vortexcodes/deadmau5-helmet/docs/why-songs-stop-review.md

# Why songs stop: the code review of 31 Oct 2026

Three read-only reviewers. Their skeptics were stopped before finishing, so nothing here is independently confirmed, and some items are already fixed (see HANDOFF.md). Line numbers are from that morning.

## [high] Weak home Wi-Fi: the socket hangs or dies mid-song and the page does not notice

- **Where:** Line numbers as of 12:58 PDT; ui.js and mau5offline.py are being edited by other sessions, so function names are given too.
remote/offline/wire.js:536-579 (_openSocket), 614-622 (reopen), 915-931 (busy), 935-938 (send)
remote/offline/ui.js:185-203 (watchLink), 224-232 (step)
(scratch)/wled1601/udp.cpp:441-455, 485
(scratch)/wled1601/FX_fcn.cpp:1695-1701
(scratch)/wled1601/network.cpp:440-448
(scratch)/wled1601/wled.cpp:510, 700, 713-714, 947-951
(scratch)/fwbuild/WLED/.pio/libdeps/esp32_eth/AsyncTCP/src/AsyncTCP.cpp:1086-1096
(scratch)/fwbuild/WLED/.pio/libdeps/esp32_eth/ESPAsyncWebServerWLED/src/AsyncWebSocket.cpp:510-513
Evidence: (scratch)/uptime.log
- **Trigger:** The controller is on a different access point from every earlier reading. Today it is on BSSID E0:63:DA:71:F4:EF, channel 6, at -84 to -95 dBm. From Oct 27 to Oct 30 it was on E0:63:DA:84:03:1E, channels 1 and 11, at -52 to -66 dBm. In uptime.log up to 12:58, 43 of 115 GETs got no answer in 4 s (37%), up to 5 in a row (about 95 s), while uptime kept rising, so these are link outages and not restarts. Only the IP path crosses this link; a phone on the helmet's own AP does not, which fits the owner's 'over IP'. The last good reading on the old AP was Fri 18:46 PDT, so this only explains an incident after that time. Ask when it happened.
- **Path:** 1. Frames stop arriving. After realtimeTimeoutMs (2500 ms, cfg if.live.timeout 25), udp.cpp:485 calls exitRealtime, and show() blends the empty frozen segments (FX_fcn.cpp:1695-1701), so the helmet goes dark.
2a. If the link stalls for 5 s, AsyncTCP's default 5 s ack timeout (AsyncTCP.cpp:1086-1096) closes the socket (AsyncWebSocket.cpp:510-513). The browser sees the close when the link returns.
2b. If the STA association drops, network.cpp:447 clears interfacesInited and wled.cpp:947-951 runs initConnection: WiFi.disconnect(true) and WiFi.mode(NULL) (wled.cpp:700, 713), then another attempt every 18 s until it joins. The netif going away aborts the sockets on the controller (lwIP behaviour, not measured), and the RST cannot reach the browser.
3. In the browser ws.readyState stays 1. busy() waits 1 s plus 1.5 s, sends 3 more frames, and repeats forever; it never closes the socket. reopen() only runs when link.ws is null (wire.js:938). watchLink says nothing while readyState is 1 (ui.js:186-193). I simulated this against a copy of wire.js: after 20 s it was the same socket, 1 open, 0 relayouts, 24 frames and about 100 kB queued.
4. In case 2b the page learns only at the next TCP retransmit, which draws an RST. Retransmit gaps double, so after a long outage the wait can be about as long again (general TCP behaviour, not measured). A reload opens a fresh connection and works at once.
- **Symptom:** LIGHTS go dark about 2.5 s after the last frame. The page shows no warning, and its preview and clock crawl at 3 frames per 2.5 s. MUSIC keeps playing: the song is a blob from IndexedDB with no network dependency. The lights come back without a reload once the link and socket recover, but a reload is the quick cure in case 2b. A reload is also what stops the song, so 'it stopped, I had to reload' fits this path. That last link is an inference.
- **Fix:** Today: ask whether the helmet moved. While idle, GET /json/net to list each AP's BSSID and RSSI. It starts a scan that takes the radio off channel, so never do it during a stream. WLED only picks the strongest AP at join time (wled.cpp:510) and never roams, so power-cycle it near the strong AP or pin nw.ins[0].bssid. If the show location is weak, use the helmet's own AP instead.
Code, wire.js: record `this._heard = performance.now()` in onopen, in onmessage and in begin(). At the top of the open-socket branch of busy(): `if (now - this._heard > 4000) { const d = this.ws; this.ws = null; this.unacked = []; this.owed = 0; this.dirty(); try { d.close(); } catch (e) {} return this.inflight >= this.maxInflight; }`. The existing reopen, _relayout and the 'lost the helmet' message then take over. Keyframes every 1 s guarantee a pong, so 4 s of silence is real. Also raise openSocket(1500) in reopen to about 3000, because a handshake on this link can exceed 1.5 s.

## [medium] A tab from before Friday 20:48: any 2.5 s gap or stray 'off' left the helmet dark until reload

- **Where:** remote/offline/wire.js:753-765, 767-784
(scratch)/wled1601/wled.cpp:109-116
(scratch)/wled1601/led.cpp:239-246
Session log: ~/.claude/projects/-Users-jones-deadmau5-app/208332e7-8c9f-4c25-bc21-e9a9df98fa1f.jsonl, 2026-10-31T02:42 and 03:48 UTC
- **Trigger:** A page loaded before the fix was deployed (Fri 20:48 PDT, 03:48 UTC), then either a 2.5 s frame gap more than a minute into a stream, or anything sending 'off'. One real instance: the main session's own hardware test sent 'off' over the owner's stream around 19:40 Friday, and said so at the time.
- **Path:** The old page re-armed the nightlight during binary streaming. WLED's loop skips handleNightlight in realtime (wled.cpp:109-116), so the timer sits overdue. The first gap ends realtime, the nightlight fires, and bri goes to 0 (led.cpp:239-246). Frames then keep arriving at a dark helmet while the old page shows a healthy frame rate, with nothing to turn it back on.
- **Symptom:** LIGHTS only, dark until stop and start or a reload. MUSIC keeps playing. This is the one path I found where a reload was truly required, and the owner's 'not sure if we fixed the crashing, I just had to reload' matches it.
- **Fix:** Already fixed: the current page keeps the nightlight off on the binary path and checks on/bri every 5 s (_keepOn). Settle it by comparing the incident time with Fri 20:48. After the final deploy, reload every open tab on every device.

## [medium] A phone on the helmet's own Wi-Fi cuts a page running on home Wi-Fi

- **Where:** (scratch)/wled1601/network.cpp:422-425
(scratch)/wled1601/wled.cpp:700, 713, 896-904, 915-924, 947-951
firmware/wled-16.0.1-keep-access-point.patch
- **Trigger:** Any device on WLED-AP while the page runs over IP. The owner's phone was on it Friday. Case (a) needs no weak signal.
- **Path:** (a) The last AP client leaves, or the softAP idle timer drops it (IDF default about 5 min; general knowledge, not read here). network.cpp:424 sets forceReconnect even though the home connection is healthy. wled.cpp:896-904 then runs initConnection, which does WiFi.disconnect(true) and mode NULL (700, 713). Home Wi-Fi and every socket on it are gone until it rejoins, then the half-open path above applies.
(b) Home Wi-Fi drops while a client is on the AP. initConnection tears the AP down. When the client rejoins, the count change reaches wled.cpp:919-920, where WiFi.disconnect() stops the search, and the next retry is 300 s later (947).
- **Symptom:** (a) LIGHTS dark for roughly 10-20 s at good signal (estimated from the code, not measured), at what looks like a random moment, or about 5 min after the phone went idle. MUSIC continues and no reload is needed.
(b) The helmet is unreachable from the laptop for up to 5 min. LIGHTS stay dark. A reload in that window fails outright and loses the page, and with it the MUSIC.
- **Fix:** For today: forget WLED-AP on the phone, or turn off its auto-join, whenever the show runs over IP. Firmware: add `&& !Network.isConnected()` to network.cpp:424. The existing keep-ap patch does not cover (a), because it keeps WiFi.disconnect(true) at line 700. It also makes (b) last for as long as a phone stays on the AP, since the search only resumes when the last client leaves. Settle it by asking whether the phone was on WLED-AP, and by the router's client log if it keeps one.

## [medium] Controller restarts: two boots today, with no stream and the LEDs off

- **Where:** (scratch)/fwbuild/WLED/wled00/util.cpp:1025-1067
(scratch)/wled1601/json.cpp:655, 840-844
remote/offline/wire.js:631-641, 767-784
(scratch)/uptime.log
Session log: ~/.claude/projects/-Users-jones-deadmau5-app/208332e7-8c9f-4c25-bc21-e9a9df98fa1f.jsonl, 2026-10-31T19:20:57 UTC
data/cal/psu/ramp.json
- **Trigger:** Power interruption or a crash. Boots at about 12:20:40 and 12:24:23 PDT, with ws=0, live=false and the helmet off (state on:false, pwr 120 before the second one). So no stream, no LED load and no client caused them.
- **Path:** A crash or brownout boot sets a one-shot code, 90 or 91 (util.cpp:1041, 1062), which the first /json/state read returns (json.cpp:655). The first state read after 12:20:40, at about 18 s, has no error key, so that boot was a power-on or a software restart, unless another device read the state first. No session log shows a restart command at that time, so the likeliest cause is power: switch, plug, connector or battery. That is an inference. The cause of 12:24:23 is unknown: the only later state read (12:51) lost its reply, and the code may already be consumed. During a stream the socket then dies as in the first finding; the page's _relayout and _keepOn restore the lights without a tap.
- **Symptom:** LIGHTS dark for roughly 10-60 s (boot plus reconnect; estimated, not measured), then back by themselves. MUSIC continues. A mid-song repeat would look like 'crashing'.
- **Fix:** Ask whether the owner cycled power at 12:20 or 12:24, and check the connector or battery. Have the uptime watcher read /json/state immediately when uptime drops and log `error`; resetReason0/1 are compiled only under WLED_DEBUG (json.cpp:840-844), so this is the only cause indicator in this build. Have hello() and _keepOn pageWarn on error 90 or 91. If the show runs on a battery, test LED load on it: the ramp test reached 33.9 W on Oct 27, and the repo does not record which supply that was.

## [low] On this link start() gives up after one failed request: the song plays and the lights never start

- **Where:** remote/offline/wire.js:644-645 (hello), 691 (begin's POST)
remote/offline/ui.js:499-508 (connect), 649 and 677-679 (start), and playTrack's unawaited `if (!state.running) start()`
- **Trigger:** One timed-out GET or POST during start, on a link where 37% of GETs currently fail. hello() needs 2 GETs and begin() needs 1 POST, which gives a rough estimate of 1 in 4 first tries succeeding at today's signal (0.63 cubed; the POST rate is assumed equal).
- **Path:** A throw in hello() makes connect() return false and start() quits. A throw from begin's POST goes to start()'s catch, which calls link.release() and quits. Nothing retries; comeBack only runs after a hide. The song is already playing because playTrack starts it first.
- **Symptom:** MUSIC plays. LIGHTS never start for that song, and the page says 'no controller at...' or 'could not start'. The owner has to tap start. Not a stop halfway through, but it will happen today if the link stays like this.
- **Fix:** In start(), when connect or begin fails while a song is playing, retry every 3 s until it succeeds or stop is pressed, reusing comeBack's timer.

## [low] A page left open on another device can knock out, or fight, the stream

- **Where:** remote/offline/ui.js:1782 (visibilitychange handler), 1813 (comeBack)
remote/offline/wire.js:832-872 (release), 767-784 (_keepOn)
- **Trigger:** A second device with the page open and previously started, such as the phone on home Wi-Fi, locking or waking while the laptop streams. /json/info showed ws 2 throughout Friday evening's stream.
- **Path:** On hide, stop() calls release(), which posts {on:false, live:false, nl off, segments deleted} over the other device's stream. On wake, comeBack() starts that page's stream without a tap, so two pages interleave DDP frames. Another session is currently changing this hide handling (hiddenStops), so recheck it.
- **Symptom:** LIGHTS blink out for up to about 5 s until _keepOn revives them, longer on a weak link where its GET fails; or the helmet flickers between two shows. MUSIC on the laptop is unaffected. No reload needed.
- **Fix:** Close the page on other devices during a show. Code: in comeBack(), skip the automatic start if /json/info says live is true, meaning somebody else is streaming.

## [low] Deploying over this link can truncate the page on the controller

- **Where:** (scratch)/wled1601/wled_server.cpp:196-226 (207, 212), 233
(scratch)/fwbuild/WLED/.pio/libdeps/esp32_eth/ESPAsyncWebServerWLED/src/WebServer.cpp:184
(scratch)/fwbuild/WLED/.pio/libdeps/esp32_eth/ESPAsyncWebServerWLED/src/WebRequest.cpp:123-124
mau5offline.py:484-511 (_upload), 543 (deploy), 829-854 (deploy_drives), 386 (songs)
- **Trigger:** Running `deploy` today at -87 dBm, with a 138 kB page and 564 kB of analyses (both still growing), or running it while somebody streams.
- **Path:** handleUpload opens the target with "w" at the first byte (207), which truncates it at once. An idle gap of 3 s (WebServer.cpp:184) closes the request and the partial file stays (WebRequest.cpp:123). _upload then tries /edit, which is GET-only on 16 (233), and exits. The page is left truncated. Write errors are also ignored (212), so an upload past the end of the filesystem still answers 'File Uploaded!'. deploy_drives has no free-space check and no read-back; deploy() has both, but only for the page. deploy() has no check for live or ws either; the guard exists only in the main session's shell commands. Separately, `songs` exits if its first GET (386) or the pointer upload fails on this link.
- **Symptom:** Unlikely to be what the owner saw, but a high risk for today. The next page load is blank or fails decoding, so neither MUSIC nor LIGHTS can start until a redeploy, on the AP as well. A deploy during a stream also starves frames, so LIGHTS stutter or go dark for the length of the upload.
- **Fix:** Deploy only with strong signal, or from a laptop joined to the helmet's AP with --host 4.3.2.1. In deploy(): refuse if info.live or RSSI is below about -75 unless forced, and retry the upload until the read-back matches. In deploy_drives: check free space and read back each file.

## [low] Tonight on the helmet's own Wi-Fi: official 16.0.1 tears the AP down, and the keep-ap build is not flashed

- **Where:** (scratch)/wled1601/wled.cpp:713-714, 915-924, 947-951
firmware/README.md
firmware/WLED_16.0.1_ESP32_Ethernet_keep-ap.bin
- **Trigger:** A phone on the AP with home Wi-Fi out of range: a retry every 300 s, every 18 s with nobody on the AP. At home, any drop of the weak home link has the same effect. The session logs show the only firmware flash was the official 16.0.1 on Fri 07:13; the keep-ap curl appears only as README text.
- **Path:** wled.cpp:947-951 runs initConnection, and WiFi.mode(NULL) (713) stops the whole radio including the AP. The phone is dropped and its socket dies. stac changes from 1 to 0, which re-inits again (922), and when the phone rejoins the search is stopped (920) until the next 300 s retry.
- **Symptom:** Not the IP report, but it is the owner's Friday phone complaint. Every 5 min the LIGHTS go dark until the phone rejoins and the page reconnects. MUSIC continues. A phone may not rejoin by itself.
- **Fix:** Needs the owner's go-ahead: flash keep-ap with the page stopped, over the AP or at strong signal, never at -87 dBm. Untested option with no flash: blank the home SSID in WLED for the night. isWiFiConfigured then goes false and no retries run, but the home path is gone until it is restored.

## [low] Possible crash race: frames flowing while _relayout rebuilds segments after a restart

- **Where:** remote/offline/wire.js:614-622, 631-641
(scratch)/wled1601/json.cpp:451-466
(scratch)/wled1601/udp.cpp:477-482
(scratch)/wled1601/FX_fcn.cpp:1695-1701
(scratch)/wled1601/FX.h:909-910
- **Trigger:** A reconnect after a controller restart, when one segment becomes ten while the page is already sending binary frames. Read in the source only; not reproduced and no evidence it has happened.
- **Path:** _relayout's live:false ends realtime in the async task (json.cpp:457), and that task then appends segments (emplace_back can reallocate). strip.suspend and waitForIt only guard service(). The main loop's show() at udp.cpp:481, driven by e131NewData, walks _segments with no guard.
- **Symptom:** If it hits: a second restart seconds after the first, LIGHTS dark for longer, MUSIC unaffected.
- **Fix:** One line in the page: hold frames until _relayout settles, by setting a flag before openSocket that busy() honours and clearing it when the layout POST ends.

### Ruled out
- Music from the controller side: no controller or network path reaches the audio element. The song is a blob URL from IndexedDB, and every an.stop() or pause I found comes from a user action, el.onended or el.onerror, pickShow, or the Spotify and playlist code. Only a reload or the page dying stops it. A song that stops by itself belongs to the audio and page review.
- Test suite: test_mau5.py and tests_more/* have no path to the real controller (read, not run). Pixels only targets 127.0.0.1, 0.0.0.0 or a stub socket. find_one, _find, urlopen, fetch and WebSocket are stubbed where they would be reached (relay.py:104-107, calib.py:116-121, tools.py:211-255, ctl.py:193-198, relayout.py:20-31, page.py:139 and 613-614). binary.py and wiretest.js use a stub socket. t_lan_ip only runs ifconfig and route. The 192.168.10.172 strings in tests are fake location values.
- Background sessions: the three worktree sessions' logs have no command that contacts the helmet, only greps for addresses. The `mau5offline.py build` and test run at 12:23:47, 36 s before the 12:24:23 boot, are local. Cloud sessions cannot route to 192.168.x without mau5relay, which is not running; mau5eye only calls lan_ip. The only session that touched the helmet is the main one: deploys, hardware tests, and the Friday 'off' covered in the second finding. Its deploys since Fri 19:25 were gated on live=false by shell commands.
- Tools that scan the subnet when given no --host (mau5offline _find, mau5peek, mau5hue, mau5psu, mau5review, mau5doctor, mau5relay): the scan itself is only GET /json/info. Some of those tools then stream or write, but none is run by the tests or by the worktree sessions.
- Song server: keep_pointing makes a local UDP route lookup every 30 s, sends nothing, and only re-uploads /songs.json if the laptop's address changes. It writes once at start and once per address change, a small file. PID 54684 has run since Fri 19:25:51 and its log has no 'moved' line. Two notes: _delete sends DELETE /edit, which WLED 16 does not route, so the pointer survives Ctrl-C (harmless); and new songs need a restart of `songs`, with the old process stopped first because it holds port 8799.
- Filesystem writes during a stream: the page triggers none. Presets and cfg are only written by setupStandby, which refuses while running. Nothing writes cfg.json during a stream.
- WebSocket client limit: 8 on ESP32. cleanupClients closes the oldest only above that (AsyncWebSocket.h:51, AsyncWebSocket.cpp:916-921). Readings were 0 to 2. A reloaded tab's old socket closes on its FIN, or by the 5 s ack timeout at the next send, so sockets do not pile up. The HTTP queue's limit of 6 answers 503, not a crash.
- JSON lock: the binary path takes none, since 'p' returns before the lock (ws.cpp:40-44) and DDP and the filler never take it. _keepOn's one GET per 5 s can at worst defer. A main-loop sendDataWs waits at most 250 ms and then sends {"error":3}, which the page handles.
- Heap: 79-91 kB during Friday's stream of about 25 fps, 64-93 kB today idling on the weak link, no slide over 34 min. heapDanger needs contiguous heap under about 14 kB for 15 s (wled.cpp:185). ws.closeAll(1013) needs a failed allocation. Neither is near.
- Streaming load: boot Fri 17:36:36 lasted at least until 20:49 (11583 s) through more than an hour of binary streaming at about -60 dBm with no restart. So a stream crashing 16.0.1 is not supported at good signal.
- Watchdogs: the loop watchdog is off (wled.h:63-66), async_tcp is not watched (platformio.ini:267), and the IDF task watchdog is 10 s on idle CPU0 only. I found no multi-second blocking in the stream path.
- Bootloop detection: needs 5 crash resets each under 120 s apart (util.cpp:1043-1045), and power or software resets clear the count. Not reached.
- Brownout from LED current: the ramp test ran to 33.9 W with no reset, WLED's global limiter holds frames near 1.5 A total, and today's boots happened with LEDs off. Not excluded on a battery, which has not been tested.
- Reboot commands: rb, /reset, cfg.json upload and /update are not sent in any normal path. The one `{"rb":true}` in the logs is a scratch test on Fri 04:36.
- Filesystem room: 564 kB of analyses plus the 138 kB page against 983 kB total fits as of 12:58, but watch the total as scenes are added, since uploads past the end report success.
- Which machine: Friday's stream reported lip 192.168.10.163 (hostname macbookpro, private MAC), not this laptop at 192.168.10.225. Confirm which machine the owner means before blaming background CPU load here.

## [high] A pause from outside the page (media key, headset button, phone call, Bluetooth drop) stops the song, freezes the lights and says nothing. This is the only mid-song stop recorded on this Mac.

- **Where:** remote/offline/ui.js:1112-1124 (playTrack sets onended and onerror, no onpause); ui.js:261 (show clock is el.currentTime); ui.js:1455-1465 (showpp button, 700 ms label refresh); ui.js:1807 (the only auto-resume, on visibility return); audio.js:301 (handlers cleared on stop)
- **Trigger:** macOS media key (F8), a headset or speaker button, AirPods, or any now-playing command while the page is the active media session. On phones: a call, Siri, an alarm, another app taking audio focus, or a Bluetooth or headphone route loss.
- **Path:** Measured on this Mac (192.168.10.225), from pmset -g log and Chrome's song store for the page's origin. Chrome PID 1836 started Strobe (Dimension Remix) at 19:00:11 on Oct 30 (store write and Video Wake Lock in the same second, audio from about 19:00:12). At 19:02:11 rcd, the macOS remote-control and media-key daemon, logged com.apple.rcdevent. At 19:02:14 Chrome released 'Playing audio' after 00:02:02, about 2:00 into a 5:09 song. The Video Wake Lock from the page's muted awake video stayed until 19:05:50, so the page was alive and only the audio element had paused. Control case: leavemealone at 18:55:12 ran 00:03:43, its full 222.76 s, with no rcd event. At 19:42:40 an rcd event and a Chrome video wake-lock release land in the same second, which shows the same key pausing Chrome media on this Mac. Code path: OS command -> Chrome media session -> el.pause() with no JS involved -> no pause listener, userPaused stays false -> step() keeps reading the unchanged el.currentTime (ui.js:261) -> the show draws the same moment on every frame -> showPP relabels the button 'play' within 700 ms and nothing else is said. In the Play Music set nothing advances, because ended never fires. Limits of this evidence: the log does not say who or what caused the rcd event. It may have been a deliberate press, since other Chrome audio started at 19:04:39 and the Tiki Tiki file was downloaded at 19:07:37. It is one stop, and the owner said 'sometimes'. His stops may have been on another machine: the helmet logged 192.168.10.163 as its live sender at 19:22-19:42 and 20:07-20:32 on Oct 30, and that device fetched all six songs including Tiki. This Chrome has no Tiki copy and no store write since 19:00:13 Oct 30. The router names .163 macbookpro.localdomain, not a phone, even though this session's summary calls it the phone. To settle it, ask which machine and browser he used, and if .163 is a Mac run there: pmset -g log | grep -E 'rcdevent|Playing audio'
- **Symptom:** MUSIC stops. LIGHTS keep streaming but hold one frozen moment, with a normal fps reading. No reload needed: tapping play in the show box resumes at the same spot, while a reload loses the position (see the reload finding). Desktop Chrome: media keys and headset buttons, confirmed by the Mac's power log. iOS Safari and home-screen app: interruptions and route loss pause the element, and the audio context usually goes 'interrupted' too (see the AudioContext finding). Android Chrome: audio focus loss, or the 'becoming noisy' event when headphones or Bluetooth drop; a transient loss resumes by itself, a permanent one does not. The phone behaviours are from memory, not measured.
- **Fix:** In playTrack, beside onended: el.onpause = () => { if (an.el !== el || userPaused || el.ended) return; pageWarn('the song was paused from outside this page (media key, headphones, a call or another app) -- tap play'); showPP(); }; and add onpause to the handlers cleared at audio.js:301. The el.ended guard covers the pause event that fires at a natural end. On desktop also try if ('mediaSession' in navigator) navigator.mediaSession.setActionHandler('pause', () => {}), which stops the key reaching the element; whether that API exists on this http origin is unverified, so check in the console first. Cheap and worth having tonight: once in _fileEl(), listen for pause, waiting, stalled, error, ended, emptied and abort, plus ctx statechange, and write the last event with its time into #why, so the next stop names its own cause.

## [medium] The audio context can leave 'running' with nothing watching it, silencing an element that still reports playing. A dead context is the one path in the code that truly needs a reload.

- **Where:** remote/offline/audio.js:167 (_ctx resumes only on 'suspended', so it misses Safari's 'interrupted'); audio.js:247 and 271-279 (the sound is routed only through the context); audio.js:257 (unlock); ui.js:1806 (resume on visibility return only); ui.js:1455-1459 (showpp resumes neither the context nor anything else). There is no onstatechange or ctx error handler anywhere.
- **Trigger:** Desktop: output device failure or removal, an audio service restart, or a Bluetooth or HDMI output vanishing. iOS: any interruption, screen lock or app switch. Android: rare.
- **Path:** ctx leaves 'running' while the page is in front -> the element is wired only through createMediaElementSource, so its output goes nowhere audible -> el.paused stays false, so showPP says 'pause' and the page looks healthy. From memory of Chromium, not measured: nothing pulls the element while the context is stopped, so currentTime stalls and the lights freeze at ui.js:261. On Safari the clock may run on silently, so the lights carry on with no sound. Recovery exists only on a visibility flip, or a tap on start, Play Music, next or prev, which call unlock. On iOS the resume from visibilitychange has no gesture behind it and may not take; at that point showgo means stop, and showpp does not resume the context, so stop then start, from 0:00, is the only remedy. If the context is actually dead, an.ctx is kept for the life of the page and the single element can only ever be wired to it, so every later song is silent until a reload. That matches 'I just had to reload'. No evidence for this on this Mac: the built-in speaker session ran unbroken from 19:00:12 to 20:45:34 across the 19:02:11 stop. To settle it, watch the statechange logging suggested in the media-key finding, or on an iPhone lock the screen mid-song and come back.
- **Symptom:** MUSIC goes silent with no message. LIGHTS freeze on desktop Chrome and may keep running on Safari. Desktop Chrome: reload needed only if the context never recovers. iOS Safari and home-screen app: the most likely way to lose sound; a tap on start or Play Music recovers it, and a home-screen app may be purged and reload by itself. Android Chrome: rarely reached.
- **Fix:** Change audio.js:167 to if (this.ctx.state !== 'running' && this.ctx.state !== 'closed') this.ctx.resume(). In _ctx add this.ctx.onstatechange that attempts a resume and warns on the page. Add one capture-phase document pointerdown listener: if the context is not running, resume it; if an.el is paused, !userPaused and not ended, play it. Then any tap anywhere revives sound without restarting the song. Add a 1 Hz check: el not paused, not ended, currentTime unchanged for 3 s -> resume, then warn 'no sound: reload' if still stuck. Routing the sound straight out of the element when a show has its drive would remove this whole class, but that is too large a change for today.

## [medium] Safari only: re-storing a song at start deletes the file the audio element is still reading, so it stops once its buffer runs out. Fixed for cached plays in the working tree, still live on any page not yet redeployed and reloaded.

- **Where:** Committed playTrack (HEAD, since eaaeafc) calls tracks.put(name, file) on every show start; the working tree skips it for cached copies at remote/offline/ui.js:1133 (kept). Writes that can still replace a record: ui.js:1412 (fetchSongs, now also on a wrong-size copy) and ui.js:1439 (load all the songs). Read side: audio.js:636-638.
- **Trigger:** WebKit only, on macOS Safari, iOS Safari or a home-screen app: tap start on a song from the stored copy, with a page from before this session's changes. This is relevant only if .163 or the phone runs Safari. This Mac's Safari has no helmet origin stored.
- **Path:** tracks.get wraps the stored blob -> el.src = blob URL -> tracks.put overwrites the same key. From memory of WebKit source, unverified: the IndexedDB backend deletes the old blob file when the transaction commits, and unlike Chromium it keeps no registry of blobs still handed out. The element keeps playing what is already buffered. The next range request to the blob URL finds no file, the classic 'WebKitBlobResource error 1' in the console. The old page had no error handler, so the song stalls with lights frozen and no message. A reload reads the new copy, which fits 'I just had to reload', until the next start repeats it. How far a song gets depends on the buffer, which fits 'sometimes'. Chrome is immune by measurement: leavemealone's record was replaced at 18:55:12 on Oct 30 while it played, and audio still ran the full 00:03:43. To settle it, ask which browser .163 uses, then on Safari play one long song from the stored copy with the console open.
- **Symptom:** MUSIC stops part way through a song. LIGHTS freeze on the last moment. On the old page a reload appears to fix it, and the current page's onerror would now name the failure. Desktop Chrome and Android Chrome: not affected. macOS Safari, iOS Safari and home-screen app: affected until the new page is deployed and every open tab is reloaded.
- **Fix:** Already done for cached plays with kept at ui.js:1133. Deploy, and reload the page on every device. Add a small guard: in the fetchSongs and load-all paths, skip or defer tracks.put when name is the show currently playing, so a wrong-size re-fetch cannot replace the file under a playing song.

## [medium] A reload, crash or browser purge throws away the song, its position and the set, with no way back to where it was

- **Where:** remote/offline/ui.js:466-479 (restore ignores the saved show); ui.js:461 and 1832 (choose() at load runs save(), overwriting the saved show with an empty value); ui.js:1791 (pagehide lets go of the helmet); ui.js:1142 (the page claims 'pause and seek work', but there is no seek control)
- **Trigger:** Any reload, which is what the owner reports doing, or a tab crash, tab discard, or an iOS web-process purge or relaunch.
- **Path:** pagehide releases the helmet -> audio element and context die with the page -> on load the show list is back to 'no show' and the saved show has already been overwritten -> nothing restarts the music or the lights until someone picks a show again -> the song restarts at 0:00 and the Play Music set is forgotten. This does not cause a stop, but it turns a recoverable pause into a lost song, and 'I just had to reload' suggests that is what happened: the recorded media-key stop on this Mac needed only a tap on play.
- **Symptom:** MUSIC and LIGHTS both stop and do not come back without re-picking a show. Same on desktop Chrome, iOS Safari and Android Chrome. A home-screen app purged in the background also relaunches into this state with no tap by anyone.
- **Fix:** Every 2 s and on pagehide, save {show, at: el.currentTime, listOn} to localStorage. At load, restore the selection before choose() saves over it, and show one button: 'resume <song> at m:ss'. On tap call an.unlock(), start the song, and set el.currentTime = at once metadata is loaded, restoring list.on too. A tap is required for sound anyway. Meanwhile tell the owner: if a song stops, try the play button before reloading.

## [low] On a laptop a stray key on the last-clicked control stops or changes the song

- **Where:** remote/offline/ui.js:1062-1077 (showgo), 1648 (go, which now also stops the song), 1291 (playall), 1296 (listnext), 1056-1061 (select change -> pickShow -> an.stop at ui.js:997)
- **Trigger:** Chrome window in front with focus still on the button or select last clicked, then Space or Enter, for example the pause reflex on a laptop or typing meant for another window. On a focused select, a printable key triggers type-ahead: 'n' jumps to 'no show' and any letter can match an option with no check mark yet. On macOS, Safari does not focus buttons on click but keeps focus on the select.
- **Path:** Space or Enter on a focused button fires click -> showgo or go runs its stop branch, an.stop() -> or playall runs listEnd plus stop -> or listnext skips. On the select, type-ahead fires change -> onchange -> pickShow(new or empty) -> an.stop() at ui.js:997, or listJump during the set. Not distinguishable from outside: nothing logs it, so whether it ever happened is unknown. To settle it, ask whether he had typed or pressed Space with that window in front.
- **Symptom:** MUSIC stops at once, or jumps to another song. LIGHTS fall back to the preset or stop. No reload needed. Desktop only; iOS and Android have no keyboard in this flow.
- **Fix:** One listener: document.addEventListener('click', e => { const c = e.target.closest('button'); if (c) c.blur(); }), and e.target.blur() at the end of sel.onchange. Optionally map Space to the showpp toggle so the reflex does the expected thing.

## [low] A lost IndexedDB connection is cached forever, so every song looks missing until a reload, and the set ends at the next song boundary

- **Where:** remote/offline/audio.js:608 and 616 (this.db cached, no onclose or onversionchange), audio.js:624 (db.transaction throws on a closed connection), audio.js:638 and 657 (errors become null and an empty list); remote/offline/ui.js:1229-1240 (listSkip), ui.js:1038-1046 (startShow opens the file picker on a miss)
- **Trigger:** From memory, not measured: Safari and iOS losing the connection to the IndexedDB server after backgrounding ('Connection to Indexed Database server lost'), or a Chrome storage service restart or site-data clear.
- **Path:** Connection closes -> this.db still set -> db.transaction throws InvalidStateError inside the promise -> get returns null and keys returns [] with nothing said. In the set, the song in progress finishes -> listSkip finds nothing -> listEnd and 'no songs on this device yet'. For a single show, start opens the file picker as if the song were never saved, and the song line says 0 of N. A reload reconnects, and everything is suddenly fine again. To settle it, use a playlist on an iPhone with an app switch mid-song, then let the song finish.
- **Symptom:** MUSIC stops at the end of the current song and the set does not continue; the song already playing is not cut. LIGHTS go to the preset. A reload fixes it. Desktop Chrome: rare. iOS Safari and home-screen app: plausible after any trip to the background. Android Chrome: rare.
- **Fix:** In _open: on success set db.onclose = () => { if (this.db === db) this.db = null; } and db.onversionchange = () => { db.close(); this.db = null; }. In _tx, wrap db.transaction in try/catch, clear this.db and reopen once before giving up.

## [low] New in the working tree: a double tap on start now leaves no music, because the first start's failure stops the second start

- **Where:** remote/offline/ui.js:1144-1150 (catch added at about 12:56 calls an.stop()); remote/offline/audio.js:266-267 and 283 (useFile calls stop, then awaits el.play); ui.js:1062-1066 (showgo calls startShow while an.el is still null)
- **Trigger:** A second tap on start during the first tap's tracks.get. The read is normally milliseconds, but a busy disk stretches it and makes a second tap likely. Any second playTrack arriving while the first is awaiting el.play() behaves the same.
- **Path:** Tap 1 and tap 2 both pass the check state.showT0 === null && !an.el -> useFile #1 awaits el.play() -> useFile #2 calls this.stop(), which pauses the shared element, then sets a new src and awaits play -> #1's promise rejects with AbortError in a later task -> #1's catch calls an.stop(), which pauses #2 on the shared element, revokes its URL and clears an.el -> #2 rejects too and its catch does the same. Before this catch was added, #1 only printed a message and #2 played. listPlay is protected, because pickShow stops the first start before the second reaches useFile. This code is not deployed, so it is not what the owner saw. Traced by reading the code, not run.
- **Symptom:** MUSIC never starts, or stops immediately, with the message 'could not play that file: The play() request was interrupted'. Tapping start again works. No reload needed. Same on all platforms.
- **Fix:** At the top of the catch: if (err && err.name === 'AbortError') return false; so a superseded start leaves the newer one alone. Alternatively take a token at the start of playTrack and only call an.stop() if the token is still current.

## [low] Unproven on a real phone: the second song of the set plays through one element whose src changes while wired into the audio graph

- **Where:** remote/offline/audio.js:240-250 (_fileEl), audio.js:266-271 (useFile); remote/offline/ui.js:1112-1113 (ended -> listSkip)
- **Trigger:** Play Music on a real iPhone or Pixel when the first song ends. Page tests use FakeAudio and FakeContext, so they cannot show this.
- **Path:** Reusing one element is the right design: a phone only lets an element start itself after a tap has started it. But from memory, older iOS versions had silent-output bugs when src changed on an element already wired to a MediaElementSource. If that applies here, song 2 has a running clock and moving lights with no sound. I could not verify this without a device, and the task forbids starting browsers. To settle it, shorten nothing: on the real phone start Play Music, tap next once to reach song 2, and listen.
- **Symptom:** If the problem exists: MUSIC silent from the second song on, LIGHTS running normally, and a reload does not help because it recurs on song 2. Desktop Chrome: reusing a wired element is a common pattern and is expected to work. Android Chrome: same as desktop. iOS Safari and home-screen app: the open question.
- **Fix:** Run the one-minute real-phone test before the show. If song 2 is silent on iOS, the smallest workaround is a new element and a new createMediaElementSource per song, played inside the next tap, accepting that unattended advance will not work on iOS.

### Ruled out
- Fixed in the working tree while I read, and confirmed in the code: the element error handler (ui.js:1119), no re-store on cached plays (ui.js:1133), the analysis fetch capped at 1.5 s so a poor link cannot hold up a song or end the set (pickShow), and a size check on fetched songs (ui.js:1367 and 1410). All of these need a deploy and a reload on each device.
- Truncated stored copy, cleared on this Mac: all five stored files match the source MP3s to the byte (13322987, 20381996, 12603025, 7962134, 7130157). The song server sends Content-Length and logged complete sends of all six songs to .163. The sizes on .163 itself were not checked.
- Early ended from the files themselves or VBR duration estimates, cleared: I walked the frames of all 16 MP3s. Every Xing or Info frame count equals the real frame count, there are no junk gaps, and only beneath is VBR. A full ffmpeg decode of each ran to the end with zero errors. The 8 shows that already have a json match their song's length, for example 636.89 s for Strobe and 274.41 s for beneath. Fred's real audio session of 00:03:43 against 222.76 s confirms a clean natural end on this Mac.
- Wrong song stored under a show, cleared for the set: the page's own showForFile, run in node, maps all 16 clean names and all 11 mp3.pm download names correctly, including Some Chords against its Radio Edit and Strobe against its remixes. Only a file literally named 'Ghosts n Stuff.mp3' goes to Moar Ghosts, and no such file is in the set.
- Hidden or occluded tab pausing the music, cleared on desktop Chrome by measurement: the page's wake lock dropped at 18:55:56 and returned at 18:56:03, which is how a hide looks in the log, while 'Playing audio' ran an unbroken 00:03:43. That path stops the LIGHTS only, and the working tree's worker clock now addresses that. On phones it differs: Android keeps the audio playing, and iOS stops it, per the AudioContext finding.
- Chrome Memory Saver, tab discard and tab freezing, cleared for a song in progress: from memory of Chrome's rules, audible tabs are exempt. A tab left hidden after a pause is no longer audible and could later be discarded, which then becomes the reload finding. Energy Saver (this Mac was at 15-17% battery that evening) throttles timers and video frames, not audio; also from memory.
- Page crash or Chrome restart on this Mac, cleared: every Chrome log line from Oct 29 22:21 to Oct 31 12:12 is the same PID 1836. Crashpad's completed and pending folders are empty and untouched since early October, and DiagnosticReports holds no Chrome entries. A renderer killed outright leaves no dump, but no page audio session ended unexplained. .163 was not checked.
- Cloud sessions, the laptop song server and helmet restarts as a direct cause of the music stopping, cleared by reading the code: wire.js never touches the Analyser, nothing in the page reloads itself, tick failures call stop() which leaves the song alone, and a stored song needs no network to play. Test browsers ran as separate Chrome processes (PIDs 48126, 54821, 57076, 65285, 65638, 66083). They can disturb the LIGHTS, not this page's audio.
- Object URL revocation, cleared: revoked only in Analyser.stop (audio.js:302), immediately before the element gets a new source or is abandoned.
- Garbage collection of the detached Audio element, cleared: an.fileEl holds it for the life of the page in the working tree, and an.el held it in the deployed page.
- Disk full or storage eviction, cleared on this Mac: 228 GB free and the store is intact. Eviction would show as a file picker at start, not a mid-song stop.
- Output device change during the recorded stop, cleared on this Mac: the built-in speaker session ran unbroken from 19:00:12 to 20:45:34 on Oct 30. On other machines this remains a trigger under the AudioContext finding.
- Spotify following, cleared unless the owner turned it on: state.follow is not saved and needs a tap on its button. Only then can spPoll switch shows (ui.js:1574 -> pickShow -> an.stop), and Play Music turns following off.
- Other an.stop callers, cleared as user actions only, none fires by itself: silence (ui.js:819), a preset button (ui.js:1638), lights only, the show stop button, go stop, and the set's end, which is ended by the 1.5 s watchdog at ui.js:1325 only when the song is already gone.

## [high] ALREADY CHANGED IN THE WORKING TREE. Covering the laptop's Chrome window ran the phone's 'pocket' stop: lights off, song still playing

- **Where:** Old behaviour: visibilitychange handler calling stop(), now remote/offline/ui.js:1792-1803 and gated by hiddenStops() at ui.js:164. Worker clock that replaces it: ui.js:143-161. stop() is ui.js:687-706 and never touches an.el. Auto-resume: comeBack() at ui.js:1823-1829.
- **Trigger:** On macOS, Chrome reports a page as hidden when its window is fully covered by other windows, moved to another Space or a full-screen app, or minimized, when the display sleeps, or when the tab loses focus, including a background session opening a tab in that window. A partly covered window does not count. This matches 'other windows over the top of it'. Not measured on this laptop: the occlusion behaviour is from my knowledge of Chromium. I was not allowed to start a browser.
- **Path:** The hidden event fires while state.running is true. stopNote is set, then stop() runs: runs++, state.running=false, timers cleared, link.release() sends a beacon that turns the helmet off or hands it to standby. an.el keeps playing because stop() has no reference to it. When the page is visible again, the handler calls pageWarn(stopNote) and comeBack(), and start() is retried every 3 s until it works.
- **Symptom:** LIGHTS stop within a frame. MUSIC keeps playing. No reload was needed: lights come back at the right place in the song when the window is uncovered. On a weak link that restart can take up to about 30 s (sum of the 5 s request limits in hello and begin) with the button saying 'stop', which looks like a hang and invites a reload. If the song ended while covered, the page came back on a plain preset. The signature is the amber line 'the helmet went off while this page was out of sight', which would have been on the page. Ask him if he remembers it. He said the song stopped, and this path leaves the music playing.
- **Fix:** Already done in ui.js: on a machine with no touch screen the loop stays running on a worker clock while hidden. Two things are left. Deploy it, since the page he used had the old code. Then test by covering the window for a whole song with the heavy jobs running and reading fps and dropped afterwards. I have not verified that the worker clock holds frame rate on the real laptop under CPU load, because macOS may lower a hidden renderer's priority.

## [medium] ALREADY CHANGED IN THE WORKING TREE. A silent socket that stays open looked healthy, and stop plus start reused it, so only a reload helped

- **Where:** remote/offline/wire.js:539 (openSocket returns true for readyState 1), wire.js:687 (hello), wire.js:932-959 (busy; the new limit is wire.js:934-944 with SOCKET_QUIET_MS at wire.js:203). ui.js:186-192 (watchLink says nothing while readyState is 1). ui.js:305 (dropped leaves out link.lost). Firmware: wled.cpp:927-938 (Wi-Fi loss re-initialises the connection), udp.cpp:485 and udp.cpp:441-455 (realtime exit).
- **Trigger:** The controller restarts or drops off Wi-Fi without the laptop's TCP being told. Today's uptime log shows both in play: 36 of 90 GETs timed out at 4 s, at -84 to -92 dBm, with restarts around 12:20:40 and 12:24:23.
- **Path:** Before the watchdog: readyState stays 1, so frames keep going into the socket and pongs stop. busy() gives up on 3 frames every 2.5 s and sends 3 more. I simulated this on the old wire.js with a fake clock and socket: 72 frames in 60 s (1.2 fps), 72 lost, refused 0, failed 0, same socket, never closed by the page. Stop plus start then gave hello ws:true, the same socket, and 12 frames in 10 s. It ended only when TCP died. A retransmission reaching a rebooted controller draws a reset, but the back-off doubles (from memory of TCP behaviour), so that can be tens of seconds after the helmet is back. It is permanent if the controller keeps the connection but stops answering; see the split-packet finding.
- **Symptom:** LIGHTS go dark about 2.5 s after frames stop arriving (realtime exit). MUSIC keeps playing. The page showed a good connection line, about 1 fps, dropped 0 and no warning, because link.lost is not displayed and 'lost the helmet' only runs once the socket closes. Stop and start did not help; a reload did. This is the best match in this surface for 'I just had to reload'.
- **Fix:** Already done: a socket quiet for 6 s with frames outstanding is closed and replaced. On the current wire.js a silent socket was closed and a new one came up (quietCloses counted, back:true). Small remainder: add link.lost and link.quietCloses to the count at ui.js:305 so this is visible next time.

## [medium] PARTLY CHANGED. A song that stops without an 'ended' event freezes the lights on the last frame, and the page still reports a healthy frame rate

- **Where:** remote/offline/ui.js:261 (the audio element is the clock), ui.js:283 (a send result of 0 counts as a delivered frame), wire.js:977-981 (an identical frame returns 0, with a keyframe each second). New error handler: ui.js:1119-1126. Pause button label: ui.js:1330-1334.
- **Trigger:** Anything that stops the audio element without 'ended'. On the page he used, a read or decode failure qualified, since there was no onerror then. In the current code, a pause nobody tapped still qualifies, such as a keyboard media key or a headset. What actually stops the element belongs to the audio review; this entry covers what the loop does when it happens. I did not find a trigger inside the render loop or the link.
- **Path:** an.el.currentTime stops moving, so show.frame draws the same frame. link.send returns 0, which ui.js:283 counts as delivered. A keyframe each second keeps realtime mode alive, so the helmet holds that frame indefinitely.
- **Symptom:** BOTH stop: music silent and helmet frozen on its last frame, with a normal fps and no warning. This is the only path I found that matches his words literally. On the old page he needed stop plus start or a reload. Now read errors are reported and handled. A pause or stall with no error still only flips the pause button to 'play'.
- **Fix:** In step(), track when currentTime last moved. If an.el exists, is not ended, and the time has not moved for 2 s, call pageWarn saying the song paused or stalled, and if an.el.paused && !userPaused try an.el.play().

## [medium] ALREADY CHANGED IN THE WORKING TREE. A 1.5 s limit on reconnecting meant a weak link could never get its socket back

- **Where:** remote/offline/wire.js:635 (was openSocket(1500), now REOPEN_WAIT_MS at wire.js:195), wire.js:631-639 (reopen), firmware ws.cpp:28 (state JSON built for each client that connects). New behaviour between sockets: wire.js:1023.
- **Trigger:** A WebSocket handshake slower than 1.5 s, which one lost SYN or a busy controller causes at -85 dBm.
- **Path:** Socket closes, reopen tries every 3 s, and giveUp closes each attempt at 1.5 s just before it lands. Simulated on the old limit with a 2 s handshake: 10 attempts in 30 s, never connected. With a 1.2 s handshake it connected first try. Each abandoned attempt can also cost the controller a client and a state JSON. Separately, from memory of Chromium (unverified), repeated failed handshakes add a 1 to 5 s throttle that a 1.5 s limit could never outlast.
- **Symptom:** LIGHTS crawled on whole JSON frames by POST, with 'lost the helmet N s ago' on the page. MUSIC kept playing. It recovered by itself only if a handshake got in under the limit. A reload connected with nothing else going on, so it looked like the fix.
- **Fix:** Already done: 6 s. On the current wire.js a 2 s handshake connected. Note the new trade-off at wire.js:1023: on WLED 16 nothing is sent between sockets, so the helmet is fully dark during a reconnect rather than slow. That looks right, but it should be seen once on the helmet.

## [low] OPEN. Sending the 7-byte 'p' before its filler can cut every later DDP packet inside its WebSocket header, and the page cannot see it

- **Where:** remote/offline/wire.js:989-990 (binary path) and wire.js:1009-1012 (JSON path). Firmware ws.cpp:36 and ws.cpp:99-118: a split binary message is dropped with no reply, and only text gets {"error":9}. wire.js:581-585: refused counts only text errors, so the '0 refused' measurements say nothing about binary frames.
- **Trigger:** TCP limited by its congestion window rather than the controller's receive window, with a round trip of 60 ms or more and 7 to 1428 bytes of window free when 'p' is written. Loss and retransmission at -85 dBm is where that would happen. Model only, not observed on hardware.
- **Path:** The two DDP packets go out, then 'p' leaves alone because Chrome uses TCP_NODELAY (from memory of Chromium). The 1429-byte filler no longer fits. The next frame queues behind it, so TCP cuts 1436-byte segments starting at the filler: filler plus the first 7 bytes of the next packet's 8-byte header, and the same cut repeats until the queue drains. In a BSD-style model across 180 congestion regimes, p-first split messages in 56 regimes, 6062 splits, every one 7 bytes into the header. Filler-first split nothing in those 180. Its only remaining regime is 1429 to 1435 bytes free, where the cut falls in the payload rather than the header. I could not read the library, as it is not on this machine. From memory, upstream ESPAsyncWebServer _onData does not bounds-check the header, so plen -= 4 would underflow and unmask 1428 bytes past the segment: heap corruption, then a restart. If it is guarded instead, the stream desyncs and the socket goes silent, which is the wedged-socket finding above.
- **Symptom:** LIGHTS freeze, then go dark after 2.5 s because no packet refreshes realtime, while pongs keep coming, so the page looks healthy at a reduced fps. MUSIC keeps playing. It clears when the queue drains, unless the controller restarts or the stream desyncs. Today's two restarts happened with ws=0 and live=False, so they were not caused by this.
- **Fix:** Swap the two sends in both paths: 'if (this.depth > 1) ws.send(BIN_FILLER); ws.send('p');', and the same with FILLER. The pong still comes after the whole frame. To settle it: capture with sudo tcpdump -i en0 -nn -x 'dst host 192.168.10.172 and tcp dst port 80' while streaming on the weak link, and look for 1436-byte segments whose payload does not start with 0x82 or 0x81. Also read _onData in .pio/libdeps/esp32_eth/ESPAsyncWebServer/src/AsyncWebSocket.cpp after a pio run. Model: (scratch)/linkreview/tcp_model.js

## [low] OPEN. A start that fails is never retried while the song plays, so the song runs with no lights

- **Where:** remote/offline/ui.js:1139 (also ui.js:1087 and ui.js:1600: start() is called, not retried), ui.js:619-685, ui.js:499-508 (connect), wire.js:660-668 (hello), wire.js:703 (begin).
- **Trigger:** Any of the three requests a start cannot do without times out at 5 s: GET /json/info, GET /json/state, or the layout POST. At today's signal, 36 of 90 GETs timed out at 4 s. This is not 'halfway through', so it is low as what he saw, but it is likely to bite on this link.
- **Path:** hello() throws, connect() says 'no controller at ... is the phone on the helmet's WiFi?', quit() puts the button back to 'start'. playTrack has already started the audio and does not check the result. comeBack only retries when stopNote is set, and nothing sets it here. In the playlist the next song tries again; a single song never does.
- **Symptom:** MUSIC plays. LIGHTS never come on for that song. A message blames a phone's Wi-Fi even on the laptop. A tap on start fixes it, so no reload is needed, though a reload also appears to fix it.
- **Fix:** Reuse the existing retry loop at ui.js:1139: if (!state.running) { stopNote = stopNote || 'the helmet did not answer, still trying'; comeBack(); }. A successful start and the stop button both clear stopNote. Reword the message so it does not assume a phone.

## [low] OPEN, NEW WITH THE WATCHDOG. The first frame after an idle pause can close a healthy socket, and a close inside send() leaves a phantom frame

- **Where:** remote/offline/wire.js:934-935 (quiet test against _heard, set only at wire.js:577) and wire.js:965-967 (send captures ws before calling busy).
- **Trigger:** The page has been open for 6 s or more with the socket idle, then Play is tapped, and the first pong takes longer than one frame (33 ms) with no other message having arrived since. It also applies after any stop. Simulated at 60 s idle: closed a healthy socket at pong round trips of 20 ms and up, not at 10 ms. My sim checks busy every 10 ms where the page checks about every 33 ms, so the real threshold is about 33 ms. The sim has no state broadcast. The real controller normally sends one after begin's POST (json.cpp sets stateChanged when nl is present), which refreshes _heard and will usually hide this on a good link. On a weak link that message is late, which is when a false close costs most.
- **Path:** unacked becomes non-empty, _heard is older than 6 s, so busy closes the socket, reopen runs, _relayout posts live:false and the layout. Separately, if the 6 s limit is crossed inside send(), the local ws still points at the closing socket: the frame is discarded, an entry is pushed onto unacked, and it counts against the new socket, adding up to 2.5 s of stall.
- **Symptom:** LIGHTS start late by one handshake at the top of a song (seconds on a weak link, dark because nothing is sent between sockets) and a dropout is counted. MUSIC unaffected. Recovers alone, no reload.
- **Fix:** At the end of begin(), next to this.streaming = true, add this._heard = performance.now(). In send(), make ws a let and after the busy check add: if (ws && this.ws !== ws) ws = null. Do not reset _heard whenever unacked is empty: in a wedge that happens every 2.5 s and would defeat the watchdog.

## [low] OPEN. _relayout is tried once after a reconnect, and its comment expects a retry that never comes

- **Where:** remote/offline/wire.js:648-658 (catch comment at wire.js:657), wire.js:635-637. Firmware: e131.cpp:79-83, FX_fcn.cpp:1695, udp.cpp:426-428.
- **Trigger:** The controller restarts, the socket reconnects, and the layout POST times out, as it can at this signal. Simulated: socket up, 0 relayouts, 0 retries in the next 30 s.
- **Path:** The catch swallows the failure. The comment says the next reconnect tries again, but the socket is up, so there is no next reconnect. Binary frames still land, because realtime writes pixels without the segments and realtimeLock lights a strip that booted off. _keepOn then posts on:true without any frozen segments.
- **Symptom:** During steady streaming the LIGHTS look normal. In any frame gap of 2.5 s or more, the helmet shows WLED's own boot state (its default solid colour or the standby preset, unfrozen) instead of going dark, until the next stop and start. MUSIC unaffected. No reload needed.
- **Fix:** In the catch set this._needLayout = true, clear it on success, and in _keepOn (every 5 s) call this._relayout() when it is set.

## [low] OPEN. A truly lost pong pauses frames for almost exactly the realtime timeout

- **Where:** remote/offline/wire.js:600-601 (1000 + 1500 ms at depth above 1), wire.js:945-955 (busy), udp.cpp:485 (realtime exit at the 2.5 s timeout in the helmet's config).
- **Trigger:** Pongs that never arrive, such as the firmware dropping one. Late pongs do not cause this, because they end the wait early through _pong.
- **Path:** Simulated: pongs missing for 100 ms gave a 2430 ms gap between frames, against a 2500 ms realtime timeout. That leaves a 70 ms margin before any network jitter.
- **Symptom:** LIGHTS freeze about 2.4 s and may blink dark as realtime exits, then recover alone. MUSIC unaffected. No reload.
- **Fix:** On the binary path use the short quiet period: this.owedQuiet = (d > 1 && !this.binary) ? OWED_QUIET_MS : OWED_QUIET_1_MS. hello() already sets this.binary before calling _setDepth. The drift that the long wait protects against comes from JSON backlog, which the binary path does not have.

## [low] OPEN, NEW WITH THE WORKER CLOCK. A worker error while hidden leaves a running loop with no timer

- **Where:** remote/offline/ui.js:151 (clock.onerror), ui.js:156-161 (later), ui.js:1795 (the visibility handler requires clock to be non-null).
- **Trigger:** The worker errors, or a posted wake-up is lost, while the page is hidden. Unlikely, since it is a one-line script.
- **Path:** later() has already posted to the worker and scheduled nothing else. onerror sets clock=null and schedules nothing. When the page becomes visible, ui.js:1795 skips because clock is null, and it also skips whenever parked is true. state.running stays true.
- **Symptom:** LIGHTS stop, MUSIC keeps playing, and the button says 'stop' with the numbers frozen. Stop then start recovers, because start calls tick. No reload needed.
- **Fix:** clock.onerror = () => { clock = null; if (state.running) later(50); }; and at ui.js:1795 use if (state.running) later(parked ? 50 : 0);

### Ruled out
- Line numbers are as of ui.js 12:56:56 and wire.js 13:00:46. Both changed during this review, because other work landed fixes for the worker clock, socket watchdog and reconnect wait while I was reading. The page on the helmet when he saw this had the older code. I did not check what is deployed now, since I was not allowed to contact the helmet.
- Music: nothing in tick, step, stop, watchLink or the Link class touches an.el. Every render-loop and link failure above stops the lights only. The only way this surface relates to the music stopping is the frozen-clock finding, where the lights follow audio that has already stopped.
- TICK_FAILS_MAX: not reachable from show content as built. I ran the real engine.js, guard.js, drive.js and show.js in Node for every show, under the analysed drive, a live-music stub and null music: the 6-show 12:24 build at 1/30 s and the 16-show build at 1/10 s. Zero throws, zero fallbacks from scenes to cues, 38 presets render with null and live music. All the DOM ids step() writes exist in player.html. 'Harder Better Faster Stronger' and 'Some Chords' had no scenes yet in that build, so re-run once the songs are final: node (scratch)/linkreview/sweep_fast.js (run it from that folder). If it ever trips, stop() leaves the music playing and stopNote unset, so a single song has no auto-restart; a playlist restarts at its next track.
- Silent fallback from scenes to a dark helmet: not possible. ShowPlayer.frame catches a scenes failure and uses the cue list, and _shows() in mau5offline.py skips any show without cues, so a cue list always exists.
- Dark in the middle of a song: none of 3 s or more in any of the 16 shows. Dark tails exist while the track runs out: Strobe 16.4 s, Strobe (Dimension) 13.8 s, Animal Rights 12.1 s, Raise Your Weapon 10.6 s. That is not 'halfway', but check by ear whether the music is still audible there.
- link.busy parking forever: no. step re-checks every 50 ms, owed is forgotten after the quiet period, and HTTP inflight is bounded by POST_TIMEOUT_MS through AbortController.
- Socket stuck in CONNECTING: no. The giveUp timer at wire.js:559 closes it and resolves false. The 'another is live' return at wire.js:565 would leave the promise unresolved, but it is unreachable because openSocket shares one connection attempt at a time.
- Reconnect back-off giving up: never. reopen retries every 3 s for as long as streaming is true. _opening cannot stick, because both promise outcomes clear it.
- _keepOn stuck on _arming: no. Every request goes through _req with a 5 s abort, and finally clears the flag. Another client posting on:false is revived within 5 s plus one request.
- Frames cannot throw: ws is only assigned once open, and send on a CLOSING or CLOSED socket drops silently. Exceptions from a pong are inside tick's try. No path through step leaves without calling later().
- start() stuck forever: the only unbounded await is held at ui.js:672, and stop's pause() rejects a pending video play. hello and begin are bounded by request limits, about 32 s worst case. No start that fails leaves starting set, so the button is not stuck, though it says 'stop' during that wait.
- Controller restart on the binary path: frames do not need the segment layout. setRealtimePixel writes the frame buffer and FX_fcn.cpp:1695 skips blending during realtime. realtimeLock lights a strip that booted off (udp.cpp:426-428). The page recovers on its own once a socket returns.
- Analysis fetch hanging: pickShow now races it against 1.5 s (ui.js:1017), so it cannot hold up a song. A fetch that truly hangs stays pending in the drives map, so that song runs on live analysis until reload. That is a quality issue, not a stop.
- Guard NaN and thermal: sane() and the finite checks hold, and the thermal limit dims but never goes dark. Nothing in the repo sends lor, which is the one state that would make WLED ignore frames while the page thinks it is running.
- Restart cause: today's two observed restarts (about 12:20:40 and 12:24:23) happened with ws=0 and live=False, so they were not caused by streaming. The official build does not report a reset reason: resetReason0 and resetReason1 in json.cpp:841-843 are inside WLED_DEBUG, so /json/info cannot say why. mau5offline.py's deploy_drives docstring records that uploads have rebooted the controller mid-upload, which is worth checking against what other sessions ran. I did not attribute these restarts.
