vortexcodes/deadmau5-helmet/tools/showkit/songs/veldt/about.txt

Bars of a measured grid, shows/scenes/deadmau5 - The Veldt.beats: bar b starts at 0.043 + 1.875 b seconds (128.007 BPM), 90 bars, flat to within 5 ms. The bar line is not where the estimator put it: the kick comes in on bar 8, drops out on 64, comes back on 72 and stops on 88, exactly 8-bar lines, and the clap is on 2 and 4 of that grid. The whole song is one 8-bar chord loop, and the ears play it: each new chord fires a tube, the low chords the low tube. The Nursery, from the Ray Bradbury story. A sun comes up through the jaw while birds cross the sky; at the kick it floods the shell, then the plain is lit, a disc of gold over grass in the jaw and the ear tubes, and the track's own high flurries are birds, each a spark across the top. An acacia stands against the sun, drawn as a true silhouette in front of it, then wavers and melts in the heat of the long note. Then something comes up out of the grass, a row every two bars, dark in front of the sun, while the grass goes still. It is a lion's head, and when it is all the way up its eyes ignite. In the big sections its mane is in the ears, and it roars once along the jaw. Noon is a small white sun with vultures wheeling in it. The sun sinks behind him into the breakdown, and a cold line cuts the day off, the first thing that is not savanna. Night is stars and two eyes low in the dark that come closer, vanish, and land on the forehead a beat before the kick returns. The second day is too bright. Lines of cyan cross it, the sun starts to skip, the lion tears; on 84 scanlines take the savanna and the program's name crosses the face in cold cyan, because it was never real. On 88 the picture closes to a line, then a dot, like an old set, and it is dark. Gold, rust and grass by day, indigo by night, and cyan only where the nursery is failing. Drops give their first beat to one thing on purpose: the shell floods on 8, 48 and 72 with the ears dark, and on 80 the ears blaze and the shell waits. Shell layers ask for less than the shell's 300 mA, so its colours stay colours, the verses are mostly dark with one lit shape, and nothing on it pulses faster than an 8th.
