vortexcodes/deadmau5-helmet/tools/showkit/notes/animal.md

# What the animal builder ran and saw

Commands and their text output, in order, with long output cut. Images are left out; rerun the tools to see them. Cut off partway: the generator and treatment in the repo are the latest state.

I'll start by reading the brief.

```
$ date; ls -la "tools/showkit/"; ls -la "tools/showkit/songs/" 2>/dev/null
Sat Oct 31 12:39:05 PDT 2026
total 168
drwxr-xr-x@  11 jones  wheel    352 Oct 31 12:38 .
drwx------@ 281 jones  wheel   8992 Oct 31 12:37 ..
-rw-r--r--@   1 jones  wheel   9702 Oct 31 12:38 BRIEF.md
-rw-r--r--@   1 jones  wheel    933 Oct 31 12:37 fmt.py
-rw-r--r--@   1 jones  wheel  10884 Oct 31 12:38 grid.py
-rw-r--r--@   1 jones  wheel  38416 Oct 31 12:37 mau5song_new.py
-rw-r--r--@   1 jones  wheel   1925 Oct 31 12:38 sheet.py
-rw-r--r--@   1 jones  wheel   1652 Oct 31 12:37 songmap.py
-rw-r--r--@   1 jones  wheel   2438 Oct 31 12:37 spectro.py
-rw-r--r--@   1 jones  wheel   1173 Oct 31 12:37 spritetry.py
drwxr-xr-x@   3 jones  wheel     96 Oct 31 12:37 work
total 1616
drwxr-xr-x@  3 jones  wheel      96 Oct 31 12:37 .
drwxr-xr-x@ 11 jones  wheel     352 Oct 31 12:38 ..
-rw-r--r--@  1 jones  wheel  823816 Oct 31 12:37 deadmau5_The_Veldt_mp3.env.npz
```

```
$ date; ls -la "tools/showkit/"; ls -la "tools/showkit/songs/" 2>/dev/null
Sat Oct 31 12:39:05 PDT 2026
total 168
drwxr-xr-x@  11 jones  wheel    352 Oct 31 12:38 .
drwx------@ 281 jones  wheel   8992 Oct 31 12:37 ..
-rw-r--r--@   1 jones  wheel   9702 Oct 31 12:38 BRIEF.md
-rw-r--r--@   1 jones  wheel    933 Oct 31 12:37 fmt.py
-rw-r--r--@   1 jones  wheel  10884 Oct 31 12:38 grid.py
-rw-r--r--@   1 jones  wheel  38416 Oct 31 12:37 mau5song_new.py
-rw-r--r--@   1 jones  wheel   1925 Oct 31 12:38 sheet.py
-rw-r--r--@   1 jones  wheel   1652 Oct 31 12:37 songmap.py
-rw-r--r--@   1 jones  wheel   2438 Oct 31 12:37 spectro.py
-rw-r--r--@   1 jones  wheel   1173 Oct 31 12:37 spritetry.py
drwxr-xr-x@   3 jones  wheel     96 Oct 31 12:37 work
total 1616
drwxr-xr-x@  3 jones  wheel      96 Oct 31 12:37 .
drwxr-xr-x@ 11 jones  wheel     352 Oct 31 12:38 ..
-rw-r--r--@  1 jones  wheel  823816 Oct 31 12:37 deadmau5_The_Veldt_mp3.env.npz
```

```
$ cd "~/deadmau5 app"; KIT=tools/showkit; mkdir -p "$KIT/work/animal"; cat "$KIT/grid.py"; echo ------; cat "$KIT/fmt.py"; echo ------; cat "$KIT/sheet.py"; echo -----; cat "$KIT/songmap.py"; echo ----; cat "$KIT/spectro.py"; echo -----; cat "$KIT/spritetry.py"
#!/usr/bin/env python3
"""grid.py -- measure a song's real beat grid against its audio. Run from the repo root.

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

def env_of(mp3):
    os.makedirs(WORK, exist_ok=True)
    p = os.path.join(WORK, re.sub(r"\W+", "_", os.path.basename(mp3)) + ".env.npz")
    if os.path.exists(p) and os.path.getmtime(p) >= os.path.getmtime(mp3):
        z = np.load(p)
        return {k: z[k] for k in z.files}
    raw = 
... [cut] ...
t, default=166.0)
ap.add_argument("--x_half", type=float, default=171.0)
a = ap.parse_args()
h = E.Helmet(); sc = PV.Scene(h)
ims = []
for nm in a.names:
    f = np.asarray(E.make("sprite", sprite=nm, color=(255, 170, 40), y_lo=a.y_lo, y_hi=a.y_hi, x_half=a.x_half).render(h, 0.0, None), float)
    im = sc.frame(f).crop((130, 150, 630, 620)).resize((360, 338))
    ImageDraw.Draw(im).text((6, 4), nm, fill=(255, 255, 255))
    ims.append(im)
o = Image.new("RGB", (sum(i.width for i in ims), ims[0].height))
x = 0
for i in ims:
    o.paste(i, (x, 0)); x += i.width
o.save(a.out); print(a.out, o.size)
```

```
$ cd "~/deadmau5 app"; cat "(scratch)/tiki/write_treatment.py"; ls -la shows/ | head -60; ls -la shows/scenes/ | head -60
import json
KICK="x.......x......."
idolp={"sprite":"tiki","y_lo":-108,"y_hi":166,"x_half":171}
tr={"v":1,"show":"TIKI TIKI - Slowed",
"about":"Bars of a measured grid, shows/scenes/TIKI TIKI - Slowed.beats: bar b starts at 1.796 + 1.739 b seconds (137.98 BPM), 183 bars, and at bar 119.5 the track is spliced, so the music comes back 197 ms late and the grid holds still for it. Everything from there is the song's opening again, bar for bar. The bar line is where the phrases turn, with the kick on 1 and 3 and the clap on 2 and 4 with a flick on the and of 2. A night on the island. Torches get lit one tube at a time; the hooks are fire climbing the shell with the ears burning as torches, the kick on the rims and the clap up the tubes. Every breakdown goes out to the lagoon, cold water and moon glints, with one stopped bar of almost nothing, and the title crosses the face once, in the first. The verses are bamboo: upright stalks swaying on the face, the two sides stomping in turn. The big sections wake the idol, a carved mask drawn to fit the LEDs that exist: brow and eyes on the dome, teeth along the jaw, since the middle of the face has no LEDs. It burns in torch colours the first time, at sunset the second, and half fire, half water the third, swapping sides. The song then starts over, so the show does too, and the last big section has everything, with white once. At the end the torches go out one tube at a time and the idol is last to go. Shell layers are kept near the shell's 300 mA and nothing on it pulses faster than a beat.",
"lead":0,
"marks":{"hush":2,"light":3,"hook":5,"hookb":9,"dip":13,"climb":14,"hook2":15,"burn":21,
 "water":25,"stop":26,"still":27,"swell":30,"verse":31,"vlow":37,"vrise":38,"big":39,"bigb":47,"burn2":57,
 "water2":61,"stop2":62,"still2":63,"s
... [cut] ...
ne.json
-rw-r--r--@  1 jones  staff   6076 Oct 31 12:23 beneath (with raxaj).beats
-rw-r--r--@  1 jones  staff  13145 Oct 31 12:23 beneath (with raxaj).scene.json
-rw-r--r--@  1 jones  staff  10412 Oct 31 12:18 deadmau5 - Ghosts n Stuff (Nero Remix).beats
-rw-r--r--@  1 jones  staff   9383 Oct 31 12:18 deadmau5 - Ghosts n Stuff (Nero Remix).scene.json
-rw-r--r--@  1 jones  staff  14383 Oct 30 05:30 deadmau5 - Strobe (Dimension Remix).scene.json
-rw-r--r--@  1 jones  staff   8945 Oct 30 05:03 deadmau5 - Strobe.scene.json
-rw-r--r--@  1 jones  staff   3748 Oct 31 12:37 deadmau5 - The Veldt.beats
```

```
$ cd "~/deadmau5 app"; KIT=tools/showkit; mkdir -p "$KIT/work/animal"; cat "$KIT/grid.py"; echo ------; cat "$KIT/fmt.py"; echo ------; cat "$KIT/sheet.py"; echo -----; cat "$KIT/songmap.py"; echo ----; cat "$KIT/spectro.py"; echo -----; cat "$KIT/spritetry.py"
#!/usr/bin/env python3
"""grid.py -- measure a song's real beat grid against its audio. Run from the repo root.

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

def env_of(mp3):
    os.makedirs(WORK, exist_ok=True)
    p = os.path.join(WORK, re.sub(r"\W+", "_", os.path.basename(mp3)) + ".env.npz")
    if os.path.exists(p) and os.path.getmtime(p) >= os.path.getmtime(mp3):
        z = np.load(p)
        return {k: z[k] for k in z.files}
    raw = 
... [cut] ...
t, default=166.0)
ap.add_argument("--x_half", type=float, default=171.0)
a = ap.parse_args()
h = E.Helmet(); sc = PV.Scene(h)
ims = []
for nm in a.names:
    f = np.asarray(E.make("sprite", sprite=nm, color=(255, 170, 40), y_lo=a.y_lo, y_hi=a.y_hi, x_half=a.x_half).render(h, 0.0, None), float)
    im = sc.frame(f).crop((130, 150, 630, 620)).resize((360, 338))
    ImageDraw.Draw(im).text((6, 4), nm, fill=(255, 255, 255))
    ims.append(im)
o = Image.new("RGB", (sum(i.width for i in ims), ims[0].height))
x = 0
for i in ims:
    o.paste(i, (x, 0)); x += i.width
o.save(a.out); print(a.out, o.size)
```

```
$ cd "~/deadmau5 app"; cat "(scratch)/tiki/write_treatment.py"; ls -la shows/ | head -60; ls -la shows/scenes/ | head -60
import json
KICK="x.......x......."
idolp={"sprite":"tiki","y_lo":-108,"y_hi":166,"x_half":171}
tr={"v":1,"show":"TIKI TIKI - Slowed",
"about":"Bars of a measured grid, shows/scenes/TIKI TIKI - Slowed.beats: bar b starts at 1.796 + 1.739 b seconds (137.98 BPM), 183 bars, and at bar 119.5 the track is spliced, so the music comes back 197 ms late and the grid holds still for it. Everything from there is the song's opening again, bar for bar. The bar line is where the phrases turn, with the kick on 1 and 3 and the clap on 2 and 4 with a flick on the and of 2. A night on the island. Torches get lit one tube at a time; the hooks are fire climbing the shell with the ears burning as torches, the kick on the rims and the clap up the tubes. Every breakdown goes out to the lagoon, cold water and moon glints, with one stopped bar of almost nothing, and the title crosses the face once, in the first. The verses are bamboo: upright stalks swaying on the face, the two sides stomping in turn. The big sections wake the idol, a carved mask drawn to fit the LEDs that exist: brow and eyes on the dome, teeth along the jaw, since the middle of the face has no LEDs. It burns in torch colours the first time, at sunset the second, and half fire, half water the third, swapping sides. The song then starts over, so the show does too, and the last big section has everything, with white once. At the end the torches go out one tube at a time and the idol is last to go. Shell layers are kept near the shell's 300 mA and nothing on it pulses faster than a beat.",
"lead":0,
"marks":{"hush":2,"light":3,"hook":5,"hookb":9,"dip":13,"climb":14,"hook2":15,"burn":21,
 "water":25,"stop":26,"still":27,"swell":30,"verse":31,"vlow":37,"vrise":38,"big":39,"bigb":47,"burn2":57,
 "water2":61,"stop2":62,"still2":63,"s
... [cut] ...
ne.json
-rw-r--r--@  1 jones  staff   6076 Oct 31 12:23 beneath (with raxaj).beats
-rw-r--r--@  1 jones  staff  13145 Oct 31 12:23 beneath (with raxaj).scene.json
-rw-r--r--@  1 jones  staff  10412 Oct 31 12:18 deadmau5 - Ghosts n Stuff (Nero Remix).beats
-rw-r--r--@  1 jones  staff   9383 Oct 31 12:18 deadmau5 - Ghosts n Stuff (Nero Remix).scene.json
-rw-r--r--@  1 jones  staff  14383 Oct 30 05:30 deadmau5 - Strobe (Dimension Remix).scene.json
-rw-r--r--@  1 jones  staff   8945 Oct 30 05:03 deadmau5 - Strobe.scene.json
-rw-r--r--@  1 jones  staff   3748 Oct 31 12:37 deadmau5 - The Veldt.beats
```

```
$ cd "~/deadmau5 app"; KIT=tools/showkit; time python3 "$KIT/grid.py" scan "shows/deadmau5 & Wolfgang Gartner - Animal Rights.mp3" 2>&1 | tail -30
estimator: 128.000 BPM, first bar 1.874 s, tempo lock 0.821, bar lock 0.5370749281464556; song 375.0 s
refined over the whole song: spb 0.468751 = 128.000 BPM
first half 128.000 BPM, second half 128.012 BPM (these should agree within 0.05)
phase of the music against that grid per 8 bars, ms (flat = right; one 16th = 117 ms; contrast under 1.15 means sparse, ignore it):
  0:-7(6.58)  8:-5(6.25)  16:-5(5.52)  24:-5(5.19)  32:+5(7.12)  40:+5(5.82)  48:-1(4.06)  56:-1(3.82)  64:-1(3.79)  72:+1(3.79)  80:-5(4.05)  88:+1(4.23)  96:+3(7.50)  104:+1(8.33)  112:+1(4.15)  120:+1(3.86)  128:+1(4.25)  136:+1(4.09)  144:+1(3.51)  152:-3(3.82)  160:-7(5.09)  168:-7(4.98)  176:-7(5.68)  184:-7(5.34)  192:+7(3.87)
change per beat position, estimator's bar 1 at 1.874 s: 0:1.13 1:0.87 2:1.02 3:0.91  (the highest is where bars really start, 0 = estimator is right)
strongest phrase positions, in beats mod 32 from that bar 1: 28(1.61), 12(1.37), 22(1.31), 10(1.30), 4(1.27), 29(1.20)
biggest single changes (time, beat from bar 1, beat mod 4): 31.9s b64 m0; 46.9s b96 m0; 60.0s b124 m0; 89.5s b187 m3; 90.0s b188 m0; 90.5s b189 m1; 156.6s b330 m2; 157.5s b332 m0; 164.1s b346 m2; 171.6s b362 m2; 172.5s b364 m0; 180.0s b380 m0; 180.5s b381 m1; 186.6s b394 m2; 270.0s b572 m0; 273.7s b580 m0; 288.7s b612 m0; 292.5s b620 m0; 295.3s b626 m2; 299.5s b635 m3; 300.0s b636 m0; 316.9s b672 m0; 360.0s b764 m0; 360.5s b765 m1
suggested next: grid.py fold with --spb 0.468751 --anchor 1.874, decide the bar line, then grid.py write
python3 "$KIT/grid.py" scan  2>&1  2.28s user 0.80s system 111% cpu 2.758 total
tail -30  0.00s user 0.00s system 0% cpu 2.757 total
```

```
$ cd "~/deadmau5 app"; KIT=tools/showkit; python3 "$KIT/grid.py" fold "shows/deadmau5 & Wolfgang Gartner - Animal Rights.mp3" --spb 0.46875 --anchor 0.0 2>&1 | head -120; ls -la "shows/" | grep -i animal; ls -la shows/scenes | grep -i animal; ls shows/.mau5cache | head
bar 0 at 0.000 s, 128.000 BPM, 200 bars
bars 0-16   (16 steps, | every beat; one row per band)
   sub     @.  |%:  |@.  |%:     peak 0.75
   bass    @.  |@   |@.. |@      peak 1.30
   lowmid  @   |#   |@ . |#      peak 1.05
   mid     % : |@ : |@ - |* .    peak 1.67
   pres    % = |% - |@ = |= :    peak 1.89
   air     @ * |# * |@ * |- *    peak 1.96
bars 16-32   (16 steps, | every beat; one row per band)
   sub     @.  |%:  |@. .|%:     peak 0.75
   bass    @   |@   |@.-.|@      peak 1.29
   lowmid  @   |#   |@ + |%      peak 1.03
   mid     @ : |@ : |@ = |* :    peak 1.42
   pres    % = |% - |@ + |+ +    peak 1.66
   air     @ *.|# *.|@ #.|- +.   peak 1.84
bars 32-48   (16 steps, | every beat; one row per band)
   sub     %=-:|%=#:|*--@|#=::   peak 0.17
   bass    @.: |@.::|%:.=|@ :    peak 0.46
   lowmid  +.% |@ #-| # @|.-+    peak 0.95
   mid     * = |@ +-|-* %|=:+    peak 1.34
   pres    * = |@ =-|+-.=|#.=    peak 1.31
   air       % |%=@+|.#.@|#.@#   peak 0.88
bars 48-64   (16 steps, | every beat; one row per band)
   sub     @:=.|@-%.|=::@|:---   peak 0.52
   bass    %:: |@.=.|*-:=|#.-    peak 1.18
   lowmid  #:+ |@.#:|.#-@|--#.   peak 0.85
   mid     #.= |@ #:|-#-*|-:+    peak 1.27
   pres    @.- |@ +.|*+-=|+.*    peak 1.24
   air     @ * |% #.|*.+-|- *    peak 1.37
bars 64-80   (16 steps, | every beat; one row per band)
   sub     @:=.|@-*.|=:.%|--:-   peak 0.53
   bass    @.: |@.=.|*-:=|#:-.   peak 1.13
   lowmid  #.* |% #.|.%-@|=:*.   peak 0.84
   mid     #.- |@.#-|-#=+|=:+.   peak 1.00
   pres    @.- |@ *:|++-=|=.+    peak 1.16
   air     @ + |% #.|*.*-|= *.   peak 1.35
bars 80-96   (16 steps, | every beat; one row per band)
   sub     #.: |%:-.|@.:-|#::-   peak 0.72
   bass    %.. |@ * |@::.|@ -    peak 1.27
   lowmid  @:- |@.+ |@:: |@.%    peak 0.77
   mid
... [cut] ...
mid     @--:|::.-|:-:.|-:.:   peak 0.11
   pres    @.::|=:::|*..:|*.:.   peak 0.07
   air     @ . |#   |#   |*      peak 0.14
-rw-r--r--@  1 jones  staff  15003733 Oct 31 12:37 deadmau5 & Wolfgang Gartner - Animal Rights.mp3
Kaskade feat. deadmau5 - I Remember.wav
Kaskade feat. deadmau5 - I Remember.wav.src
TIKI TIKI - Slowed.wav
TIKI TIKI - Slowed.wav.src
deadmau5 & Wolfgang Gartner - Animal Rights.wav
deadmau5 & Wolfgang Gartner - Animal Rights.wav.src
deadmau5 - FN Pig.wav
deadmau5 - FN Pig.wav.src
deadmau5 - Harder Better Faster Stronger.wav
deadmau5 - Harder Better Faster Stronger.wav.src
```

```
$ cd "~/deadmau5 app"; KIT=tools/showkit; B="deadmau5 & Wolfgang Gartner - Animal Rights"; time python3 "$KIT/grid.py" write "$B" --spb 0.46875 --anchor 0.0 2>&1 | tail -8; python3 "$KIT/grid.py" check "$B"; python3 "$KIT/songmap.py" "$B"; python3 "$KIT/spectro.py" "$B" "$KIT/work/animal/full.png"
    4:30.00-4:45.00  lvl1  matrix     {}
    4:45.00-5:00.00  lvl1  earspin    {'period': 2.4}
    5:00.00-5:15.00  lvl1  chase      {'period': 2.2}
    5:15.00-5:30.00  lvl1  scanner    {'period': 3.75}
    5:30.00-5:45.00  lvl1  sparkle    {}
    5:45.00-6:00.00  lvl1  spiral     {'period': 6.0}
    6:00.00-6:15.00  lvl0  wave       {'period': 5.0, 'length': 0.8}
wrote shows/scenes/deadmau5 & Wolfgang Gartner - Animal Rights.beats: 801 beats, 200 bars, bar 0 at 0.000 s, 128.000 BPM
python3 "$KIT/grid.py" write "$B" --spb 0.46875 --anchor 0.0 2>&1  0.90s user 0.21s system 94% cpu 1.179 total
tail -8  0.00s user 0.00s system 0% cpu 1.179 total
deadmau5 & Wolfgang Gartner - Animal Rights: 128.000 BPM, 201 bars, bar 0 at 0.000 s, holds []
music against the grid per 8 bars, ms (contrast): 0:-5(6.11)  8:-5(6.19)  16:-5(4.91)  24:-5(4.75)  32:+1(8.07)  40:+5(6.37)  48:-1(4.06)  56:-1(4.11)  64:-1(3.80)  72:-1(3.87)  80:-5(4.29)  88:-5(4.67)  96:+5(6.22)  104:+1(9.02)  112:-1(3.97)  120:-1(3.88)  128:+1(4.15)  136:+1(4.10)  144:+1(3.51)  152:-1(3.65)  160:-7(5.12)  168:-7(4.93)  176:-7(5.71)  184:-7(5.46)  192:+7(3.30)
worst 7 ms where the music is clear enough to say, mean -1.3 ms
deadmau5 & Wolfgang Gartner - Animal Rights: 201 bars, 1.88 s a bar, 375.0 s
 bar     t   E  B  M  H  notes       change
   0    0.0   6  5  2  3  C F A       
   1    1.9   6  6  3  5  C F A       
   2    3.8   6  6  2  4  C F A       
   3    5.6   6  6  3  5  C F A       
   4    7.5   6  6  2  4  C F A       
   5    9.4   6  6  3  5  C F A       
   6   11.2   6  6  2  4  C F A       
   7   13.1   6  6  3  5  C F A       
   8   15.0   6  6  2  4  C F A       
   9   16.9   6  6  3  5  C F A       
  10   18.8   6  6  2  4  C F A       
  11   20.6   6  6  3  5  C F A       
  12   22.5   6 
... [cut] ...
 
 189  354.4   6  6  3  5  C F A       
 190  356.2   6  6  3  4  C F A       
 191  358.1   7  6  4  6  C F A       >>
 192  360.0   4  0  5  4  A D B       >>
 193  361.9   2  0  4  1  A D B       >>
 194  363.8   0  0  1  0  A D B       >>
 195  365.6   0  0  0  0  D A B       
 196  367.5   0  0  0  0  D A B       
 197  369.4   0  0  0  0  D A B       
 198  371.2   0  0  0  0  D A B       
 199  373.1   0  0  0  0  A D A#      
 200  375.0   0  0  0  0  C C# D      
tools/showkit/songs/animal/full.png
```

```
$ cd "~/deadmau5 app"; KIT=tools/showkit; B="deadmau5 & Wolfgang Gartner - Animal Rights"; W="$KIT/work/animal"; python3 "$KIT/spectro.py" "$B" "$W/z0.png" 12 36; python3 "$KIT/spectro.py" "$B" "$W/z1.png" 30 52; python3 "$KIT/spectro.py" "$B" "$W/z2.png" 48 68; python3 "$KIT/spectro.py" "$B" "$W/z3.png" 92 116; python3 "$KIT/spectro.py" "$B" "$W/z4.png" 126 164;
tools/showkit/songs/animal/z0.png
tools/showkit/songs/animal/z1.png
tools/showkit/songs/animal/z2.png
tools/showkit/songs/animal/z3.png
tools/showkit/songs/animal/z4.png
```

```
$ mkdir -p tools/showkit/songs/animal; cat > tools/showkit/songs/animal/rhythm.py <<'EOF'
#!/usr/bin/env python3
# rhythm.py lo hi [band ...] : per bar, 16 steps, onset or level per band, so stabs can be read off.
import sys, numpy as np, os, re
KIT = "tools/showkit"
WORK = KIT + "/work"
p = WORK + "/" + re.sub(r"\W+", "_", "deadmau5 & Wolfgang Gartner - Animal Rights.mp3") + ".env.npz"
z = np.load(p)
tt = z["tt"]
spb = 0.46875
lo, hi = ... [cut]
  28 @   |@   |@.=.|@      @   |*   |@ = |*      % - |- : |@ + |. -    @ + |= - |@ + |- @ 
  29 @.  |@   |@...|%.     %   |%   |% - |%      @ : |* - |@ +.|: .    @ + |* = |@ #.|- : 
  30 %   |@   |@ =.|@      @   |*   |@ = |#      % - |- : |@ = |. -    @ + |= - |@ * |- @ 
  31 @.  |@   |@...|%.     %   |%   |# - |#      @ : |* . |% - |: .    @ + |* - |% - |- : 
  32 -   |=   |-  .|- .    @ # |# #=| @ *|..@    @ . |= :.|=: *|- *    @   |+ ..|=: -|+ - 
  33 - . |=  .|=  .|-      % @ |%.@=| @ *|.@.    # * |@ #=|=* @|-*     + = |@ =+|+= *|*::.
  34 -   |= ..|-  .|- .      * |@ %=| @ @|  @    - - |@ #:|-* @|= @    * = |@ =-|+= *|* % 
  35 -   |:  .|-  .|-      # @ |% *=| + @| #     @ % |@ %=|-@ @|-+     * * |@ ++|+= +|#.:.
  36 -   |= . |-   |- .    : =.|@ #+| # @|  @    = = |@.%-|-* @|=.@    * + |@.+-|+=:*|*.% 
  37 - . |- . |-  .|=      % % |% #-|:+ @| %     @ % |@ %=|:@.@|=*     * * |@ ++|*=.+|%:- 
  38 =   |- . |-  .|-..    -.# |% @.|.# @|  @    : - |@.#=|:* %|= @    * * |@.+-|+-:*|#.% 
  39 - . |:  .|-   |-      #.@ |@ @-|.% @| +     @ # |@ ++|:% @|==     * * |@.+=|=-.-|#:: 
  40 =   |=  .|-: :|- .    :.* |+ *-|.@ @|  #    : : |% +-|:* #|=.@    + : |# ::|+-.=|* * 
  41 - ..|- . |:: -|= .    %.@ |@ =:| % %| * .   @ + |@ #=|-+ #|-=     + + |@ +:|++.=|+-: 
  42 =   |- . |-  .|= :     .# |* *:| @ @|  +    -.: |@ -=|-= #|= @    + + |@ =:|+= -|* = 
  43 - : |:  .|:. .|-.     # @ |@ *=| +.#|...    #.+ |#.+-|:= #|-=     = + |% -.|=: -|=:..
  44 =   |-   |-. -|- .    . = |+.+=| * #|-.*    -.: |%.:.|=: *|= =    + : |% : |=: .|= . 
  45 : . |- . |-. :|=      *.=.|@.*=| = +|..@    = - |*.- |:- -|- =.   - : |=  .|:  .|- . 
  46     | .  |    |       .-  |-. :|  : | ..     .  |:  .|. . | .         |    |    |    
  47     |    |    |.      .  .|    |    |. .    .. .|. ..|.:. |#      
... [cut] ...
 +    :.= |% %-|.#:@|  @    :.+ |- @:|:%:#| .%    #.+ |= +:|+=:+|- @ 
  61 %.: |@ +:|-= +|#:..   #:= |*.%.|:+ @| #:.   @:= |* #-| @.+|.=:.   @.- |* +:|-+:.|-:: 
  62 = . |+.  |+.. |@.:    .. .|:.  | . -|@. :   ....|... |. + |       +.. |= . |= =.|: = 
  63 %:  |%:  |=.*.|*...   -:  |*.  | :%.| ...   -.  |-.. |: % |..     +.. |- : |=.# |:   
  64 @.. |@ *:|+-.:|= =    @:# |* +.|.@.@|..*    *.. |:.:.|.=:=|  %    @   |- : |-=.=|- # 
  65 @.: |% -.|==.+|+..:   % % |# * | @ @|.+.    + - |+ *:|.+.-|:=     %.= |* *:|=+:.|:=. 
     bass                  lowmid                mid                   pres
```

```
$ cd "~/deadmau5 app"; wc -l mau5scene.py mau5fx.py mau5engine.py mau5show.py mau5preview.py; sed -n 1,200p mau5scene.py
    1344 mau5scene.py
     992 mau5fx.py
    1388 mau5engine.py
    1000 mau5show.py
     214 mau5preview.py
    4938 total
#!/usr/bin/env python3
"""mau5scene -- shows choreographed per song, instead of a playlist of effects.

A cue-list show (mau5show.build) picks a stock preset for each phrase
from a pool and holds it.  It follows the music's level and lands on its
beats, and it still reads as a playlist: the same eight effects in a
different order for every song, none of them about the song.  What the
owner asked for is what deadmau5's own shows do -- each track gets its
own visual language: its own colours, its own motifs that come back
when the music does, builds that visibly grow, drops that land on the
bar the bass lands on, a breakdown stripped back to almost nothing, a
title that crosses the face once, and the ears played as an instrument
of their own rather than as more screen.

So a song owns a treatment, shows/scenes/<base>.scene.json, written by
hand in bars against that song's own bar map, and this module compiles
it into the show it belongs to as `show["scenes"]`.  The cue list stays
where it is, untouched, and is what plays if the scenes are absent,
switched off (`mode: "cues"`, MAU5_CUES=1, `?cues` on the phone) or
throw.

Every frame is a pure function of the time, plus optionally the band
curves, on the analysis' beat grid -- which is exactly linear for every
shipped song (the spread of beat intervals is about 2e-14 s), apart from
any seam where the track was edited and the music comes back late, which
the grid holds still for (grid_of).  That one decision buys three things.  The phone and the laptop can agree to the
last bit, because there is no state for them to disagree about.  Seeking
and pausing cost nothing.  And the show stays in sync from the
... [cut] ...
 %.1f ms from linear; scenes need "
                             "a steady grid" % (worst * 1000))
    grid = {"t0": t0, "spb": spb}
    seams = np.flatnonzero(late)
    if len(seams):
        grid["holds"] = [[float(k + 1 - first), float(late[k] / spb)] for k in seams]
    return grid, int(len(bars))

def src_of(base):
    """The analysis' own stamp of its audio, or '' for an older cache."""
    p = os.path.join(SHOWS, base + ".analysis.npz")
    try:
        z = np.load(p)
        return str(z["src"]) if "src" in z else ""
    except (OSError, ValueError):
        return ""

_HELMET = None
```

```
$ cd "~/deadmau5 app"; sed -n 200,760p mau5scene.py
_HELMET = None

def _helmet():
    global _HELMET
    if _HELMET is None:
        _HELMET = E.Helmet()
    return _HELMET

def _edge_mm(h):
    """Where a word must start to be wholly off the shell: one cell past it."""
    return float(np.abs(h.px[h.shell]).max()) + CELL

class _Compiler:
    """Turns an authored treatment into the canonical, defaults-filled form."""

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

    # -- bars and values -------------------------------------------------
    def bar(self, v, what="bar"):
        """A bar: a number, a mark, or 'mark+N' / 'mark-N'."""
        if is
... [cut] ...
mp"]["pat"], s["pump"]["step"])
            if gap < 0.5 - 1e-9 and span > 4.0:
                errs.append("%s: the pump beats every %.3g beats, faster than "
                            "8th notes" % (what, gap))
        for j, L in enumerate(s["layers"]):
            layer_checks(L, "%s layer %d" % (what, j), span)
        if texts(s["layers"]) > 1:
            errs.append("%s: two text layers at once" % what)

    for x in hits:
        what = "hit %s" % x["name"]
        if len(x["layers"]) > MAX_HIT_LAYERS:
            errs.append("%s has %d layers, %d at most" % (what, len(x["layers"]),
```

```
$ cd "~/deadmau5 app"; sed -n 760,1344p mau5scene.py
            errs.append("%s has %d layers, %d at most" % (what, len(x["layers"]),
                                                          MAX_HIT_LAYERS))
        if not 0 <= x["at"] <= nb:
            errs.append("%s at bar %g is outside the song" % (what, x["at"]))
        if x["beats"] <= 0:
            errs.append("%s lasts no time" % what)
        for j, L in enumerate(x["layers"]):
            layer_checks(L, "%s layer %d" % (what, j), x["beats"])
        # what overlaps it
        a0, a1 = 4.0 * x["at"], 4.0 * x["at"] + x["beats"]
        over = [y for y in hits if 4.0 * y["at"] < a1 and a0 < 4.0 * y["at"] + y["beats"]]
        # the most that are active at once: test at each start inside
        most = max(sum(1 for y in over if 4.0 * y["at"] <= q < 4.0 * y["at"] + y["beats"])
                   for q in [a0] + [4.0 * y["at"] for y in over if a0 <= 4.0 * y["at"] < a1])
        if most > MAX_HITS_AT_ONCE:
            errs.append("%s overlaps %d other hits" % (what, most - 1))
        t = texts(x["layers"])
        if t:
            others = sum(texts(y["layers"]) for y in over if y is not x)
            under = [s for s in scenes if 4.0 * s["from"] < a1 and a0 < 4.0 * s["to"]]
            others += max([texts(s["layers"]) for s in under] or [0])
            if t + others > 1:
                errs.append("%s: its text overlaps another text" % what)
    return errs, warns

# ----------------------------------------------------------------------
# the renderer
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
