vortexcodes/deadmau5-helmet/tools/showkit/notes/chords.md

# What the chords builder ran and saw

Commands and their text output, in order, with long output cut. Images are left out; rerun the tools to see them. Cut off partway: the generator and treatment in the repo are the latest state.

I'll start by reading the brief.

```
$ date; cat "tools/showkit/BRIEF.md"; ls -la "tools/showkit/"
Sat Oct 31 12:39:04 PDT 2026
# Making one song's show for the deadmau5 helmet

You are choreographing one song for a real wearable LED helmet (deadmau5-style mau5head), for tonight's Halloween party. The owner's words: "Create these really good animations ... especially ones like the Tiki Tiki one, which was really good because it was unique. Keep doing these cool, unique ones for each song." Read `shows/scenes/TIKI TIKI - Slowed.scene.json` and its generator `(scratch)/tiki/write_treatment.py` first: that is the bar. A show is a story with its own world, palette and characters; motifs come back when the music does; builds visibly grow; drops land exactly on the bass; breakdowns strip back to almost nothing; the ears play as an instrument of their own. It must not look like a sequence of effects, and it must not look like any other show.

Working directory: `~/deadmau5 app` (main checkout, run everything from there). `KIT=tools/showkit`. Your scratch files go in `$KIT/work/<short song name>/`.
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
