vortexcodes/deadmau5-helmet/tools/showkit/notes/fnpig.md

# What the fnpig builder ran and saw

Commands and their text output, in order, with long output cut. Images are left out; rerun the tools to see them. Cut off partway: the generator and treatment in the repo are the latest state.

I'll read the brief first.

```
$ date; cat "tools/showkit/BRIEF.md"; ls -la "tools/showkit/"
Sat Oct 31 12:39:04 PDT 2026
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
