vortexcodes/deadmau5-helmet/data/cal/bars_compare.jpg

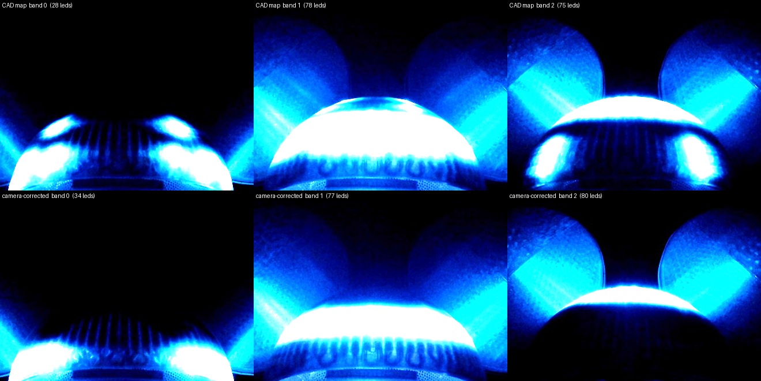
data/cal/bars_compare.jpg
