vortexcodes/deadmau5-helmet/data/cal/digits_new.jpg

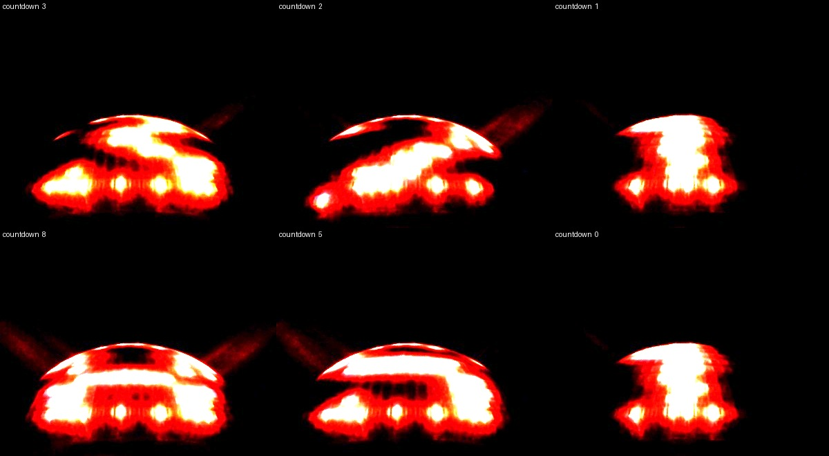
data/cal/digits_new.jpg
