vortexcodes/deadmau5-helmet/data/cal/presets.jpg

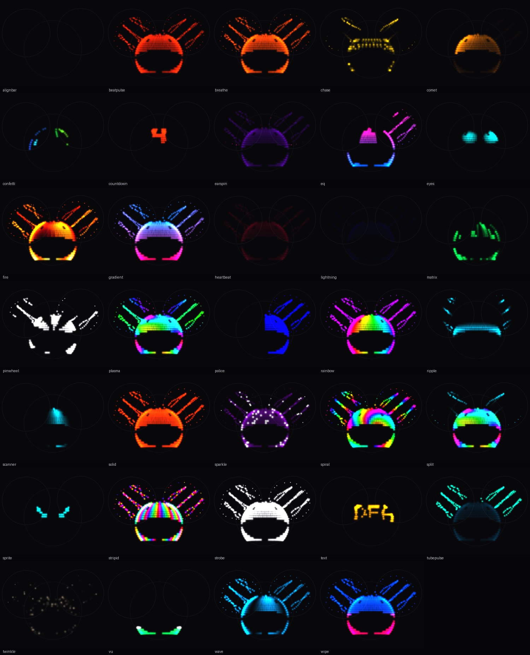
data/cal/presets.jpg
