vortexcodes/deadmau5-helmet/data/cal/presets_new.jpg

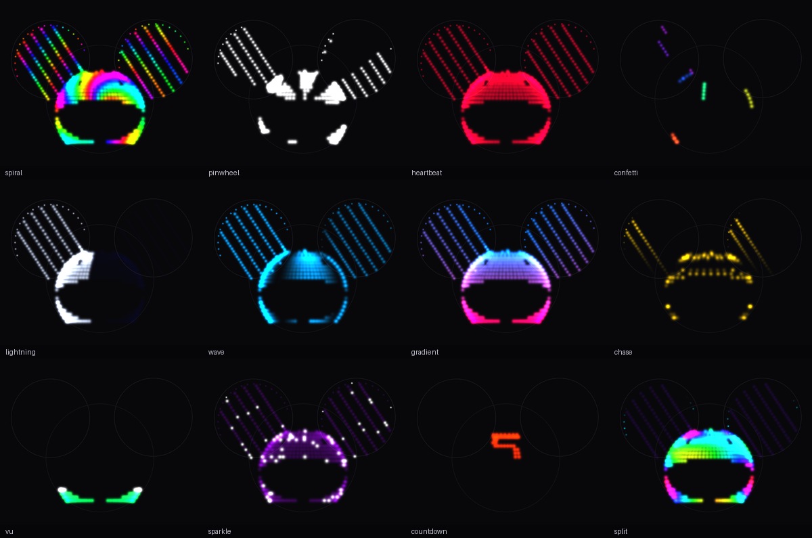
data/cal/presets_new.jpg
