vortexcodes/deadmau5-helmet/data/cal/psu/dark.jpg

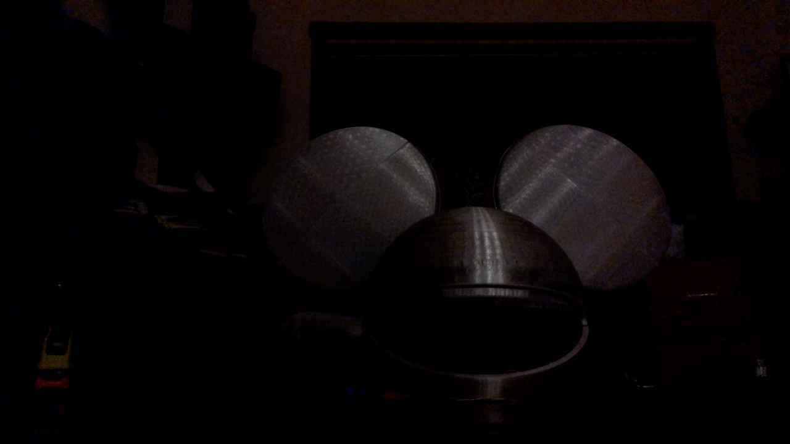
data/cal/psu/dark.jpg
