vortexcodes/deadmau5-helmet/data/cal/psu/s0100.jpg

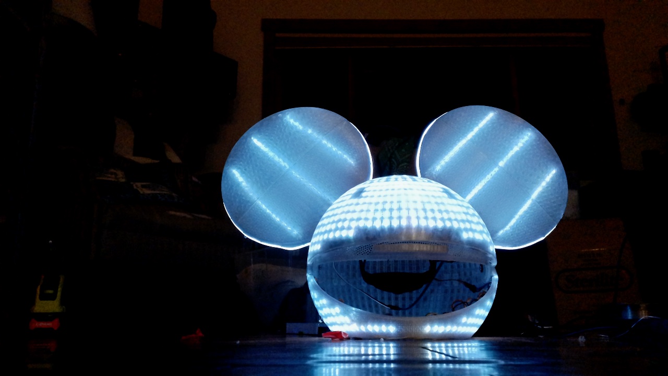
data/cal/psu/s0100.jpg
