vortexcodes/deadmau5-helmet/data/cal/psu/s0300.jpg

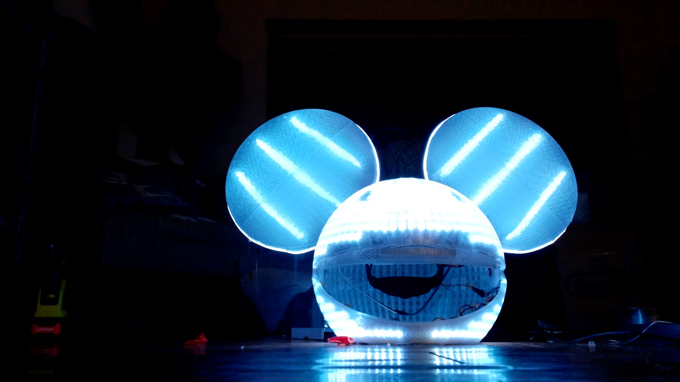
data/cal/psu/s0300.jpg
