vortexcodes/deadmau5-helmet/data/cal/psu/s0500.jpg

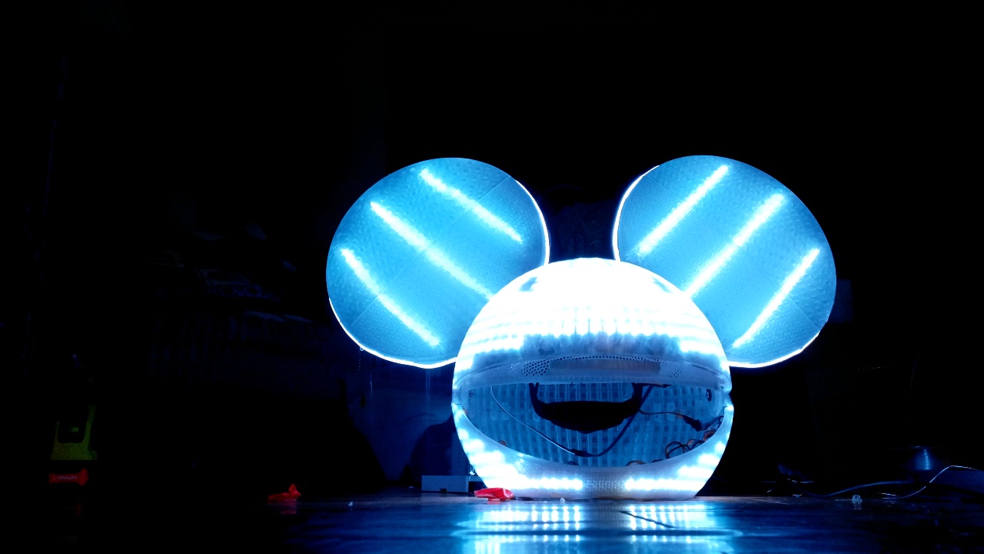
data/cal/psu/s0500.jpg
