vortexcodes/deadmau5-helmet/docs/images/cad_led_map.png

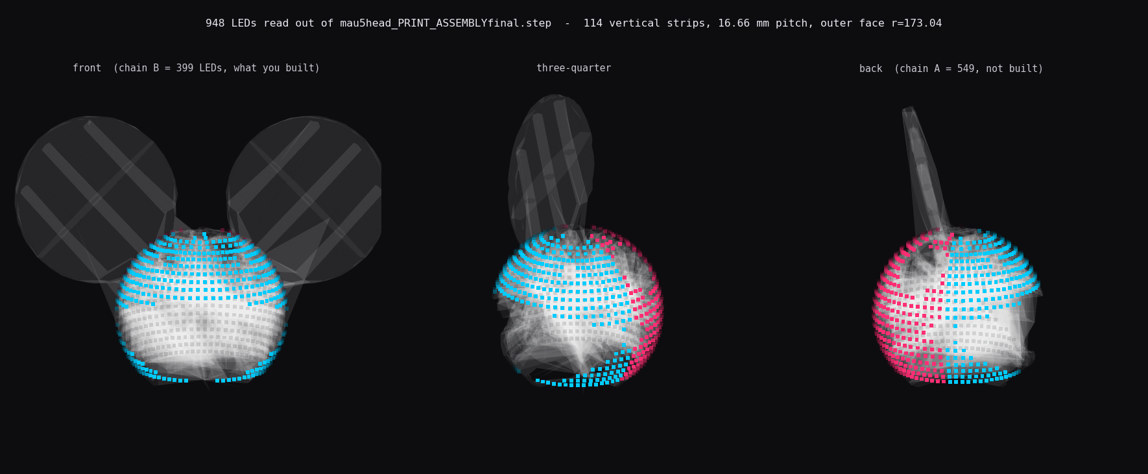
docs/images/cad_led_map.png
