vortexcodes/deadmau5-helmet/docs/images/cal_example.png

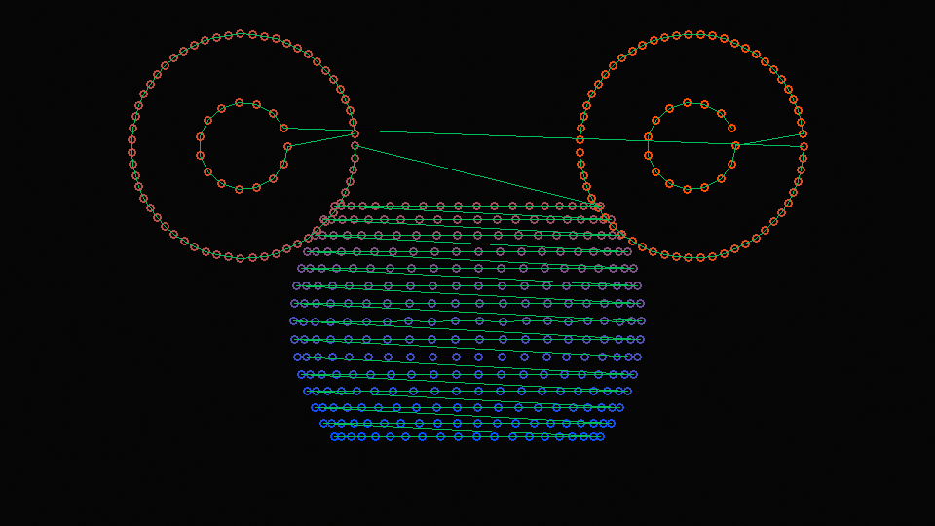
docs/images/cal_example.png
