vortexcodes/deadmau5-helmet/docs/images/face_check.png

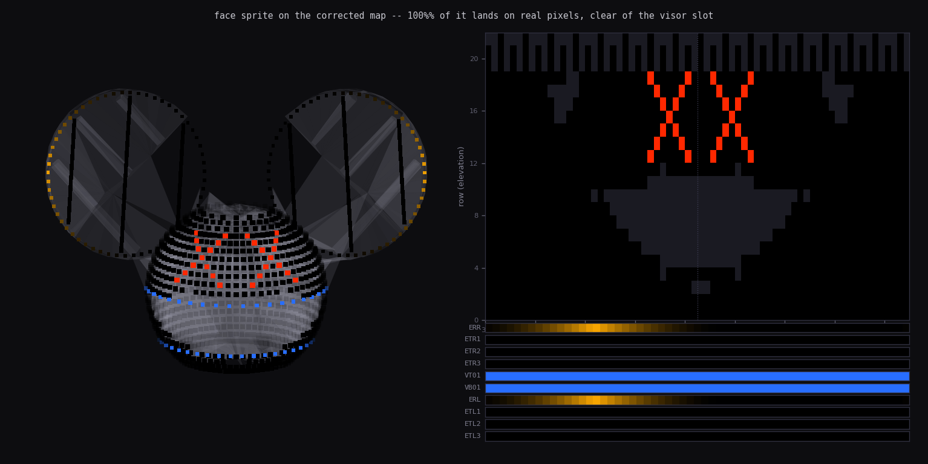
docs/images/face_check.png
