vortexcodes/deadmau5-helmet/docs/images/layout_check.png

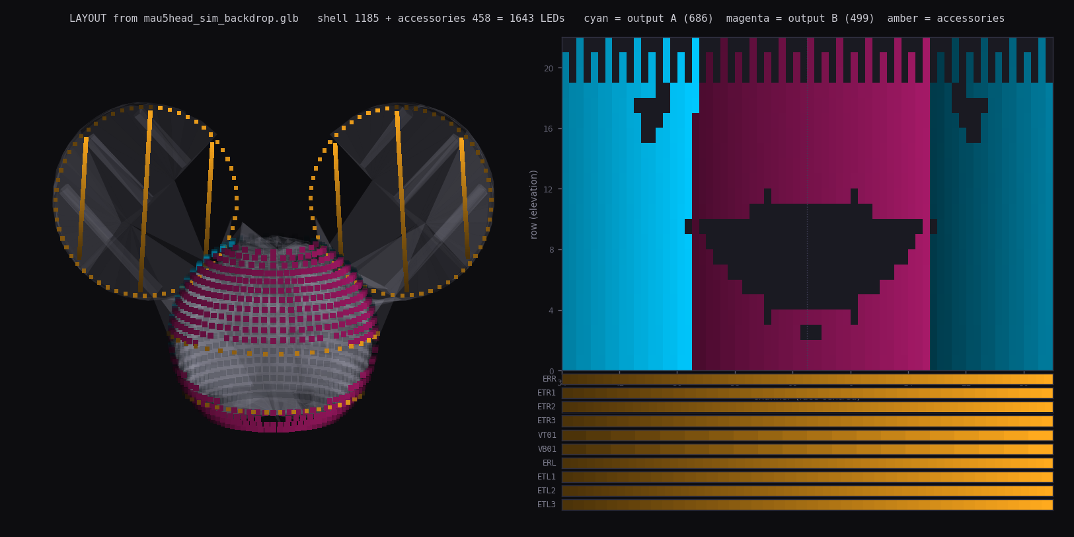
docs/images/layout_check.png
