vortexcodes/deadmau5-helmet/docs/images/preview_strobe_orbit.gif

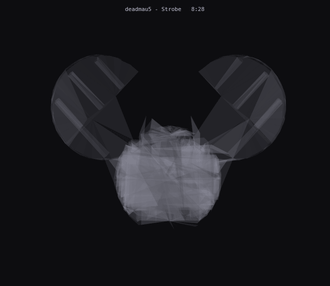
docs/images/preview_strobe_orbit.gif
