vortexcodes/deadmau5-helmet/docs/images/route_traced.png

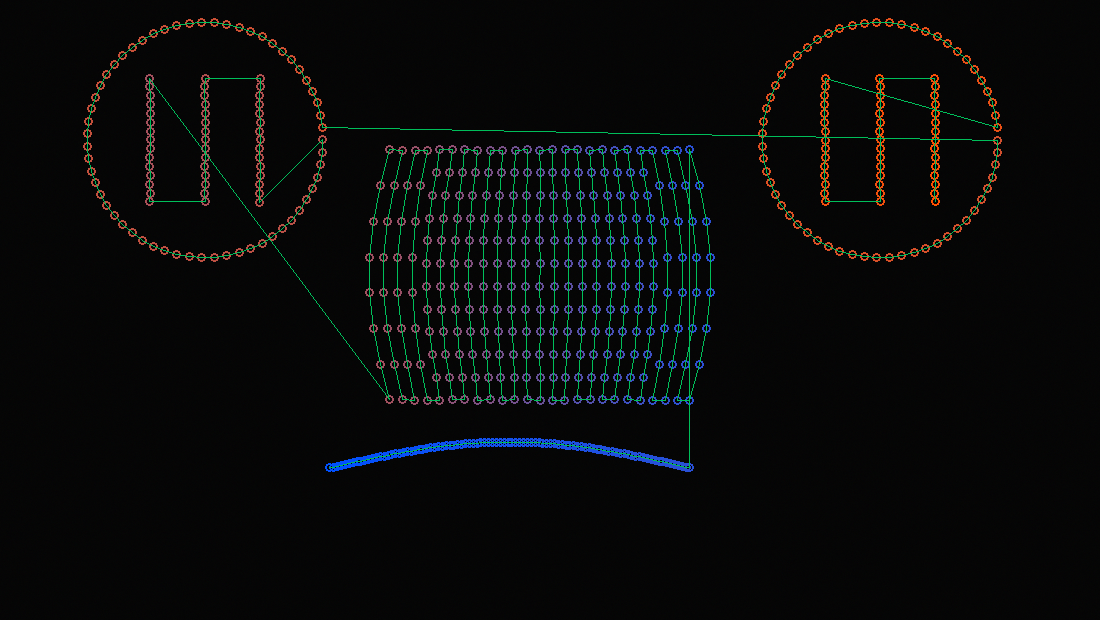
docs/images/route_traced.png
