vortexcodes/deadmau5-helmet/docs/images/sim_demo.png

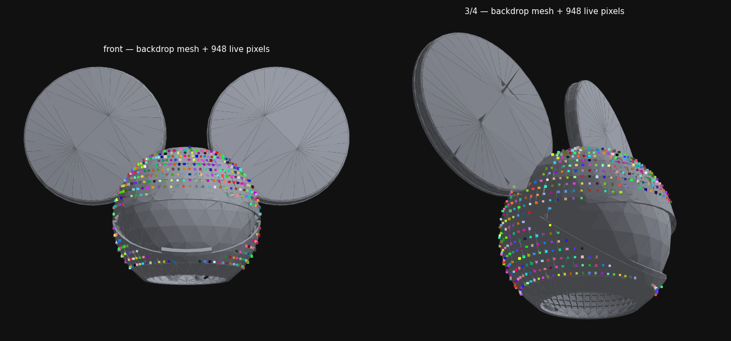
docs/images/sim_demo.png
