vortexcodes/deadmau5-helmet/cad/reference/BOM_original_plan.csv

category | item | spec | qty | unit | used_for | notes | approx_usd | amazon_link | link_notes
LEDs | WS2815 12V addressable strip | 60 LED/m, 10 mm wide, IP30 (bare — IP65 sleeve is 12 mm and won't fit the 10.6 mm groove) | 5 | 5 m reel | shell pixels (948) + ear blades (6 tubes x 2 strips) | 15.8 m shell + 3.2 m blades + waste = ~22 m. WS2815 has backup data line — a dead pixel won't kill the chain | 100-150 | https://www.amazon.com/ws2815-Pixels-Individually-Addressable-Dual-SignalIP30/dp/B083PMQ7V1 | WS2815 12V 60/m IP30 white PCB 5m. Alt (choose 60/IP30 variant): https://www.amazon.com/WS2811-WS2815-WS2812B-WS2813-Addressable/dp/B0DRHV294F
LEDs | COB addressable pre-diffused strip 12V | WS2811 COB, 10 mm wide, ~96 IC/m, white diffuser face | 1 | 5 m reel | ear rim channels (2 x 0.99 m) + visor light-pipe troughs (2 x 0.34 m) | 2.7 m needed. Must be 10 mm wide to fit the 10.6 mm channels | 25-40 | https://www.amazon.com/ALITOVE-Addressable-3600LEDs-Programmable-Controller/dp/B0C9BZ3MJ5 | ALITOVE 12V WS2811 COB 720/m 10 mm. Alt: BTF FCOB 12V 630/m 10 mm https://www.amazon.com/clp/B0C45BGC39
LEDs | Blade diffusion film | lightsaber blade diffuser film or 100 g/m2 drafting vellum, ~250 mm wide | 1 | roll / 2 sheets | inside the 6 polycarbonate tubes | roll it into each tube around the strip pair | 5-15 | https://thesaberarmory.com/products/blade-diffusion-film | not on Amazon as such; saber-shop film, or drafting vellum; Adafruit method = corrugated plastic + tape
Control | WLED controller — GLEDOPTO Elite ESP32 (Amazon) or QuinLED Dig-Uno | WLED, ESP32, 12 V in, level shifter, ≥2 outputs, fused | 1 | ea | helmet pixel controller | Dig-Quad if you later want accessories on their own outputs | 35-45 | https://www.amazon.com/GLEDOPTO-Controller-Ethernet-Network-Addressable/dp/B0GJZYWVQ7 | Amazon option that meets every requirement. Dig-Uno alt: https://www.drzzs.com/shop/dig-uno-diy-rgb-led-controller-w-wled-preassembled/
Control | Raspberry Pi 4 (2 GB) + case + 32 GB microSD | Pi 4 for the 3.5 mm audio jack | 1 | ea | Falcon Player: plays song + light sequence in sync; WiFi hotspot; phone page | Zero 2 W works with a USB audio dongle | 60-80 | https://www.amazon.com/Raspberry-Pi-Model-2GB/dp/B09TTNPB4J | bare board; or CanaKit Basic Kit with PSU https://www.amazon.com/CanaKit-Raspberry-Basic-Kit-2GB/dp/B07TYK4RL8
Control | USB-C cable 1 m | 5 V 3 A rated | 1 | ea | Pi power from your battery pack |  | 5-8 |  | generic — any listing matching the spec
Control | 3.5 mm TRS audio cable 1 m |  | 1 | ea | Pi -> speaker AUX in |  | 4-6 |  | generic — any listing matching the spec
Power | 12 V cigarette-lighter plug lead | 16 AWG, fused plug, 1.5-2 m | 1 | ea | battery pack -> helmet 12 V | most packs limit the jack to 10 A: set WLED ABL to 8 A (~100 W) | 8-12 | https://www.amazon.com/YonHan-Replacement-Cigarette-Lighter-Extension/dp/B07L9HQ25S | 16AWG, 15A fused, 2-pack — swap in a 10A fuse
Power | GX16-4 aviation connector (panel jack + plug) | 4-pin; wire pins 1+2 = +12, 3+4 = GND | 1 | pair | helmet 12 V inlet (Ø16 hole at the back) | or XT60 panel mount if you prefer — same hole | 4-8 | https://www.amazon.com/BQLZR-Silver-Aviation-GX16-4-Connector/dp/B00IJ673ZW | 5 pairs; 16 mm panel hole
Power | Blade fuse holder inline + 10 A fuses | ATO/ATC | 1 | ea + 5 fuses | on the tray before the Dig-Uno |  | 5-8 |  | generic — any listing matching the spec
Power | Hookup wire 18 AWG red/black |  | 10 | m | 12 V distribution + power injection | inject 12 V at 4-5 points along the 22 m of strip — the chain jumpers are the natural spots | 8-12 |  | generic — any listing matching the spec
Power | Hookup wire 22 AWG 3-conductor | stranded, silicone or PVC | 15 | m | pixel data/power jumpers (124 shell jumpers + accessories) |  | 10-15 |  | generic — any listing matching the spec
Connectors | JST-SM 3-pin pigtail pairs |  | 12 | pair | disconnects at ears (4) | visor (1) | tray feeds | spares |  | 8-12 | https://www.amazon.com/WESIRI-3pin-JST-SM-Connectors/dp/B0BW777LBK | 10 pairs 22AWG; buy 2
Connectors | Wago 221 or solder seal connectors |  | 1 | assortment | power injection taps |  | 8-12 |  | generic — any listing matching the spec
Mechanical | Clear polycarbonate tube 1 in OD x 3/4 in ID | 1/8 in wall | 2 | 36 in length | ear blades: per ear 1 x 343 + 2 x 250 mm (843 mm) | 1/8 wall matters — thinner tube is 4-7x floppier and the ears rely on these across layer lines | 30-50 | https://www.amazon.com/Small-Parts-Clear-Polycarbonate-Tube/dp/B003TJ9YI8 | one 6 ft covers both ears; 24 in alt https://www.amazon.com/Polycarbonate-Tubing-Wall-Clear-Color/dp/B00193SSPG
Mechanical | Clear silicone tubing 6 mm OD | 4 mm ID, food/aquarium grade | 1 | m | visor light pipes (2 x 340 mm) |  | 4-8 | https://www.amazon.com/Silicone-Tubing-Flexible-Rubber-Transparent/dp/B0D5V31T3V | 4x6 mm, 5 m
Mechanical | Neodymium disc magnets 6 x 3 mm N42 |  | 20 | pack | visor hold-closed/open (8 used) | glue with E6000/CA; dry-fit polarity first | 8-12 | https://www.amazon.com/Small-6x3mm-Round-Disc-Magnets/dp/B0C7LTPX49 | 6x3 N48 100-pack (stronger than N42; fine)
Mechanical | Hard hat Pyramex Ridgeline cap style vented HP44110V | ABS, 4-point ratchet | 1 | ea | head mount | vented version — airflow inside a sealed sphere | 12-27 | https://www.amazon.com/Pyramex-Safety-HP44110V-Ridgeline-4-Point/dp/B00MGMWOY0 | white vented; black graphite vented https://www.amazon.com/Pyramex-Ridgeline-4-Point-Suspension-Graphite/dp/B078B9QD55
Mechanical | Hard hat chin strap | Pyramex HPCS or generic 2-point | 1 | ea | 4.5 kg on your head — not optional |  | 5-10 |  | not found by search — look for 'Pyramex HPCS' or any 2-point hard hat chin strap
Hardware | Brass heat-set inserts 10-32 | 6.4 mm OD hole, ~7 mm long | 50 | pack | 28 used: 12 seam pads + 8 ear tenons + 4 hat standoffs + 2 tray + 2 pivot pins |  | 12-18 | https://www.amazon.com/initeq-Threaded-Inserts-Printing-Plastic/dp/B07B9MVCKW | choose #10-32 SHORT variant (fits the 7.5 mm pilots)
Hardware | 10-32 socket cap screws 3/8 in |  | 20 | ea | seam plates (12) + tray (2) |  | 5-8 | https://www.amazon.com/Stainless-Steel-Socket-Screw-Assortment/dp/B00CHQ96LO | kit: 10 each of 1/2, 3/4, 1, 1-1/4 — use 1/2 where 3/8 is listed
Hardware | 10-32 socket cap screws 1/2 in |  | 10 | ea | ear tenons (8) |  | 4-6 | https://www.amazon.com/Stainless-Steel-Socket-Screw-Assortment/dp/B00CHQ96LO | kit: 10 each of 1/2, 3/4, 1, 1-1/4 — use 1/2 where 3/8 is listed
Hardware | 10-32 socket cap screws 3/4 in |  | 6 | ea | hard hat -> crown plate standoffs (4) |  | 4-6 | https://www.amazon.com/Stainless-Steel-Socket-Screw-Assortment/dp/B00CHQ96LO | kit: 10 each of 1/2, 3/4, 1, 1-1/4 — use 1/2 where 3/8 is listed
Hardware | 10-32 socket cap screws 1 in |  | 4 | ea | pivot caps (2) |  | 3-5 | https://www.amazon.com/Stainless-Steel-Socket-Screw-Assortment/dp/B00CHQ96LO | kit: 10 each of 1/2, 3/4, 1, 1-1/4 — use 1/2 where 3/8 is listed
Hardware | 10-32 fender washers |  | 6 | ea | under the hat bolts inside the hat shell |  | 3-5 |  | generic — any listing matching the spec
Filament | PETG natural/translucent | 1.75 mm | 2 | kg | shell halves (1.33 L solid ~1.7 kg) + designed supports | pixel windows are 2 mm — natural PETG glows; opaque black + SKIN=0 is the crisper alternative | 40-60 | https://amazon.com/OVERTURE-Filament-Transparent-Consumables-Dimensional/dp/B07SB761QR | Overture PETG, Transparent variant
Filament | PETG clear | 1.75 mm | 2 | kg | ear halves (4 pieces at ~10% gyroid) + visor | low infill so the blades light the whole ear; gyroid scatters light nicely | 40-60 | https://www.amazon.com/Polymaker-Filament-1-75mm-Strong-Cardboard/dp/B09DKMCNMW | Polymaker PolyLite PETG Clear 1 kg, buy 2
Filament | PETG black | 1.75 mm | 0.5 | kg | seam plates | pivot caps | crown plate | drill template | tray |  | 12-15 | https://amazon.com/OVERTURE-Filament-Transparent-Consumables-Dimensional/dp/B07SB761QR | same Overture listing, Black variant
Filament | 1.75 mm filament offcuts |  | - | - | seam alignment stubs (12 x 16 mm) | from any spool | 0 |  | generic — any listing matching the spec
Consumables | CA glue medium + activator |  | 1 | ea | shell seam + ear halves |  | 8-12 |  | generic — any listing matching the spec
Consumables | E6000 or clear silicone |  | 1 | tube | magnets + tubes in bores |  | 5-8 |  | generic — any listing matching the spec
Consumables | Black electrical or gaffer tape |  | 1 | roll | light dam on visor trough walls; hides jumpers |  | 4-8 |  | generic — any listing matching the spec
Consumables | Kapton or foam tape |  | 1 | roll | strip backing where adhesive is weak on curved walls |  | 5-8 |  | generic — any listing matching the spec
Tools | Heat-set insert tip for soldering iron | 10-32 / M5 size | 1 | ea | 28 inserts |  | 5-10 |  | generic — any listing matching the spec
Tools | Step drill or 5.2 mm bit |  | 1 | ea | hard hat crown holes (use the printed template) |  | 5-10 |  | generic — any listing matching the spec
