vortexcodes/deadmau5-helmet/cad/assembly/wallmount_ASSEMBLY.step

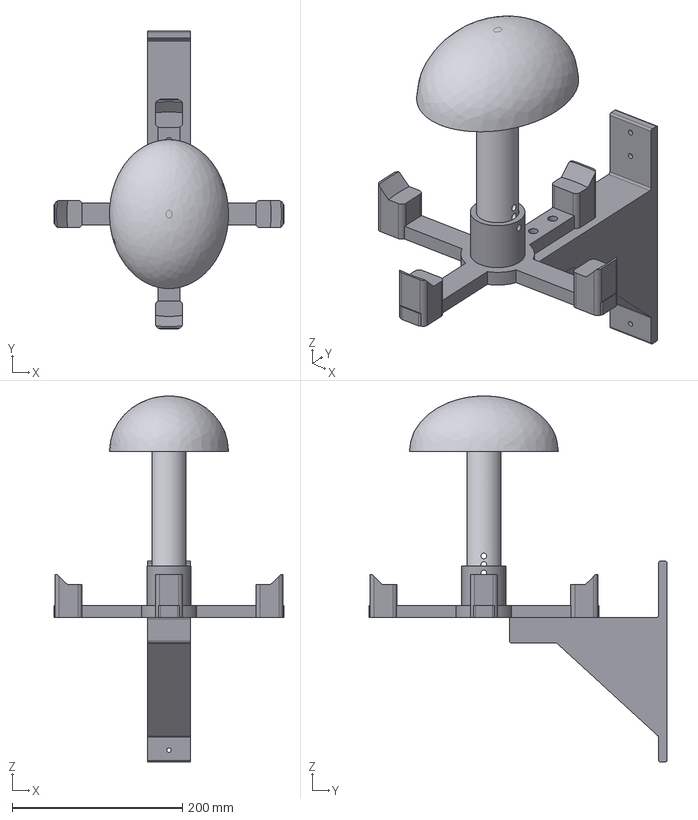
[picture p24: CAD file, 2026-11-05]
cad/assembly/wallmount_ASSEMBLY.step
270.0 x 350.2 x 429.9 mm
bracket
cradle
post
dome
