vortexcodes/deadmau5-helmet/cad/parts/wallmount_cradle.step

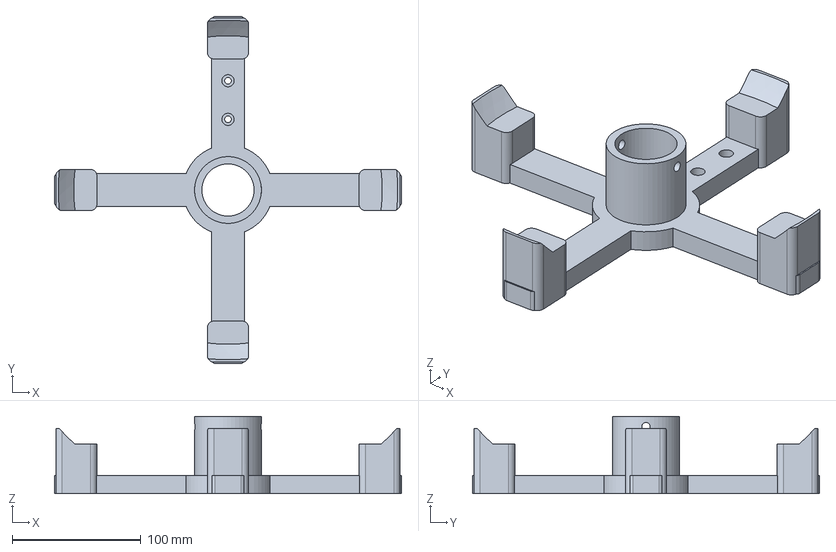
[picture p25: CAD file, 2026-11-05]
cad/parts/wallmount_cradle.step
270.0 x 270.0 x 60.0 mm
