vortexcodes/deadmau5-helmet/cad/visor/visor_B_2.5mm-holes_3.4-pitch.3mf

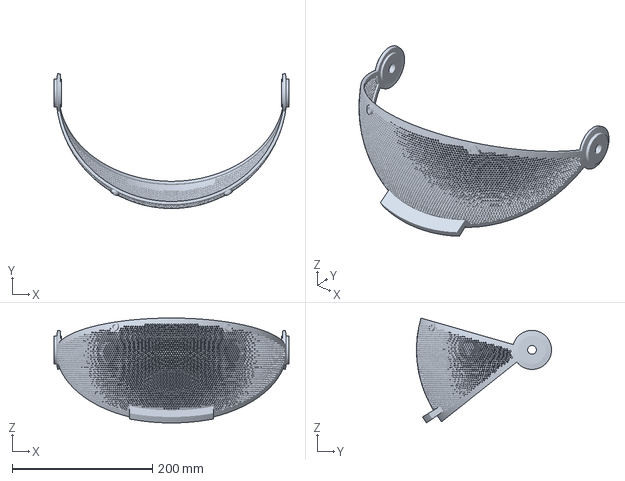
[picture p26: CAD file, 2026-11-01]
cad/visor/visor_B_2.5mm-holes_3.4-pitch.3mf
335.3 x 192.7 x 149.7 mm
