vortexcodes/deadmau5-helmet/mau5head_sim_backdrop.stl

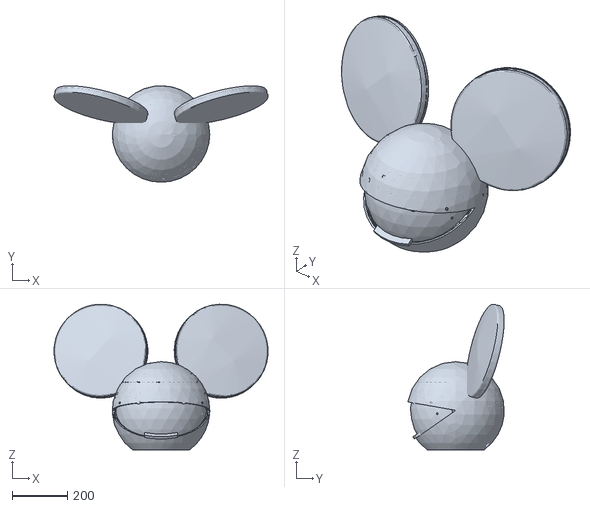
[picture p27: CAD file, 2026-10-27]
mau5head_sim_backdrop.stl
778.0 x 350.9 x 529.2
