vortexcodes/deadmau5-helmet/cad/assembly/ear_L.step

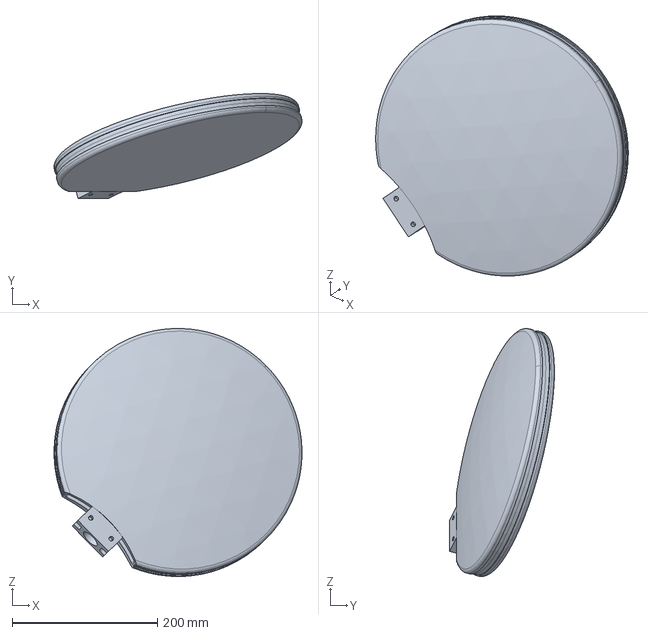
[picture p28: CAD file, 2026-11-01]
cad/assembly/ear_L.step
341.9 x 144.7 x 341.9 mm
