vortexcodes/deadmau5-helmet/cad/parts/shell_half_BOTTOM.step

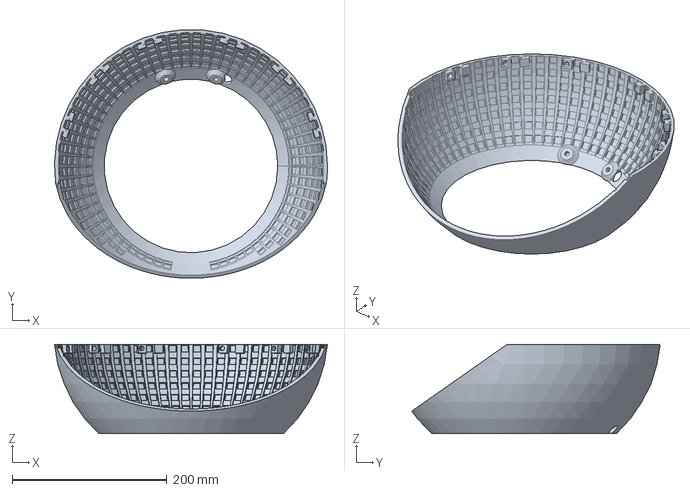
[picture p29: CAD file, 2026-11-05]
cad/parts/shell_half_BOTTOM.step
352.9 x 321.3 x 115.2 mm
