vortexcodes/deadmau5-helmet/cad/assembly/hardhat_envelope_REFERENCE.step

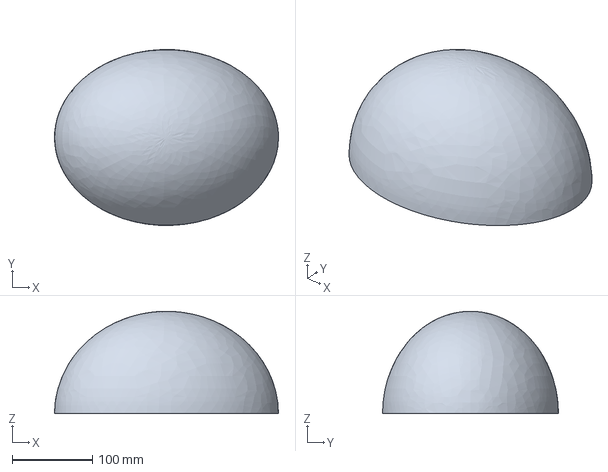
[picture p30: CAD file, 2026-11-01]
cad/assembly/hardhat_envelope_REFERENCE.step
280.0 x 219.8 x 128.0 mm
