vortexcodes/deadmau5-helmet/cad/parts/seam_plate.step

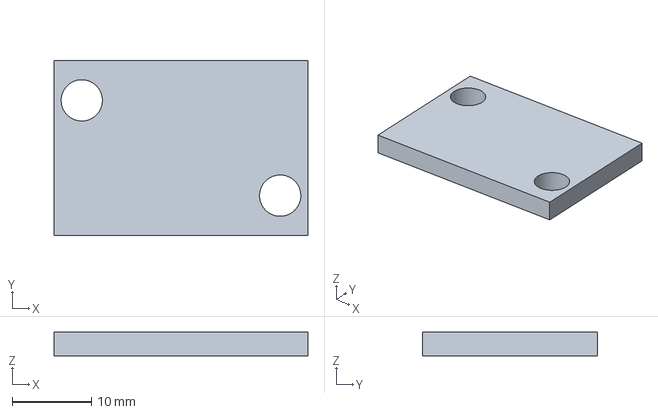
[picture p31: CAD file, 2026-11-01]
cad/parts/seam_plate.step
32.0 x 22.0 x 3.00 mm
