vortexcodes/deadmau5-helmet/cad/parts/ear_half_bottom.step

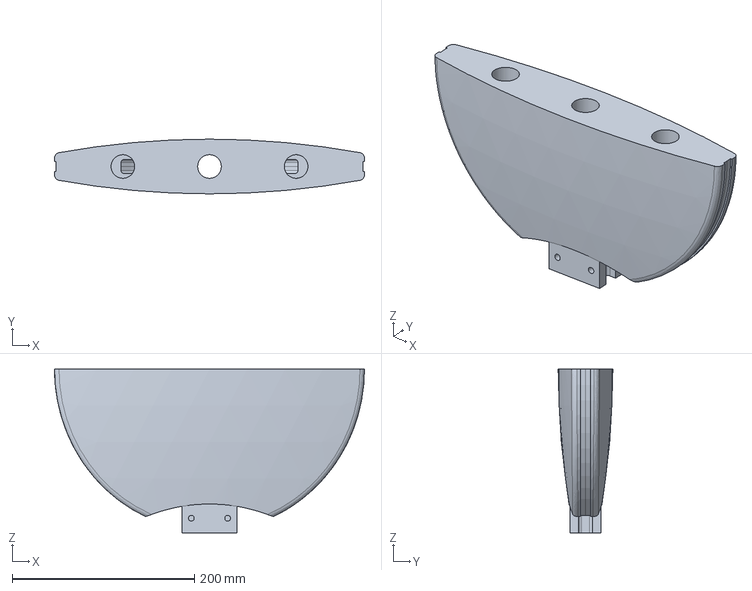
[picture p32: CAD file, 2026-11-01]
cad/parts/ear_half_bottom.step
340.0 x 60.0 x 179.5 mm
