vortexcodes/deadmau5-helmet/cad/visor/visor_C_3.3mm-holes_4.2-pitch.3mf

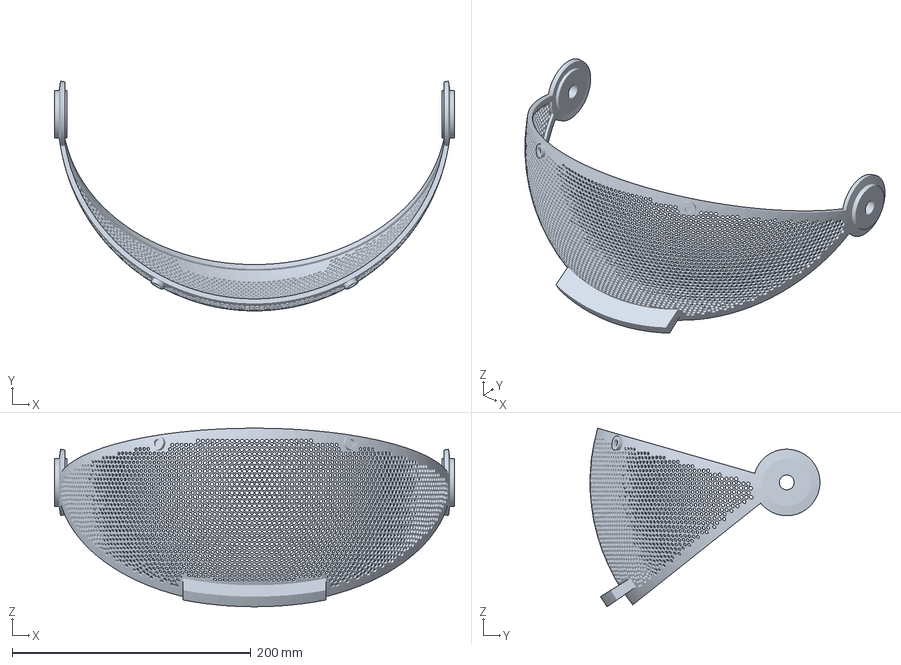
[picture p33: CAD file, 2026-11-01]
cad/visor/visor_C_3.3mm-holes_4.2-pitch.3mf
335.3 x 192.7 x 149.7 mm
