vortexcodes/deadmau5-helmet/cad/parts/shell_half_TOP_supports.step

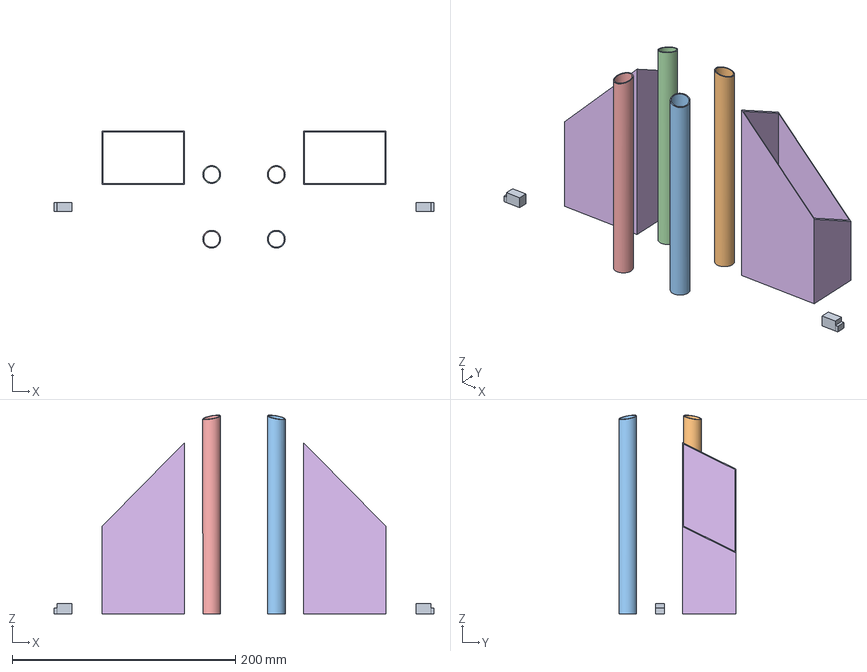
[picture p34: CAD file, 2026-11-01]
cad/parts/shell_half_TOP_supports.step
340.3 x 105.0 x 178.1 mm
