vortexcodes/deadmau5-helmet/cad/visor/visor_A_2.9mm-holes_3.8-pitch_RECOMMENDED.3mf

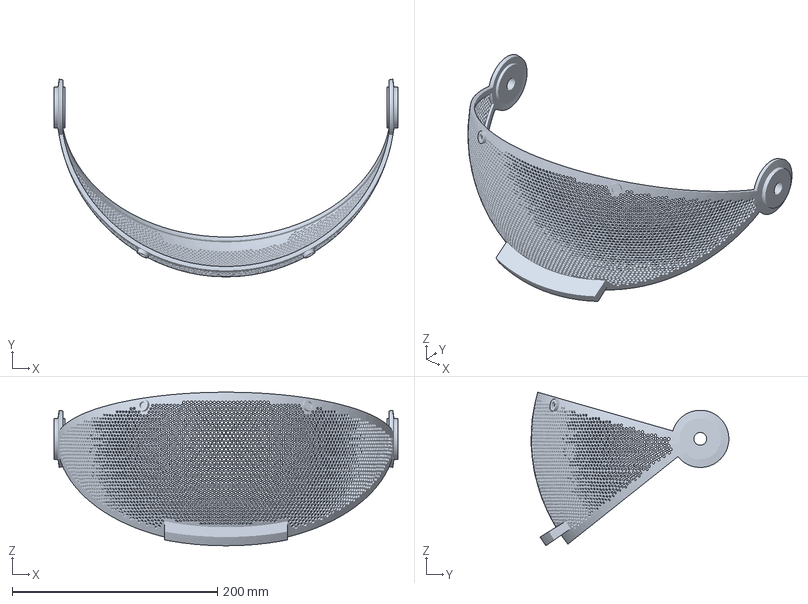
[picture p35: CAD file, 2026-11-01]
cad/visor/visor_A_2.9mm-holes_3.8-pitch_RECOMMENDED.3mf
335.3 x 192.7 x 149.7 mm
