vortexcodes/deadmau5-helmet/cad/parts/hat_spacers.step

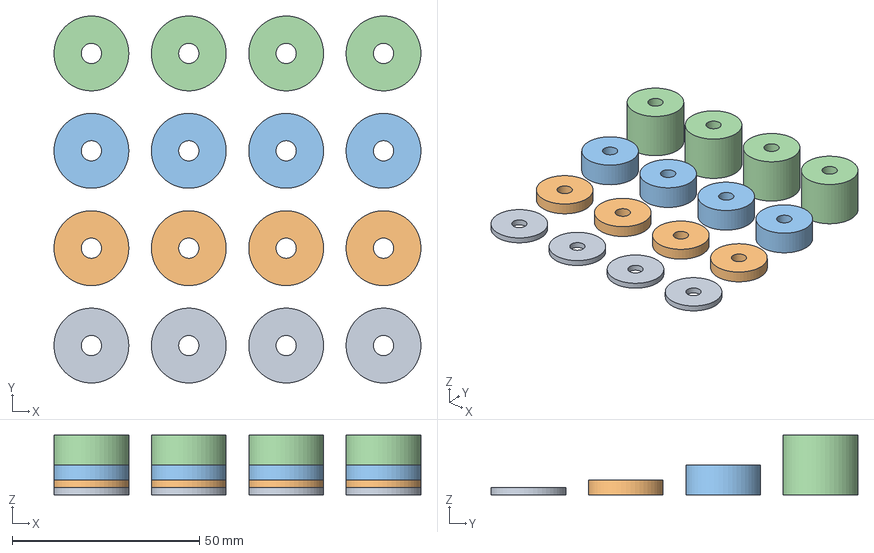
[picture p36: CAD file, 2026-11-01]
cad/parts/hat_spacers.step
98.0 x 98.0 x 16.0 mm
