vortexcodes/deadmau5-helmet/cad/parts/electronics_tray.step

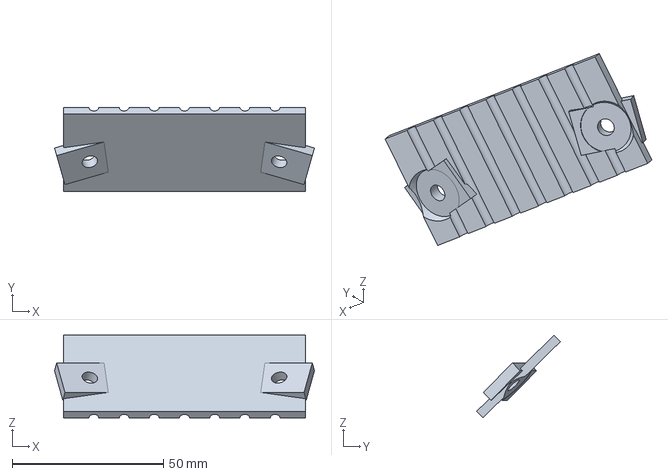
[picture p37: CAD file, 2026-11-01]
cad/parts/electronics_tray.step
86.1 x 27.8 x 27.4 mm
