vortexcodes/deadmau5-helmet/cad/parts/ear_half_top.step

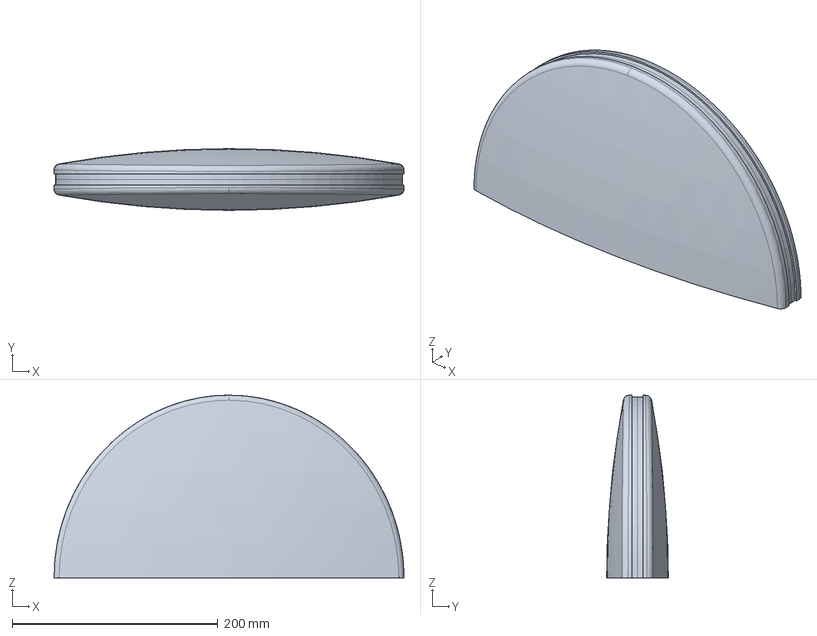
[picture p38: CAD file, 2026-11-01]
cad/parts/ear_half_top.step
340.0 x 60.0 x 177.5 mm
