vortexcodes/deadmau5-helmet/cad/parts/hat_drill_template.step

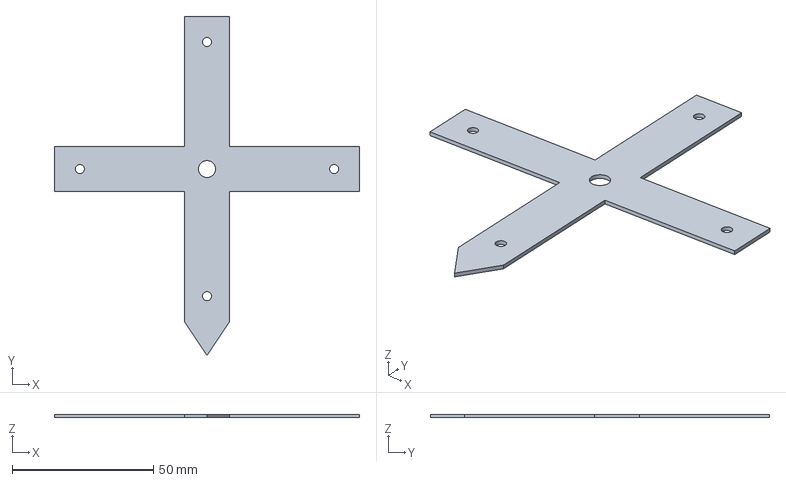
[picture p39: CAD file, 2026-11-01]
cad/parts/hat_drill_template.step
108.0 x 120.0 x 1.20 mm
