vortexcodes/deadmau5-helmet/cad/parts/pivot_cap.step

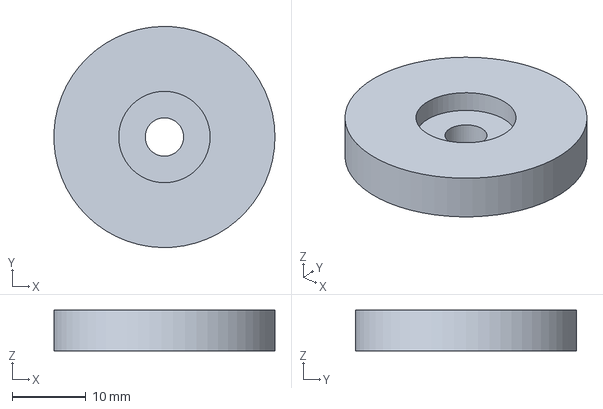
[picture p40: CAD file, 2026-11-01]
cad/parts/pivot_cap.step
30.0 x 30.0 x 5.53 mm
