vortexcodes/deadmau5-helmet/cad/parts/wallmount_dome.step

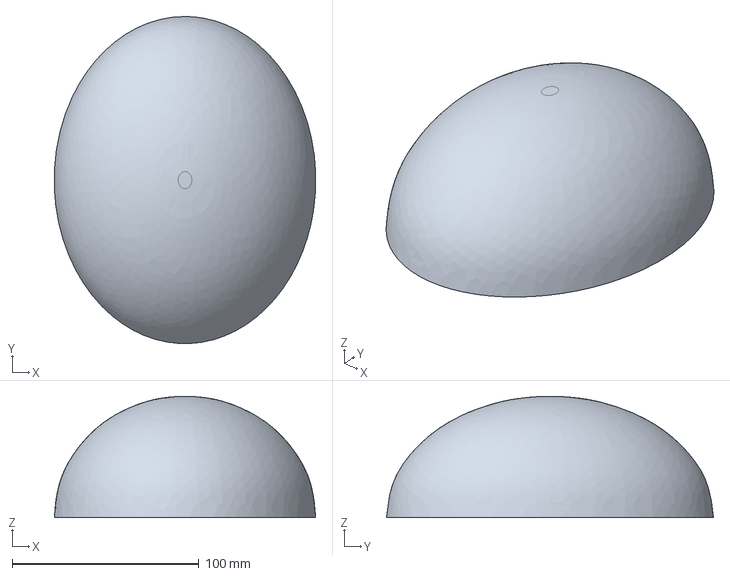
[picture p41: CAD file, 2026-11-01]
cad/parts/wallmount_dome.step
139.8 x 174.9 x 64.9 mm
