vortexcodes/deadmau5-helmet/cad/parts/hat_crown_frame.step

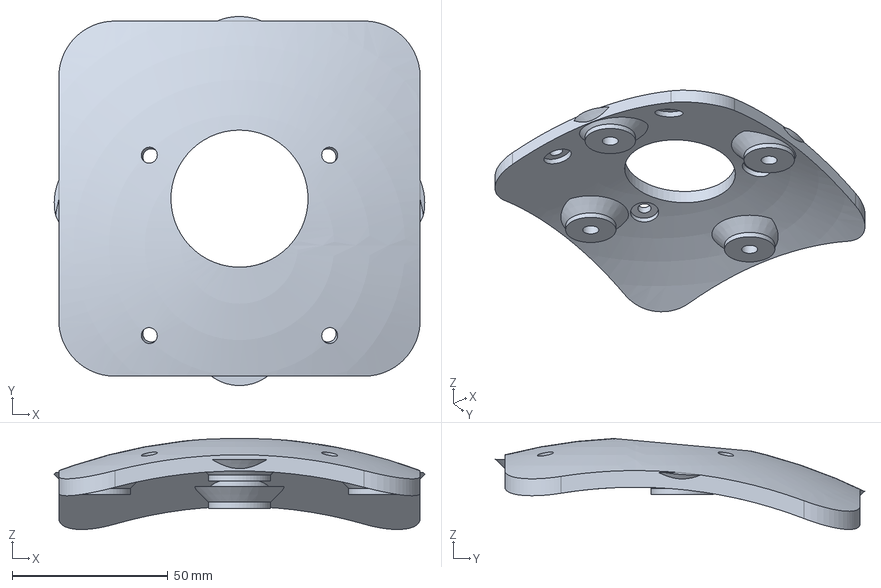
[picture p42: CAD file, 2026-11-01]
cad/parts/hat_crown_frame.step
118.9 x 118.4 x 29.2 mm
