vortexcodes/deadmau5-helmet/cad/parts/shell_half_TOP.step

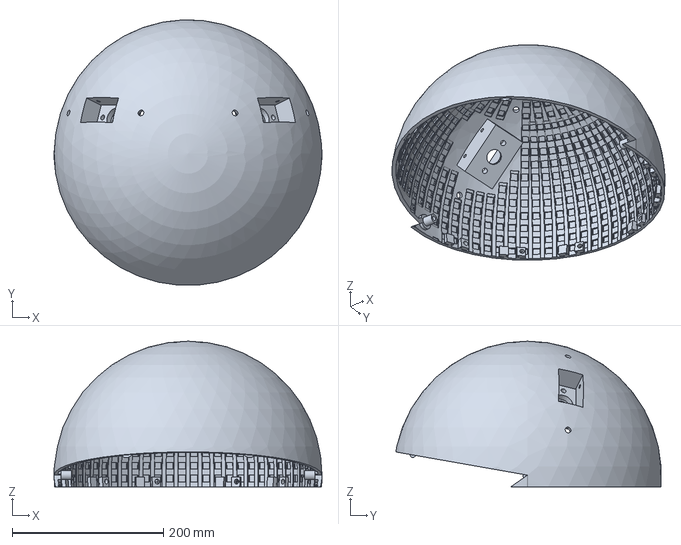
[picture p43: CAD file, 2026-11-01]
cad/parts/shell_half_TOP.step
354.3 x 350.7 x 192.6 mm
