vortexcodes/deadmau5-helmet/cad/parts/wallmount_post.step

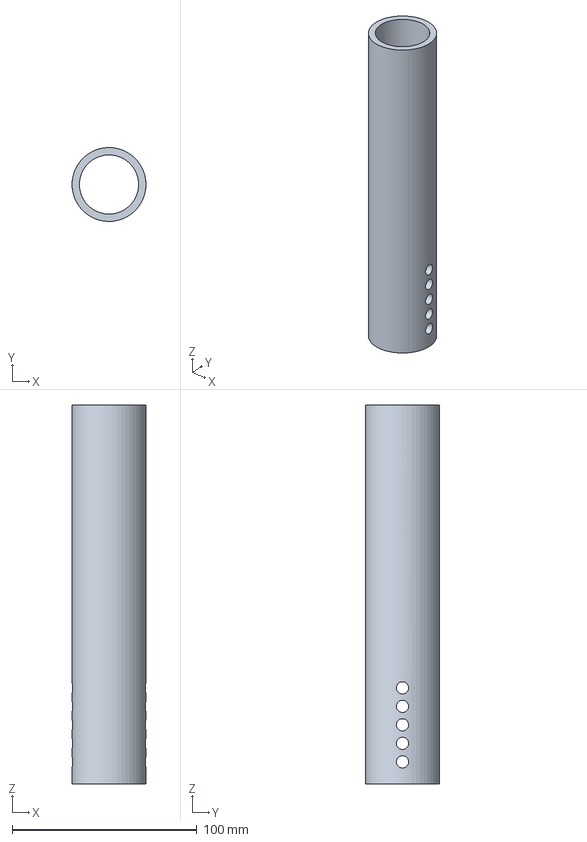
[picture p44: CAD file, 2026-11-01]
cad/parts/wallmount_post.step
40.0 x 40.0 x 205.0 mm
