vortexcodes/deadmau5-helmet/cad/parts/wallmount_bracket.step

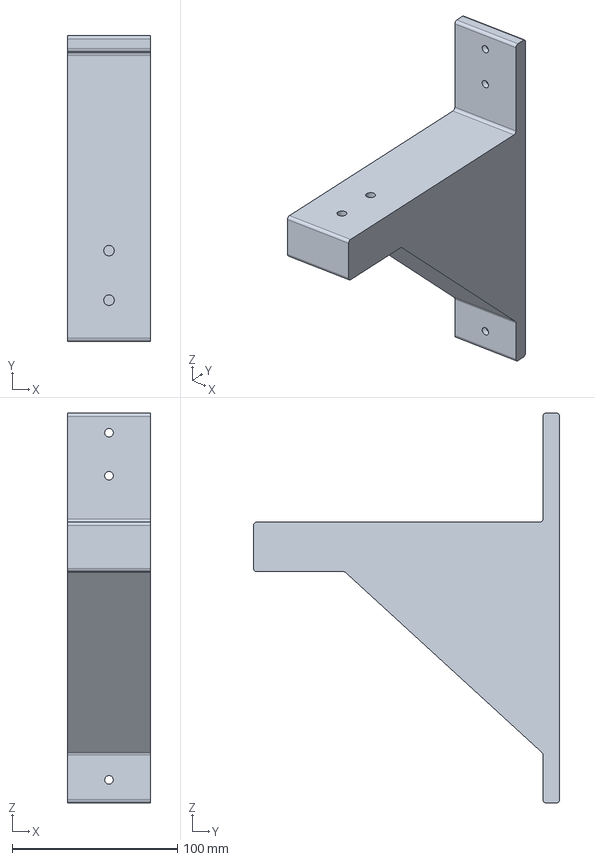
[picture p45: CAD file, 2026-11-01]
cad/parts/wallmount_bracket.step
50.0 x 185.2 x 236.0 mm
