vortexcodes/deadmau5-helmet/cad/parts/visor.step

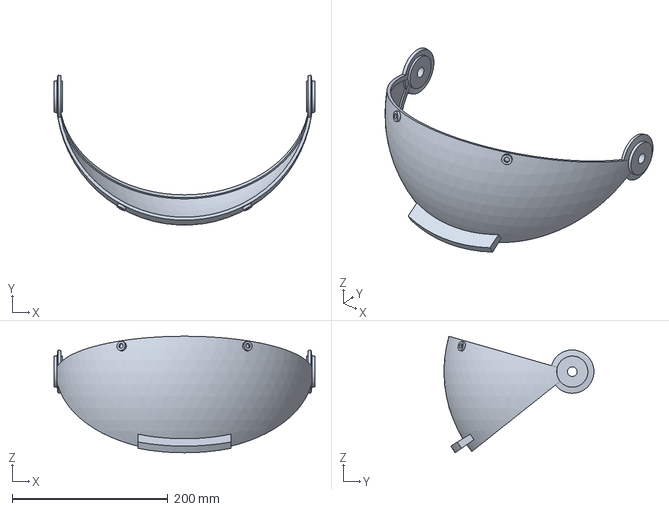
[picture p46: CAD file, 2026-11-01]
cad/parts/visor.step
335.3 x 192.7 x 149.8 mm
