vortexcodes/deadmau5-helmet/(list of files, cad)

Other CAD files:
cad/visor/visor_orig-spacing_2.0mm-holes_3.6-pitch.3mf
cad/visor/visor_open_2.5mm-holes_3.6-pitch.3mf
cad/assembly/ear_R.step
cad/parts/wallmount_bracket.stl
cad/parts/wallmount_cradle.stl
cad/parts/wallmount_dome.stl
cad/parts/wallmount_post.stl
