vortexcodes/deadmau5-helmet/cad/reference/WIRING_DIAGRAM.png

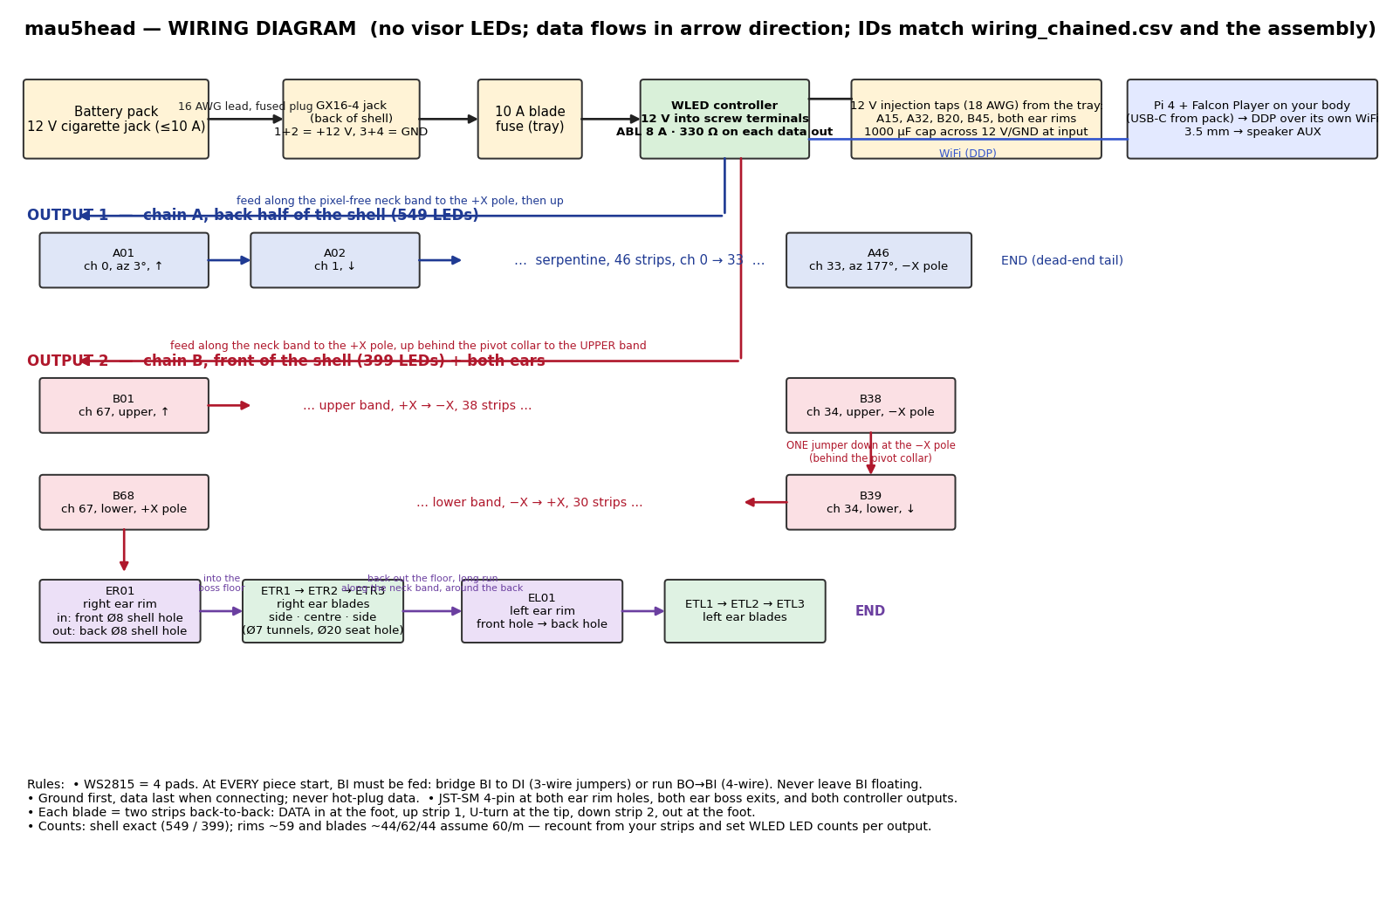
cad/reference/WIRING_DIAGRAM.png
