vortexcodes/deadmau5-helmet/cad/reference/wiring_map.png

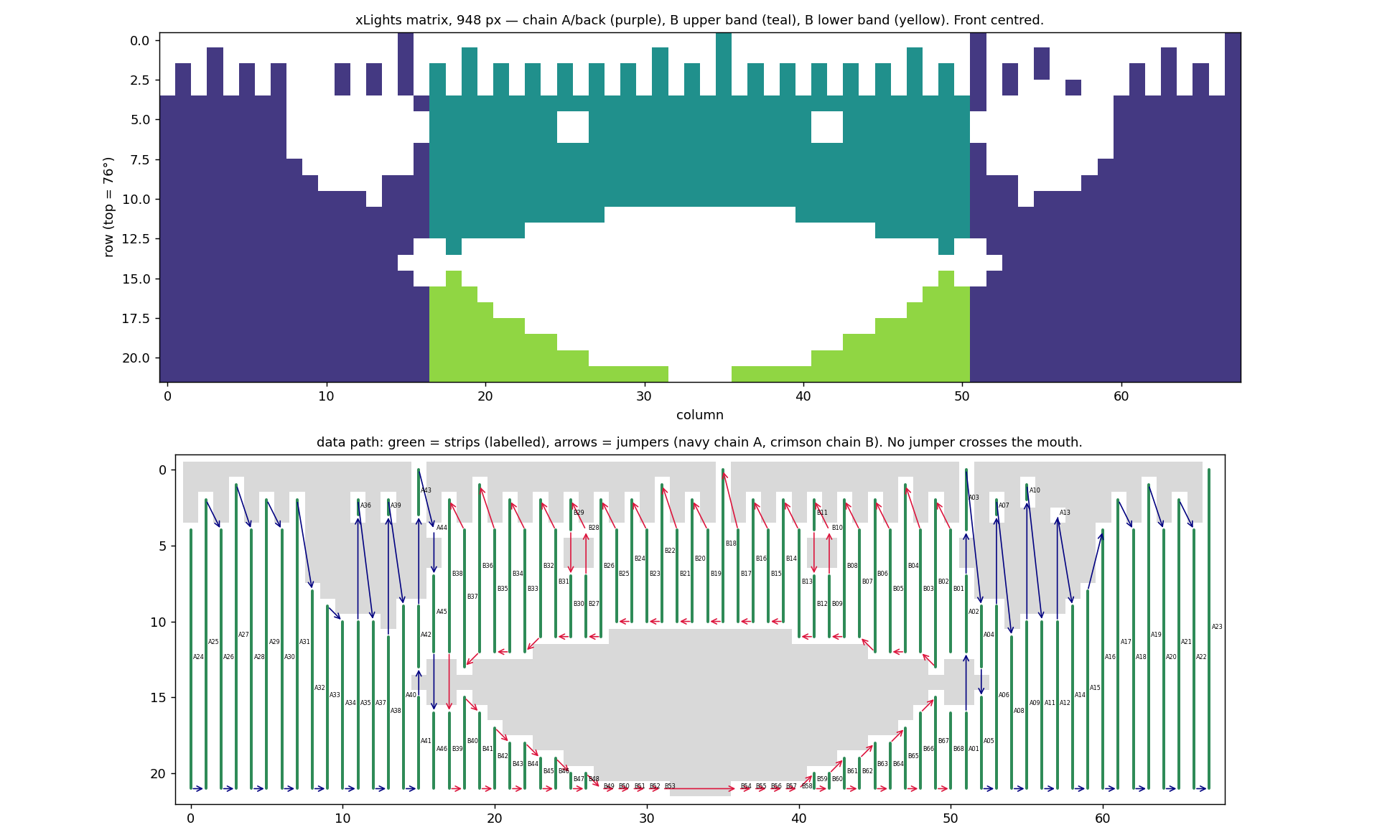
cad/reference/wiring_map.png
