vortexcodes/deadmau5-helmet/tests_more/README.md

Each `*.py` here defines `GROUP = [t_..., ...]`; `test_mau5.py` runs them
under the file's name.  Helpers from the main suite (`ok`, `eq`, `note`,
`HERE`) are importable with `from test_mau5 import ok, eq, note, HERE`.
