vortexcodes/deadmau5-helmet/docs/history/README.md

# Old status reports

Written while the helmet was being built, in the order they happened, and left as they were. Paths and
states in them are out of date. `HANDOFF.md` and `README.md` at the top of the repo are current.
