vortexcodes/deadmau5-helmet/mau5relay.py

#!/usr/bin/env python3
"""mau5relay -- the helmet and the camera, from somewhere else.

Three things live on the home network and nothing else can see them:
the controller, the camera page, and whatever is driving the helmet.
That is fine until the person working on it is at school behind a
VPN, which is most of the time, and it is the main reason a change
takes a day to try.

So: one process on a machine at home, which reaches all three, and
one door into it.  Behind that door are the camera's newest frame,
a proxy to the controller's JSON API, and the player page itself, so
a phone or a laptop anywhere can do what the phone at home can do.

    python3 mau5relay.py --token <something long>
    python3 mau5relay.py --token <...> --tls          # https, self-signed

**The door needs a key and it needs a tunnel.**  The token is checked
on every request -- without `--allow-open` the server refuses to
start without one -- but a token on plain http over the open internet
is a token somebody can read.  How the traffic gets here is not this
script's business and it should not be: forward a port, run a
Tailscale node, point a Cloudflare tunnel at it.  What this does is
make sure that whatever arrives has the key, and that the camera and
the helmet are reachable through one address instead of three.
"""

from __future__ import annotations

import argparse
import hmac
import json
import os
import shutil
import ssl
import threading
import time
import urllib.error
import urllib.request
from http.server import ThreadingHTTPServer, BaseHTTPRequestHandler

import re
import subprocess

import mau5wled


def start_tunnel(port, timeout=45, scheme="http"):
    """A Cloudflare quick tunnel to the local relay, and its URL.

    Tailscale was the plan and the school blocks it: every
    *.tailscale.com host resets on the TLS handshake, controlplane
    and the DERP relays included, so there is nothing to configure
    round it.  Cloudflare is open from the same network, looks like
    ordinary HTTPS to a CDN, and brings a real certificate -- which
    is also the one thing that would let the player install as a
    proper app.

    A quick tunnel is anonymous and its hostname is random and
    changes every restart.  That is fine for working from school and
    it is not a long-term address; a named tunnel on your own domain
    is, and wants a Cloudflare account.

    The URL is public the moment it exists.  The relay's token is the
    only thing in front of the helmet, so make it a long one.
    """
    if not shutil.which("cloudflared"):
        raise SystemExit(
            "cloudflared is not installed.\n"
            "  brew install cloudflared")
    proc = subprocess.Popen(
        ["cloudflared", "tunnel", "--url", "%s://127.0.0.1:%d" % (scheme, port),
         "--no-autoupdate"],
        stdout=subprocess.PIPE, stderr=subprocess.STDOUT,
        text=True, bufsize=1)
    url, seen = None, []
    end = time.time() + timeout
    while time.time() < end:
        line = proc.stdout.readline()
        if not line:
            break
        seen.append(line.rstrip())
        m = re.search(r"https://[a-z0-9][a-z0-9-]*\.trycloudflare\.com", line)
        if m:
            url = m.group(0)
            break
    if url is None:
        proc.terminate()
        raise SystemExit("cloudflared did not produce a URL in %ds:\n  %s"
                         % (timeout, "\n  ".join(seen[-8:])))
    # keep draining, or the pipe fills and cloudflared wedges
    threading.Thread(target=lambda: [None for _ in proc.stdout],
                     daemon=True).start()
    return proc, url


def tailnet_ip():
    """This machine's address on the tailnet, if it is on one.

    Worth printing rather than making somebody go and look: the whole
    point of the tunnel is that the address is stable and the LAN one
    is not, so the tailnet URL is the one to bookmark.
    """
    for cmd in (["tailscale", "ip", "-4"],
                ["/Applications/Tailscale.app/Contents/MacOS/Tailscale",
                 "ip", "-4"]):
        try:
            out = subprocess.run(cmd, capture_output=True, text=True,
                                 timeout=5)
        except (OSError, subprocess.SubprocessError):
            continue
        for line in (out.stdout or "").splitlines():
            line = line.strip()
            if line.startswith("100."):
                return line
    return None

HERE = os.path.dirname(os.path.abspath(__file__))
OFFLINE = os.path.join(HERE, "data", "offline")


PAGE = r"""<!doctype html>
<html lang="en"><head><meta charset="utf-8">
<meta name="viewport" content="width=device-width,initial-scale=1,viewport-fit=cover">
<title>mau5head · remote</title>
<style>
 :root{--bg:#0b0b10;--fg:#e9e9f0;--dim:#8b8b99;--line:#24242e;--ok:#2f9e63;--bad:#c2344d}
 *{box-sizing:border-box}
 body{margin:0;background:var(--bg);color:var(--fg);padding:12px;
   font:15px/1.45 ui-sans-serif,system-ui,-apple-system,Roboto,sans-serif}
 h1{font-size:17px;margin:0 0 8px}
 img{width:100%;border-radius:10px;border:1px solid var(--line);display:block;background:#000}
 .row{display:flex;gap:8px;align-items:center;margin:8px 0;flex-wrap:wrap}
 .dim{color:var(--dim);font-size:12px;font-variant-numeric:tabular-nums}
 a.btn,button{min-height:44px;border-radius:10px;border:1px solid var(--line);
   background:#191922;color:var(--fg);font:500 15px/1 inherit;padding:0 14px;
   display:inline-flex;align-items:center;text-decoration:none}
 .dot{width:9px;height:9px;border-radius:50%;background:var(--bad);display:inline-block}
 .dot.on{background:var(--ok)}
</style></head><body>
<h1>mau5head <span class="dim">· remote</span></h1>
<div class="row"><span class="dot" id="d"></span>
  <span class="dim" id="s">…</span></div>
<img id="cam" alt="the helmet">
<div class="row">
  <button id="slower">slower</button>
  <button id="faster">faster</button>
  <a class="btn" id="app" href="#">open the player</a>
</div>
<div class="row"><span class="dim" id="helmet">…</span></div>
<script>
const q = new URLSearchParams(location.search);
const tok = q.get('t') || '';
let every = 1000, timer = null, n = 0;
document.getElementById('app').href =
  '/app/mau5.htm?api=/helmet&t=' + encodeURIComponent(tok);
function tick() {
  const img = document.getElementById('cam');
  img.src = '/cam.jpg?t=' + encodeURIComponent(tok) + '&n=' + (n++);
}
async function status() {
  try {
    const r = await fetch('/status?t=' + encodeURIComponent(tok));
    const d = await r.json();
    document.getElementById('d').className = 'dot' + (d.camera_age !== null && d.camera_age < 10 ? ' on' : '');
    document.getElementById('s').textContent =
      d.camera_age === null ? 'no camera frame yet'
        : ('camera ' + d.camera_age.toFixed(1) + 's old · ' + d.frames + ' frames');
    document.getElementById('helmet').textContent = d.helmet
      ? ('helmet ' + d.helmet.name + ' · ' + d.helmet.leds + ' leds · '
         + (d.helmet.on ? 'on' : 'off') + ' · ' + d.helmet.power + ' mA')
      : 'helmet not answering';
  } catch (e) {}
}
function restart() { if (timer) clearInterval(timer); timer = setInterval(tick, every); }
document.getElementById('slower').onclick = () => { every = Math.min(8000, every * 2); restart(); };
document.getElementById('faster').onclick = () => { every = Math.max(250, every / 2); restart(); };
tick(); restart(); status(); setInterval(status, 4000);
</script></body></html>
"""
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
