vortexcodes/deadmau5-helmet/mau5verify.py

#!/usr/bin/env python3
"""mau5verify -- light targeted patterns so photos can settle the walk.

The walk of the chain lines up with the CAD to 57 of 68 strips.  The
eleven that disagree are not scattered: they sit in three clusters, and
each cluster has the right *total*, which is what a boundary tapped a
beat early looks like.  Guessing which side is right from the numbers
alone is not possible -- the chain cannot tell you where it is in space.
A photograph can.

So each check here lights a pattern designed to make exactly one
question visually obvious, and says what to look for.  Nothing is
inferred; you look, and tell me.

Same heat rules as the walk: nothing exceeds the lit cap or the
brightness cap, both applied to the pixel data before it is sent.

    python3 mau5verify.py              # find the controller, serve the page
    python3 mau5verify.py --list       # print the checks and exit
"""

from __future__ import annotations

import argparse
import json
import os
import threading
import time
from http.server import ThreadingHTTPServer, BaseHTTPRequestHandler

import numpy as np

import mau5map
import mau5wled

HERE = os.path.dirname(os.path.abspath(__file__))

RED, GRN, BLU, WHT, YEL, CYN = ((255, 0, 0), (0, 255, 0), (0, 0, 255),
                                (255, 255, 255), (255, 200, 0), (0, 255, 255))
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
