vortexcodes/deadmau5-helmet/(commit log)

2026-10-27 deadmau5 helmet: mapping, power guard, preset engine, shows, controller
    622 LEDs mapped -- 399 shell from CAD with strip direction decided by
    camera, 220 ears measured directly, 3 interpolated. Hardware residual
    21 mm on the shell, 6.3 and 8.9 mm on the ears.
    Includes the thermal budget that keeps the WS2815s from melting the hot
    glue that holds them on, 34 presets, five beat-aligned shows and the
    phone controller.
    [front_only_chainB.csv, led_positions.csv, mau5head_sim_backdrop.stl, pixel_map.csv, pixel_map_cad.csv, wiring_chained.csv]
2026-10-27 Let the show test run on a clone that has no music
    The tracks are not distributed with the source, so a fresh clone has
    every show file and none of the audio. Checking the mp3 unconditionally
    reported that as a broken show. The structural checks are unchanged;
    the track is only checked when it is on disk, and the run now says how
    many it found.
    [test_mau5.py]
2026-10-27 Ship the show analyses so a clone without the music still has the beats
    The cached analysis is the whole beat grid in about a hundred kilobytes
    and Music reads it without opening the audio, but _music_for refused it
    whenever the track was absent -- which is every machine except the one
    the show was built on, now that the mp3s are not distributed. Five
    caches, 520 KB, and show building, preview and the beat tests all work
    from a bare clone.
2026-10-27 Live preview in the controller, and two power bugs it uncovered
    The controller page now draws the frame the controller is actually
    sending -- post-guard, in the helmet's own screen frame -- so presets
    can be judged with no hardware attached. Encoded at gamma 0.45,
    because LED drive is linear and sight is not: drawn linearly the shell
    disappears under the ears and the preview misrepresents every
    full-helmet preset.
    Building it turned up two things.
    The first: power.json and pixel_map.csv disagreed about where the ear
    rims are. The map says 492-527; power.json had 462-557. Sixty LEDs
    that are physically tubes were being capped at the rim ceiling and
    charged against the rim budget -- dimme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
    [mau5ctl.py, mau5lapse.py, mau5power.py, mau5wled.py, test_mau5.py]
2026-10-27 Lock effects to the beat grid, and make the preview look like the helmet
    Sync. A scanner with a 2.4 s period against a 128 bpm track completes
    1.28 cycles a bar: never wrong, never once landing with the music, and
    no palette rescues it. Periodic presets now take their phase from the
    beat grid with the cycle quantised to a power-of-two number of beats,
    so the same scanner lands every bar. Which presets may be treated
    this way is measured rather than assumed -- a test re-derives the
    table by comparing render(t) with render(t + period), and fails if a
    preset with a cycle parameter is neither listed nor explicitly
    excluded. Live presets run on the track's clock too, so choosing one
    by hand b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
    [mau5ctl.py, mau5engine.py, mau5show.py, mau5song.py, test_mau5.py]
2026-10-27 Fix the controller's three real bugs, and lay it out for a desktop
    Songs failing. A browser seeking in an <audio> element drops the
    connection mid-write, which is routine; it arrived as BrokenPipeError
    out of socketserver, took the handler down with a traceback, and with
    keep-alive on left the next request on that connection going nowhere.
    HEAD was answered 501, so players that ask before they fetch saw a
    track as unplayable before requesting a byte. And the server bound
    0.0.0.0 while cloudflared resolves localhost to ::1 first, so the
    tunnel intermittently reported the whole service as down depending on
    what the resolver returned. Now: disconnects are swallowed, HEAD is
    answered, and the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
    [mau5ctl.py]
2026-10-28 Regenerate the camera page's certificate when the lease moves
    The certificate's subjectAltName held the address the machine had the
    night it was made. DHCP moved it, and a browser given an https URL
    with a bare IP has no hostname to fall back on -- so a stale SAN is
    not a warning anybody can click through, it is a flat refusal that
    looks exactly like the server being down.
    Checked on every start now, and regenerated when the current address
    is missing. Through a config file rather than -addext, because macOS
    ships LibreSSL and LibreSSL does not take -addext.
    [mau5eye.py]
2026-10-28 Stop streaming black: "off" now switches the helmet off
    A helmet being sent 622 black pixels forty times a second is, from
    outside, indistinguishable from one with a broken data line or a dead
    supply -- and because realtime overrides whatever WLED would otherwise
    show, it stays dark across reboots and power cycles too. WLED boots
    into its default preset, lights up for the two seconds before the
    first DDP frame lands, and then goes out. That is exactly the
    symptom, and an evening went into pulling apart wiring that was fine.
    "off" now stops the stream and posts the controller off; selecting
    anything re-arms it. A reconnect forgets the cached output state,
    because a reboot forgets everythi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
    [mau5ctl.py, mau5engine.py, mau5power.py, test_mau5.py]
2026-10-28 Boot dark, soft start, and a measured power budget
    The helmet was switching everything on and then falling over. It was
    not the steady draw: mau5psu ramps the load in steps and watches the
    board's uptime and the camera for the first step it cannot hold, and
    the helmet held 2.1 A of LED current sustained and 2.2 A as a single-
    frame jump from dark, with no reset either way.
    What it could not hold was power-on. WLED's boot default was
    {on: true, bri: 128}, so every time the supply came up it was asked
    for the whole array within a second of boot -- while it was still
    charging the strips' capacitors and starting the ESP32. It boots dark
    now, and the controller climbs into the load over half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
    [mau5ctl.py, mau5psu.py, test_mau5.py]
2026-10-28 Find the green corner: the swapped span is 492-529, not 492-527
    Two LEDs at the end of the ear outline are physically GRB and were
    not being corrected, so they showed green wherever red was asked for.
    Adds mau5hue, which asks each LED for red and then for green and
    compares how much red comes back. Reading a single red frame and
    asking whether it looks green is the obvious test and it does not
    work: the camera's white balance drifts between shots by more than
    the effect, and two passes of the same range disagreed with each
    other about sixteen LEDs. The differential cancels that, because
    both frames are taken under the same conditions and a correct LED
    emits more red when asked for red whi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
    [mau5hue.py, test_mau5.py]
2026-10-28 Read the swapped span from strips.json instead of hardcoding it
    The previous commit extended the span to 492-529 and left
    t_colour_correction asserting that 528 was untouched, so it failed on
    the correct answer. Hardcoding the boundary in the test is what let
    that happen; it now reads the file and checks both sides of each edge.
    [test_mau5.py]
2026-10-28 Rebuild the show engine: phrases, layers, dynamics and cue gain
    The old builder picked one effect per section with pool[k % len(pool)]
    and held it, often for forty seconds. Round-robin over a fixed list
    is exactly as repetitive as it sounds, and nothing in it knew where
    the drops were.
    The analysis now carries three band curves instead of one loudness
    curve, a chromagram per bar, and a label on every bar saying whether
    the track is building, dropping, falling or steady. A single loudness
    curve cannot tell a breakdown with a loud pad from a drop with a kick
    under it, and those should not look the same.
    The builder works in phrases of four to sixteen bars by level rather
    than whole section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
    [mau5show.py, mau5song.py]
2026-10-28 Add mau5gaps: where the strip skips and the CAD does not
    The shell's positions come from the CAD, which lays every strip out
    unbroken at a 16.7 mm pitch. The real strips are cut around the visor
    magnets, so LEDs are physically absent where the model has some, and
    chain indices do not skip -- everything after a cut sits further along
    its strip than the map believes.
    Compares each measured step against the step the map predicts through
    the solved camera, rather than against the strip's median step, which
    assumes constant apparent pitch and so flags the silhouette where a
    sphere compresses a pitch into a couple of pixels. That took the
    flagged count from 54 to 19.
    It is deliberately not pre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
2026-10-28 Glyphs: scatter the strokes, use the 5x7 face; catch the camera moving
    Three things, all from chasing why the digits came out wrong.
    paint() draws a bitmap by gather and by scatter. The gather is the
    obvious half, every LED looking up the cell it falls in, and on its
    own it loses strokes: the LEDs are not a grid, and a quarter of the
    cells of a seven-row glyph on this dome contain no LED at all. The
    scatter gives every set cell that caught nothing the nearest LED
    within 1.4 cells, so a one-pixel stem cannot vanish into a gap.
    That removed the only reason countdown used a 3x5 face, and 3x5 was
    the worse problem: with cells that large a digit lights half the dome
    and the gaps that make it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
    [mau5baralign.py, mau5engine.py, mau5locate.py]
2026-10-28 Replace the CAD shell positions with where the camera says they are
    The shell map came from the CAD and the ears from measurement, and I
    had been treating the CAD half as ground truth. It is the worse half.
    Fitting the camera on the shell and projecting everything: the ears
    land within 3 px while the shell itself sits at 17 px, and the ears
    were derived under a different camera pose, so their agreement across
    two poses is real validation and the shell's disagreement is real
    error. Constrained to the sphere, the camera wants to move each shell
    LED a median of 18 mm -- more than one LED pitch.
    Two wrong turns on the way, both worth recording. Inverting the
    projection at the CAD depth drive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
    [led_positions.csv, pixel_map.csv, pixel_map_cad.csv]
2026-10-28 Rebuild shows and the preset sheet against the corrected map
    Also corrects the bar-sweep report, which still described the shell as
    'the control, its positions come from the CAD'. It is not a control
    any more and the number it prints is self-consistency rather than
    accuracy: the bar is drawn from the map and sampled at each LED's
    measured pixel, so a map agreeing with the measurement scores well
    whether the measurement was right or not. What it does catch is a map
    disagreeing with itself, which the CAD shell did at sd 37 mm against
    the corrected map's 12.4.
    [mau5baralign.py]
2026-10-28 Put the ears where a viewer sees them, not where the azimuth said
    Jones found the first ~10 LEDs of the left ear looking wrong, and
    "either behind or something". Both halves of that are right.
    399-406 are a run of their own. Splitting ear1_tubes where the step
    between consecutive LEDs jumps gives 8, 19, 36 and 27; the first 8 are
    the strip crossing from the top of the shell up to the ear disc, not
    on the disc at all. The right ear has the same thing two LEDs long.
    mau5wled grows --range so they can be lit and looked at.
    The ears' depth was never measured and was not self-consistent either.
    mau5fitmap replaced x and z with the camera's answer and kept y from
    the parametric model evaluate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
    [pixel_map.csv]
2026-10-28 Offline mode: the animations, from a phone, with nothing else there
    At a show there is no house WiFi worth trusting and no reason to be
    carrying the laptop. The helmet brings up its own access point, the
    phone opens one page, and all 34 animations run.
    Where that page lives was forced rather than chosen. A browser cannot
    open a UDP socket, so DDP is out and the pixels go over WLED's JSON
    API. An https page cannot reach a plain-http 192.168 address, which
    rules out hosting it anywhere with a certificate and with it the whole
    installable-PWA route. A plain-http page is not a secure context, so
    no service worker will cache it and the laptop cannot serve it either.
    One HTTP server is on tha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
2026-10-29 Offline mode, measured against the helmet instead of a simulator
    The player went on the controller last session and was never run
    against it. Four things it assumed were wrong, and none of them
    could fail visibly without reading the strip back, so mau5peek is
    new: it opens WLED's own live-preview socket and reports the colour
    of every LED as the strip is driving it. No camera, no dark room,
    nothing to calibrate.
    What it found, in the order it mattered:
    An `i` write blanks the rest of the segment. Write LEDs 0-99, then
    100-199, and only the second hundred is lit. Deltas were therefore
    not an optimisation but a frame with most of the helmet switched off,
    and splitting a frame across mess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
    [mau5engine.py, mau5fake.py, mau5offline.py, mau5peek.py, mau5review.py, mau5show.py, test_mau5.py]
2026-10-29 Check the map by eye, one line at a time, and write down what you see
    The camera settled where 622 LEDs are and is right about nearly all
    of them. What it cannot settle is the handful it never saw properly:
    a strip crossing a gap edge-on, a run with LEDs cut out around a
    visor magnet, a disc whose tilt one pose cannot measure. Those are
    invisible to a solver and obvious to somebody standing in front of
    the helmet, and until now that person had nowhere to put what they
    saw.
    mau5lines lights one line at a time -- a vertical band across the
    face by default, or horizontal, or by depth, or one strip or one
    chain run -- and draws beside it where the map thinks those LEDs are.
    Two pictures of th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
2026-10-29 Shows offline, audio from the room, and two free frames a second
    The shows come over, without their analyses. Five cue lists are 27
    kB; the analyses are two megabytes against nine hundred kilobytes
    free, and they turn out not to be needed -- they existed to say where
    the beats and the bands were, and the phone is already measuring that
    from whatever it can hear. So the cue list says which effect is on
    screen and the room drives the brightness, the pulse and the
    overlays. What is lost is the clock, so the show is started by hand
    on the first beat, which is how a lighting desk works anyway.
    mau5show.Player is ported the same way the engine was, and checked
    the same way: both sides driven b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
2026-10-29 The track plays, the show follows it, and Spotify can supply the clock
    A show with no sound was half a show. The page now plays the track:
    pick the mp3 off the phone and the audio element becomes the clock,
    the volume control and the scrub bar at once. Reading the clock from
    the element rather than from a wall clock started by hand means it
    cannot drift from what the room hears, and pause and seek work for
    nothing. Picking a file called "deadmau5 - Strobe.mp3" selects the
    Strobe show by itself.
    The shows also have their real drive offline now. mau5drive carries
    mau5song's analysis to the controller -- envelopes at 20 Hz in eight
    bits, the beat and bar grids as they are, a chroma vector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
    [mau5drive.py, mau5offline.py, mau5peek.py, mau5spotify.py, test_mau5.py]
2026-10-29 Reach the helmet from somewhere else, keep it as an app, and stop it going dark
    Three things, all of which came out of the same complaint: the
    helmet is only workable from the room it is in.
    mau5relay puts one door in front of the three things that live on
    the home network -- the controller, the camera and the player -- so
    a laptop at school behind a VPN can see all of them through one
    address. A dashboard with the live camera frame and helmet status,
    the camera's newest frame, the controller's API proxied under
    /helmet, and the player itself served from here and pointed at that
    proxy. Every route needs a token and it refuses to start without
    one: it is proxying a controller with no authe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
2026-10-29 A second pose, and an instrument honest enough to say it is not enough
    mau5stereo solves both cameras against the shell -- 399 CAD-exact
    points make a calibration target -- and triangulates every LED seen
    from both. No model of the ear enters into it anywhere, which was
    the whole point: DISC_TILT_DEG has been a guessed zero since the
    ears were first fitted, with a note saying a second pose would
    measure it outright.
    It does not measure it, and the tool now demonstrates that rather
    than leaving somebody to find out downstream. Solving both cameras
    twice, once from the even shell LEDs and once from the odd, and
    triangulating with each, puts ear1's tilt at +30.4 and -35.5
    degrees. Sixty-six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
    [ears_stereo.csv, led_positions_pose4.csv]
2026-10-29 Print the tailnet address, and write down why that route
    The relay is reachable from school over Tailscale: both machines on
    one tailnet, a stable 100.x address whatever either is behind, and
    nothing exposed to the internet. The relay now finds and prints
    that address itself, because it is the one worth bookmarking and
    the LAN address is not.
    The two alternatives are written down with their costs: a forwarded
    port puts an unauthenticated controller on the open internet behind
    one token, and a Cloudflare tunnel is the better end state -- real
    certificate, which is also the only thing that would make the player
    a properly installable PWA -- but wants an account and a domain.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
2026-10-29 The school blocks Tailscale, so the tunnel is Cloudflare instead
    Measured from that network rather than guessed: every
    *.tailscale.com host completes the TCP handshake and is reset the
    moment the TLS ClientHello names it -- tailscale.com, login,
    controlplane and the DERP relays alike -- while github.com and
    example.com are untouched. SNI filtering of the whole domain.
    controlplane is the coordination server, so there is no client-side
    way round it and the Tailscale plan is simply dead from school.
    Cloudflare is open from the same network and ngrok's tunnel endpoint
    is not, so mau5relay grows --tunnel: it starts cloudflared against
    its own port, parses the hostname out, prints it with the t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
    [mau5relay.py]
2026-10-29 Tailscale is blocked twice over from school; tunnel SSH instead
    The login was never the problem. Measured on the same machine, both
    directions: with Cloudflare WARP off the school resets every
    *.tailscale.com on the TLS ClientHello, controlplane and the DERP
    relays included. With WARP on those hosts answer 200 and 302, and
    Tailscale still does not work, because WARP and Tailscale are both
    whole-device VPNs and macOS will not give them the same machine.
    The symptom is worth recognising rather than rediscovering:
    BackendState Running, InNetworkMap true, key valid until 2027, and
    Online false with InMagicSock false, InEngine false and health
    reporting it cannot reach the coordination server.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
    [mau5relay.py]
2026-10-29 Put a number on the ears: three LED pitches out, from a view that never saw them
    Simpler than the triangulation and harder to argue with. Solve each
    camera against the shell alone, project the map's own positions, and
    compare with where that camera actually saw each LED.
    pose 1 shell 0.5 mm ear1 13.2 mm ear2 10.4 mm
    pose 2 shell 4.7 mm ear1 47.4 mm ear2 59.5 mm
    Pose 1 is the view the ears were derived from, so it cannot fail on
    them, and it is still off by most of a 16.7 mm pitch. Pose 2 had no
    part in making the map: the shell comes back to a third of a pitch
    and the ears to three. That is the complaint, quantified, and it
    agrees with the triangulation's independent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
    [ears_stereo.csv]
2026-10-29 Let the shows be brighter, bounded by the ten-minute rule rather than a flat ceiling
    Jones lifted the power rule: peaks may go up for effects and shows,
    as long as nothing stays raised for ten minutes or more. That shape
    is already in power.json as a leaky bucket, so the lever is
    thermal.burst_j alone -- not the region ceilings, not budget_ma.
    What was actually binding was neither of those and not the global
    governor either: every show sat at 292-298 mA, which is 11 W minus
    7.5 W of standby, the thermal sustained floor exactly. The bucket
    was holding all five flat for their whole length.
    mau5tune is new and is how that was found. It renders a show end to
    end through the real engine and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
    [mau5tune.py, test_mau5.py]
2026-10-29 A simulator anyone can open, built from the parts that already existed
    Nothing new had to be written to make the helmet runnable in a
    browser. The engine, the power guard and the show player were
    ported to JavaScript for the phone controller and are checked
    against the Python on every commit; the audio analyser was written
    for the same page. mau5web assembles those four, the exported map
    and the cue lists into a static page, and remote/web/simulator.js
    draws all 622 LEDs where the camera measured them in three
    dimensions and lights them with that code.
    So it is not a mock-up of the effects, it is the effects, to 0.0002
    of a count out of 255. The power readout is real too -- the guard
    run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
2026-10-29 A timelapse that explains the calibration instead of just replaying it
    mau5lapse --explain builds a 44-second account of how the helmet is
    measured: the localisation pass, the bar sweep, the preset
    photographs, with title cards saying what each one is for.
    The localisation act is the point, and the obvious way to build it
    does not work. Accumulating the raw frames -- each has exactly one
    LED lit, so a running maximum should draw the helmet in its own
    light -- is a white blob by the two hundredth LED, because each LED
    blooms across a third of the shell and the room is not actually
    black. trace_map plots the measured centroids instead, in chain
    order, with a line to the previous LED on the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
    [mau5lapse.py]
2026-10-29 Every LED in a place the CAD has room for one
    The map took the CAD's wiring order for the shell and then slid each
    LED along the sphere onto its own camera ray. That fits the camera it
    was fitted to exactly -- 0.02 px, which was the giveaway -- and puts
    most LEDs between slots, up to 113 mm from anywhere an LED can be.
    From the front it looked right; from the side it did not, because a
    front camera barely constrains the edge of the sphere. The ears were
    a single flat sheet at y = 30 mm.
    mau5slots.py builds it the other way round. Positions only ever come
    from the CAD; two camera poses decide which slot. The chain is aligned
    to the CAD's wiring order by dynamic programming -- next slot,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
    [ears_stereo.csv, pixel_map.csv, pixel_map_cad.csv]
2026-10-29 Start plays the song, and the simulator looks like the rest of the site
    Starting a show lit the helmet in silence: the controller has no room
    for the songs, so the page had nothing to play unless the track had
    been picked first, separately, every time. Now start means the song
    plays. The first time, it asks for the file and keeps it in
    IndexedDB under the show's name -- which works on the controller's
    plain-http page -- and every start after that plays this phone's copy.
    Stop stops the song too. Running a show silently is still possible,
    as a button that says "lights only".
    The simulator does the same for visitors, picks the show from a song's
    filename, and keeps the song playing when yo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
2026-10-29 A film of how the map was found, and a stricter test of it
    mau5film.py renders ninety seconds from the data itself, in the
    website's drawing-sheet style: the CAD's 948 slots, the wiring order,
    the first night's footage, the map that graded itself seen from the
    side, the second camera with the shell triangulating onto the CAD's
    sphere (173.3 mm against 173.0), the alignment filling the shell strip
    by strip, the walk against the cameras, the ears inside their tubes,
    and the old map against the new from every side. The old map is kept
    as pixel_map_before_slots.csv for exactly that comparison.
    mau5slots now checks each camera the hard way -- the whole pipeline
    from the CAD, alone, with no help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
    [pixel_map_before_slots.csv]
2026-10-29 No profile no longer means no limit; the README describes this helmet
    A review turned up one thing that mattered. mau5power.load() promised
    "a deliberately timid" guard for a missing power.json and returned
    None, and every caller -- Pixels, the laptop controller -- read None as
    "no guard", while a malformed file raised into an `except: pass` with
    the same result. Deleting one JSON file gave a helmet with nothing
    between a white frame and 11.8 A. A missing profile is now timid
    (300 mA, an eighth of full drive), a broken one raises, and save()
    writes the floors and connector limit it used to drop. A test holds
    all three.
    Smaller: a strips.json that cannot be applied now says so instead of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
    [mau5ctl.py, mau5fx.py, mau5icon.py, mau5offline.py, mau5peek.py, mau5power.py, mau5preview.py, mau5review.py]
2026-10-30 The ears as blades, a beat the guard cannot flatten, and songs ready offline
    The map now says which ear tube each LED is in (0 lowest to 2, the same
    on both ears) and how far up it, from the CAD tube geometry -- the
    strip runs up each tube and back, so both rows share a height. Two
    effects use it. blades lights the tubes in turn on the beat, from the
    low end up with a hot front, then flashes everything on the fourth.
    matrix rained down arbitrary azimuth bins with the head trailing and
    switched the ears off -- in the shows' most-used effect; now it falls
    down every real strip and all six tubes, head first.
    The shows barely pulsed: 0.97-1.05 on-beat over off-beat. The pulse
    multiplied the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
    [pixel_map.csv]
2026-10-30 Phones get the show songs from the laptop, once, and keep them
    The songs cannot live on the controller -- 61 MB against under one free
    -- and cannot go anywhere public, so a show needed the mp3 to be on the
    phone already. `mau5offline.py songs` now serves them from the laptop
    and leaves /songs.json on the controller saying where; the page reads
    it, fetches whatever this phone is missing into its own storage, and
    from then on every show starts with its song with no laptop and no
    network. It looks again every twenty seconds while anything is
    missing, so it works whichever starts first.
    Checked with a fresh Chrome profile against the real controller: all
    five songs fetched and kept within fi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
    [mau5offline.py]
2026-10-30 One rim segment fewer, and the phone paced by the helmet instead of guessing
    The near ear's rim was a little long and its first segment was cut off.
    A segment is one pixel -- one driver chip under ten COB LEDs -- so the
    chain is now 621, every index from 492 on is one lower, and 621 lights
    nothing. Measured from the side camera after the cut, waiting out its
    1.1-1.5 s lag (the first probes were one LED late because of it): the
    near ear's tubes still end at 491, its rim from 495 on lands where the
    old 496 onwards projected, and the far ear's junctions and turns all
    arrive one index early. mau5slots.CUT re-keys the pose files, which
    predate the cut; the rebuilt map is the old one shifted by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
    [pixel_map.csv]
2026-10-30 Pipelined frames, metered live bands, soft eq tops, and room for more tests
    Work in progress overnight: two frames in flight with a ping+filler unit
    that keeps the padding aligned (one in flight tied a phone's frame rate to
    its WiFi round trip: 5-7 fps at 100 ms), live audio bands metered with a
    fast rise and gentle fall, eq bars with a soft top in both engines, and a
    tests_more/ folder the suite picks up. Not yet deployed.
2026-10-30 Each pose says which chain it was measured on, and the camera's lag is waited out
    mau5slots re-keyed every pose file past the cut, so a view re-measured
    since 2026-10-29 would have been shifted a second time: new 493 filed as
    492, ear2's first rim LED as ear1's last, every ear LED one place off.
    Now mau5locate stamps each row with the chain it was measured on and
    mau5slots re-keys per file; the two committed poses, which have no stamp,
    say it with a strong centroid at 621, which lights nothing now, and a file
    that says neither is refused rather than guessed. mau5baralign reads the
    front pose through the same re-keying. The rebuilt map is byte-identical.
    The phone camera shows a change 1.1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
2026-10-30 WLED's limiter at what the helmet can sustain, and the laptop tools stop lying
    The controller's own limiter has no memory, so whatever it allows it
    allows for ever -- and it is the only clamp on standby, boot and every
    hand-back. It was set to the per-frame budget plus standby (1621 mA,
    about 0.9 A of LED current), three times the sustained allowance.
    `config` now writes the bus caps from power.json's sustained watts
    plus standby and WLED's 100 mA board reserve (1016 mA), never above
    the old figure. The inert global keeps the old number because
    test_mau5 pins it. Nothing has been applied to the controller.
    mau5doctor: accepts 621 or 622 LEDs, no longer offers
    `--one-bus 623 --allow 0.3`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
    [mau5ctl.py, mau5doctor.py, mau5offline.py, mau5spotify.py]
2026-10-30 A beat the phone can see, shows that lock there too, and honest live bands
    The beat pulse was a third of a beat, 115 ms at 174 bpm, and the phone
    sends a frame every 36-70 ms, so each beat flashed at whatever height a
    frame happened to land on. It now holds its peak for 70 ms before the
    same decay, on both sides, and the floor between beats is set so a beat
    averages exactly what it did: same peak (the guarded frame), same mean
    current -- mau5tune reads 643/583/577/625/558 mA before and
    646/584/577/625/558 with only this change -- and beat contrast up from
    1.17-1.34 to 1.27-1.56. The downbeat accent is flat across the 80 ms
    is_downbeat allows, at the height that adds the same light as the o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
2026-10-30 A render loop that cannot die silently, a stop that stays stopped, and a helmet the dead man gives back
    The page, from the findings against a17b8ea (3, 4, 5, 6, 8, 9, 13, 14,
    20, 38, 49, 53):
    - tick() is wrapped: a frame that throws is skipped (the helmet keeps
    the last guarded frame) and three in a row stop the player, release
    the helmet and say why. Cycling resets params instead of carrying the
    last preset's into make(), which threw ('fire has no parameter
    color') and killed the loop; choose() keeps only a preset's own
    params, and set() trial-renders a value before taking it.
    - start() joins a start already on its way, is refused from a hidden
    page, and lets go if stopped or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
2026-10-30 The guard cannot be switched off by a NaN, and the shell stops pumping
    One NaN frame -- rainbow's period slider pulled to its left end was
    enough -- made the phone guard's current NaN, which no budget compares
    greater than, and its thermal level NaN for good: governor and thermal
    ramp off for the life of the page, 1940 mA sent against 1000 after ten
    minutes of white. Both guards now take anything that is not a number
    as dark and infinity as full before doing anything else, and the
    thermal bucket skips a reading that is not a number. A profile longer
    than the frame no longer reads past its end (the same NaN, 1950 mA),
    and an LED the profile does not describe goes out dark.
    The sliders cann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
    [mau5engine.py, mau5power.py, mau5wled.py]
2026-10-30 Extra test files add to a group, never replace it
    A tests_more file named after an existing group (shows.py, power.py)
    silently dropped the main suite's tests of that name; and a tests_more
    module importing test_mau5 got a second copy, so its notes were lost.
    [test_mau5.py]
2026-10-30 One frame in flight again, and a controller that restarts comes back lit
    Two or three frames in flight rebooted WLED 0.15.4 in every monitored
    sweep of the presets (free memory sliding under 80 kB, then a restart);
    one in flight ran sweep after sweep without one. So DEPTH is 1 and the
    filler is only sent when frames may overlap.
    A lost socket is usually such a restart, and the controller comes up off
    with one unfrozen segment: the page reconnected and sent frames into
    segments that no longer existed. Every reconnect while streaming now
    re-sends the layout, lit, with the dead man armed. Tests follow.
    [test_mau5.py]
2026-10-30 One frame in flight gives up on a lost pong sooner
    The waits for a lost pong were sized for several frames in flight: a
    1 s timeout plus up to 1.5 s for stragglers, which with one frame in
    flight froze the helmet for 2.5 s -- seen as a stall in a measured sweep.
    With one in flight a late pong credited to the next frame costs at most
    one frame of overlap, so it gives up after 600 ms and waits 300.
    Verified on the helmet: a controller restart mid-stream (WLED rb) is
    back to 26 fps with the layout restored after about 8 s, with no tap;
    deployed, every preset median 28.1 fps.
2026-10-30 The page shows how long a frame takes to reach the strip
    With one frame in flight that round trip caps the frame rate, and it is
    the number that tells a slow phone WiFi from a slow controller.
2026-10-30 No orphan sockets, one brightness request at a time, shows by name only
    Two openSocket() calls while one was still connecting -- start tapped
    during hello -- opened two WebSockets and left the loser open on the
    controller; extra clients cost it memory, and one or two appeared before
    each of tonight's restarts. A connect on its way is now shared, and a
    socket that opens late or beside a live one is closed.
    The brightness slider sent one POST per input event while streaming;
    now one at a time, the newest value sent when it returns.
    mau5ctl's /api/show joined a network-supplied name onto shows/, so it
    loaded any JSON on the disk; a show is now a bare .json name that exists.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
2026-10-30 The overnight report: what changed, the jitter honestly, decisions waiting
2026-10-30 Strobe (Dimension Remix): its own choreography, the breakbeat on the ears
    A scene treatment for the drum and bass remix, written in bars against
    its bar map and compiled into the show beside the cue list, which stays
    as the fallback.
    The analysis puts its bar line one beat early: the kick, every entry,
    both drops and every phrase restart land on its beat two, so every mark
    sits at .25. Drop 1 lands at bar 79.25 (1:50.4), drop 2 at 159.25
    (3:40.7), each after a bar with the bass pulled out; every phrase
    restart has a one-beat hole in the bass before it, and the helmet goes
    dark for exactly that beat.
    It quotes Strobe -- the same sixteen-spark constellation whenever the
    melody is alone, ice,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
2026-10-30 leavemealone gets its own choreography: chops, stops and a push
    A scene treatment for Fred again.. & Baby Keem - leavemealone, compiled
    into its show beside the untouched cue list. The analysis grid's bar
    line sits a beat before the music's downbeat (the bass lands on beat two
    of every grid bar), so every mark is at b.25, the beat the bass lands on.
    The ears are the two-step kit (kick on the rims on 1 and the and of 3,
    snare up the tubes on 2 and 4); eight looping warm sparks are the
    chopped vocal; each stop empties to the chop traded beat by beat between
    the left half + ear 1 and the right half + ear 2, plus one cold light.
    Hooks push heat outward in rings from the middle of the face, wit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
2026-10-30 Audio ranges as a player asks for them, and peek says how far apart it samples
    mau5ctl served "bytes=-128" -- the last 128 bytes, an ID3v1 probe -- as
    the first 129, sent a negative Content-Length for a start past the end,
    and raised out of the handler with no reply on "bytes=abc-" or a
    multi-range. Ranges are now parsed in one place: suffixes are the end
    of the file, a range wholly past the end is a 416, and anything not
    understood is served whole with a 200, as a server may always do. A
    POST whose Content-Length is not a length gets a 400 rather than
    silence, and a negative one no longer waits for the client to hang up.
    mau5peek never passed the bus length to live(), so --watch always s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
    [mau5ctl.py, mau5peek.py]
2026-10-30 The checking tools check what they say: map regions, the film's photo, skips
    mau5verify's ear spans were literals from before the cut: the colour-order
    check's "first rim" was on ear1's tubes, so the rim strips.json says is
    wired differently was never lit, and the ear checks ran onto the far ear
    and two LEDs past the chain. They come from the map's regions now, and
    nothing may run past the map's end as well as the walk's.
    mau5film drew the CAD ears on eye.jpg, mau5eye's live frame. It reads a
    photo of its own, data/cal/high_pose_daylight.jpg, and leaves the photo
    out of the scene when there is none.
    In the suite, a missing node is a skip the summary counts, not a pass;
    no LAN at all skip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
    [mau5film.py, mau5verify.py, test_mau5.py]
2026-10-30 Relay opens when asked, song refuses a stinger, cal stops trusting old frames
    Five review findings, each checked against the code before fixing.
    mau5relay: --allow-open answered 403 to everything, because an empty
    token matched nothing; it now opens, and only under that flag. Since
    open mode now works, --allow-open with --tunnel is refused: the tunnel
    is the whole internet. Tokens are compared as bytes, so a non-ASCII
    ?t= or a smart-quoted token is a wrong key instead of a TypeError that
    dropped the connection. relay_url.txt is written after the SSH tunnel
    is up, so the shell host reaches it at last.
    mau5song: a clip too short for the 41-frame onset baseline, or for
    three whole bars, is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
    [mau5build.py, mau5cal.py, mau5relay.py, mau5song.py]
2026-10-30 Binary frames when the controller is WLED 16 or later
    WLED 16 takes DDP over the page's WebSocket: no JSON to parse and no
    reply per message, the two things 0.15.4 could not keep up with (read in
    v16.0.1's ws.cpp and e131.cpp: binary frames draw no answer, and a packet
    longer than its header says is fine, so the usual padding stays). The
    page switches only when /json/info says 16 or later, so a helmet still on
    0.15.4 keeps the soak-tested JSON path and one frame in flight. Binary
    allows three frames in flight, which is what lifts a phone off its WiFi
    round trip. Release now also sends live:false to leave realtime at once.
2026-10-30 On WLED 16 the filler is binary, so nothing takes the JSON lock
    The text filler made WLED 16 take its JSON buffer lock for padding, and
    when something else held it the answer was {"error":3} -- 897 in one
    sweep. A binary message with protocol byte 0xFF has no case in WLED's
    binary switch: dropped, no lock, no reply. Measured after the change on
    the helmet, now on 16.0.1: 0 refused, every preset median 23.5 fps with a
    phone-like 100 ms round trip (5-8 fps on 0.15.4), no restart.
2026-11-01 Videos for the website, with music we can host
    tools/film renders the show reel, the song data film and the live analysis
    film. Each goes through the real engine and guard. score.py writes the music,
    since the songs can't be hosted: for a song it plays the measured grid and
    band curves with its own chords. livefilm runs the real audio.js over a track.
    The two older films get plainer captions. Old status reports and stray images
    move out of the repo root.
2026-11-01 Add the helmet CAD (v18), build guide, design write-up and a wall mount
    - cad/source: the parametric CadQuery generator for every printed part (v18),
    the visor perforation script, and a new wall mount generator
    - cad/parts, cad/visor, cad/assembly: current STEP / 3MF / STL for printing
    (shell halves, ears with the open wire path, visor in five hole patterns,
    pivot caps, crown frame + spacers for the 3M hat, tray, wall mount)
    - cad/reference: CAD pixel map and the original wiring plan and BOM
    - cad/render: the three.js + Playwright pipeline behind the renders and film
    - docs/build-guide.md, docs/cad-design.md, docs/img/cad: assembly steps,
    the design story, renders, GIFs
    - README: a s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
    [BOM_original_plan.csv, ear_L.step, ear_R.step, ear_half_bottom.step, ear_half_top.step, electronics_tray.step, hardhat_envelope_REFERENCE.step, hat_crown_frame.step]
2026-11-01 Add the 40 s CAD film to docs/img/cad
    Releases can't be created from this session, so the film lives beside the
    GIFs, with a one-file exception to the *.mp4 ignore rule.
    Claude-Session: https://claude.ai/code/session_01BVo7D7kNEjGLYCsZ7E6aVS
2026-11-01 CAD walkthrough film: 1080p, chapters, and a staged exploded view
    The render pipeline, placement checks, and the music step in build.py. The film
    itself goes to the website, since it has a song in it.
2026-11-05 CAD: neck as printed (trimmed 1/2", no baffle); wall-mount pads re-cut for it
    - mau5head_hat.py: NECK_Z -143.3 -> -130.6, the cut the shell was printed with;
    the neck baffle is built only on the full-length neck (NECK_BAFFLE), and the
    neck is cut again after the bosses so nothing hangs below the rim
    - shell_half_BOTTOM, shell and assembly STEPs regenerated (pixel map unchanged)
    - wall_mount.py: pads carved for the new rim: a felt ledge the rim sits on plus
    the concave seat; checked against the new shell (no interference, rim lands
    on the ledges at the felt thickness)
    - docs updated
    Claude-Session: https://claude.ai/code/session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
    [shell_half_BOTTOM.step, wallmount_ASSEMBLY.step, wallmount_cradle.step, wallmount_cradle.stl]
